ChriD/konnekting-TouchButtonSwitch/Bild 2.png

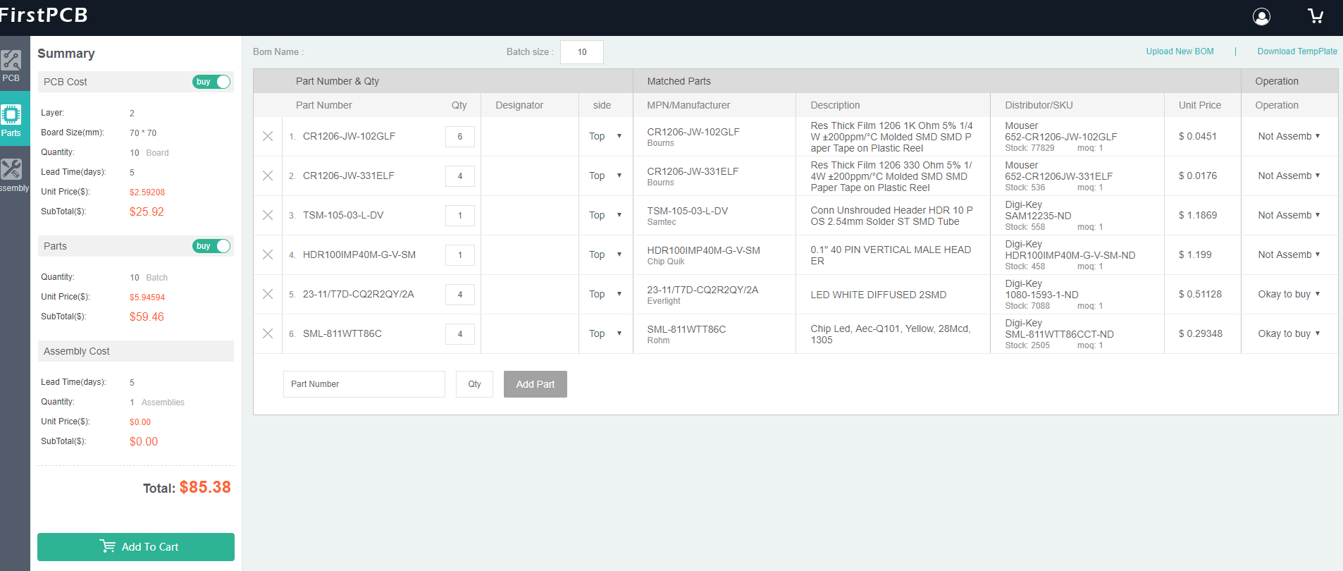
Bild 2.png
