ChriD/konnekting-TouchButtonSwitch/eagle/4xTouchTaster_Schematik.png

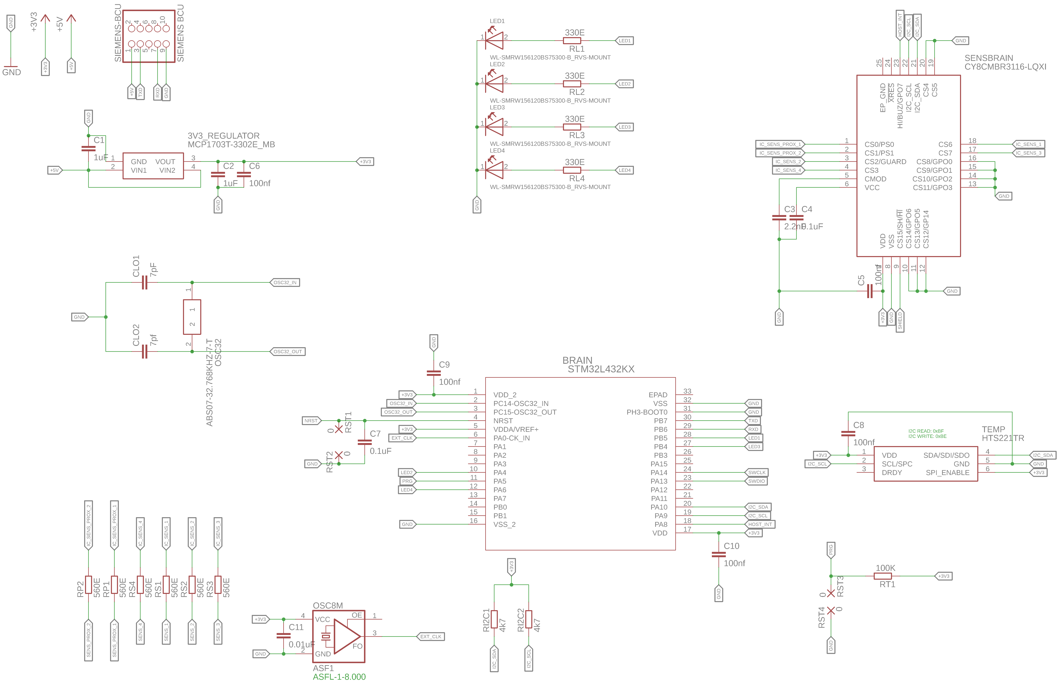
eagle/4xTouchTaster_Schematik.png
