ChriD/konnekting-TouchButtonSwitch/eagle/5ButtonSwitch.ItsyBitsyM0.Rev1.0.b.png

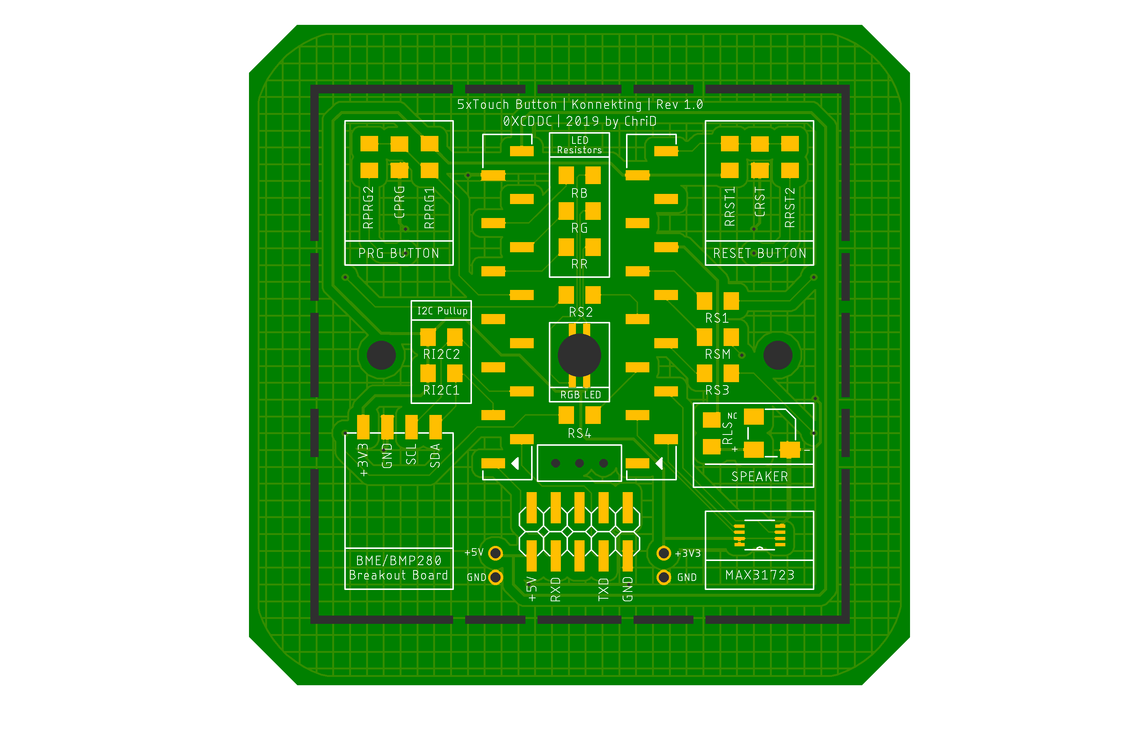
eagle/5ButtonSwitch.ItsyBitsyM0.Rev1.0.b.png
