ChriD/konnekting-TouchButtonSwitch/eagle/5ButtonSwitch.ItsyBitsyM0.Rev1.0.png

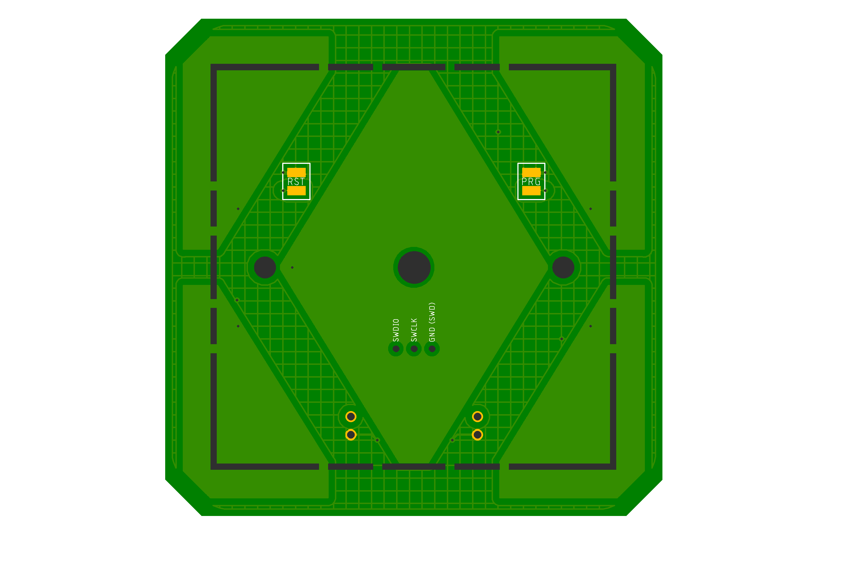
eagle/5ButtonSwitch.ItsyBitsyM0.Rev1.0.png
