ChriD/konnekting-TouchButtonSwitch/BOM.ods

 | Taster Stückliste
 |  |  |  |  | Dist | Package | Pins | Qty | Price
1 | TPS70933DBVT |  |  | TPS70933DBVT | TI | SOT95P280X145-5N | 5 | 1 | € 0,62 | € 0,62
2 | CGA2B3X7R1H104K050BB (https://product.tdk.com/en/search/capacitor/ceramic/mlcc/info?part_no=CGA2B3X7R1H104K050BB) |  | CGA2B3X7R1H104K050BE (https://www.mouser.at/ProductDetail/TDK/CGA2B3X7R1H104K050BE) | 100nF | TDK | C0402 | 2 | 9 | € 0,18 | € 1,61
3 | TDK C1005X5R0J475K050BC |  |  | 4.7 uf | TDK | C0402 | 2 | 1 | € 0,34 | € 0,34
 | C2 | C2 |  | 2.2uf | TDK | C0402 | 2 | 1
4 | CGA2B3X7R1H103K050BD | C1005X7R1H103K050BE (https://product.tdk.com/en/search/capacitor/ceramic/mlcc/info?part_no=C1005X7R1H103K050BE) |  | 10nf | TDK | C0402 | 2 | 1 | € 0,17 | € 0,17
5 | C1005X5R1V105K050BE (https://product.tdk.com/en/search/capacitor/ceramic/mlcc/info?part_no=C1005X5R1V105K050BE) | C1005X5R1V105K050BE (https://product.tdk.com/en/search/capacitor/ceramic/mlcc/info?part_no=C1005X5R1V105K050BE) | 35V | 1 uf | TDK | C0402 | 2 | 2 | € 0,16 | € 0,32
6 | CGA2B2X7R1H222K050BA (https://product.tdk.com/en/search/capacitor/ceramic/mlcc/info?part_no=CGA2B2X7R1H222K050BA) | C1005X7R1H222K050BE (https://product.tdk.com/en/search/capacitor/ceramic/mlcc/info?part_no=C1005X7R1H222K050BE) |  | 2.2 nF | TDK | C0402 | 2 | 1 | € 0,15 | € 0,15
7 | TDK CGA2B2C0G1H070D050BA |  |  | 7 pF | TDK | C0402 | 2 | 2 | € 0,09 | € 0,17
8 | Osram Opto LW P473-Q2S1-FKPL-1 |  |  |  | Osram | P47F-BOTTOM | 2 | 4 | € 0,83 | € 3,32
9 | STM32F303RET6 |  |  | STM32F303RET6 | STMicroelectronics | QFP50P1200X1200X160-64N | 64 | 1 | € 6,11 | € 6,11
10 | ABS07-32.768KHZ-7-T |  |  |  | Abracon | ABS-07 | 2 | 1 | € 0,58 | € 0,58
11 | MF-RES-0402-4.7K |  |  | 4.7k |  | R0402 | 2 | 2 |  | 0
12 |  |  |  | 330 ohm |  | R0402 | 2 | 4 |  | 0
13 |  |  | 17 | 460 ohm |  | R0402 | 2 | 7 |  | 0
14 | 5% 100mW |  |  | 100k |  | R0402 | 2 | 1 |  | 0
15 | Samtec TSM-105-03-L-DV |  |  |  | Samtec | 2X05SMD | 10 | 1 | € 1,40 | € 1,40
16 | Cypress Semiconductor CY8CMBR3116-LQXI |  |  | CY8CMBR3116-LQXI | Cypress | QFN50P400X400X60-25N | 24 | 1 | € 2,50 | € 2,50
17 | STMicroelectronics HTS221TR |  |  | HTS221TR | STMicroelectronics | HLGA-6L | 5 | 1 | € 2,95 | € 2,95
 |  | Count | Boards | Shipping | Assembly | Parts
 | https://www.allpcb.com/online_pcb_quote.html | 30 | 82 | 0 | 325 |  | 407
 | https://www.elecrow.com/services.html | 30 | 99 | 33 | 177 |  | 309
 | https://www.wellpcb.com/ | 30 | 73 | 0 | ?
 | https://www.pcbcart.com/de/quote | 30 | 315 | ? | ? |  | ?
 | https://www.pcbgogo.com | 30 | 146 | 36 | 50 |  | 232
 | https://www.seeedstudio.com/fusion_pcb.html | 30 | 154,81 | ? | ? |  | ?
