ChriD/konnekting-TouchButtonSwitch/BOM_Template_2017_06_30.xlsx

Designator | Manufacturer Part Number | Quantity
3V3_VR | TPS70933DBVT | 1
MCU | STM32F303RET6 | 1
SENSORMCU | CY8CMBR3116-LQXI | 1
TEMP | HTS221TR | 1
C11 | C1005X5R0J475K050BC | 1
