ChriD/konnekting-TouchButtonSwitch/58325233.xlsx

# | Menge | Teilenummer | Hersteller-Teilenummer | Beschreibung | Kundenreferenz | Lieferrückstände | Stückpreis | Gesamtpreis
1 | 15 | 1528-2554-ND | 3727 | ITSYBITSY M0 EXPRESS |  | 0 | 1036000 | 15540
2 | 25 | 1080-1593-1-ND | 23-11/T7D-CQ2R2QY/2A | LED WHITE DIFFUSED 2SMD |  | 0 | 40280 | 1007
3 | 5 | HDR100IMP40M-G-V-SM-ND | HDR100IMP40M-G-V-SM | CONN HEADER SMD 40POS 2.54MM |  | 0 | 95000 | 475
4 | 10 | SAM12235-ND | TSM-105-03-L-DV | CONN HEADER SMD 10POS 2.54MM |  | 0 | 93500 | 935
5 | 100 | CR1206-JW-331ELFCT-ND | CR1206-JW-331ELF | RES SMD 330 OHM 5% 1/4W 1206 |  | 0 | 1740 | 174
6 | 100 | CR1206-JW-102GLFCT-ND | CR1206-JW-102GLF | RES SMD 1K OHM 5% 1/4W 1206 |  | 0 | 2570 | 257
7 | 100 | CR1206-JW-103GLFCT-ND | CR1206-JW-103GLF | RES SMD 10K OHM 5% 1/4W 1206 |  | 0 | 2570 | 257
8 | 100 | 311-1435-1-ND | CC1206JRX7R9BB104 | CAP CER 0.1UF 50V X7R 1206 |  | 0 | 8810 | 881
9 | 8 | MAX31723MUA+TCT-ND | MAX31723MUA+T | SENSOR DIGITAL -55C-125C 8UMAX |  | 0 | 311000 | 2488
