ChriD/konnekting-TouchButtonSwitch/eagle/5ButtonSwitch.ItsyBitsyM0.Rev1.2.brd

## EAGLE design eagle/5ButtonSwitch.ItsyBitsyM0.Rev1.2.brd (2019-08-25)

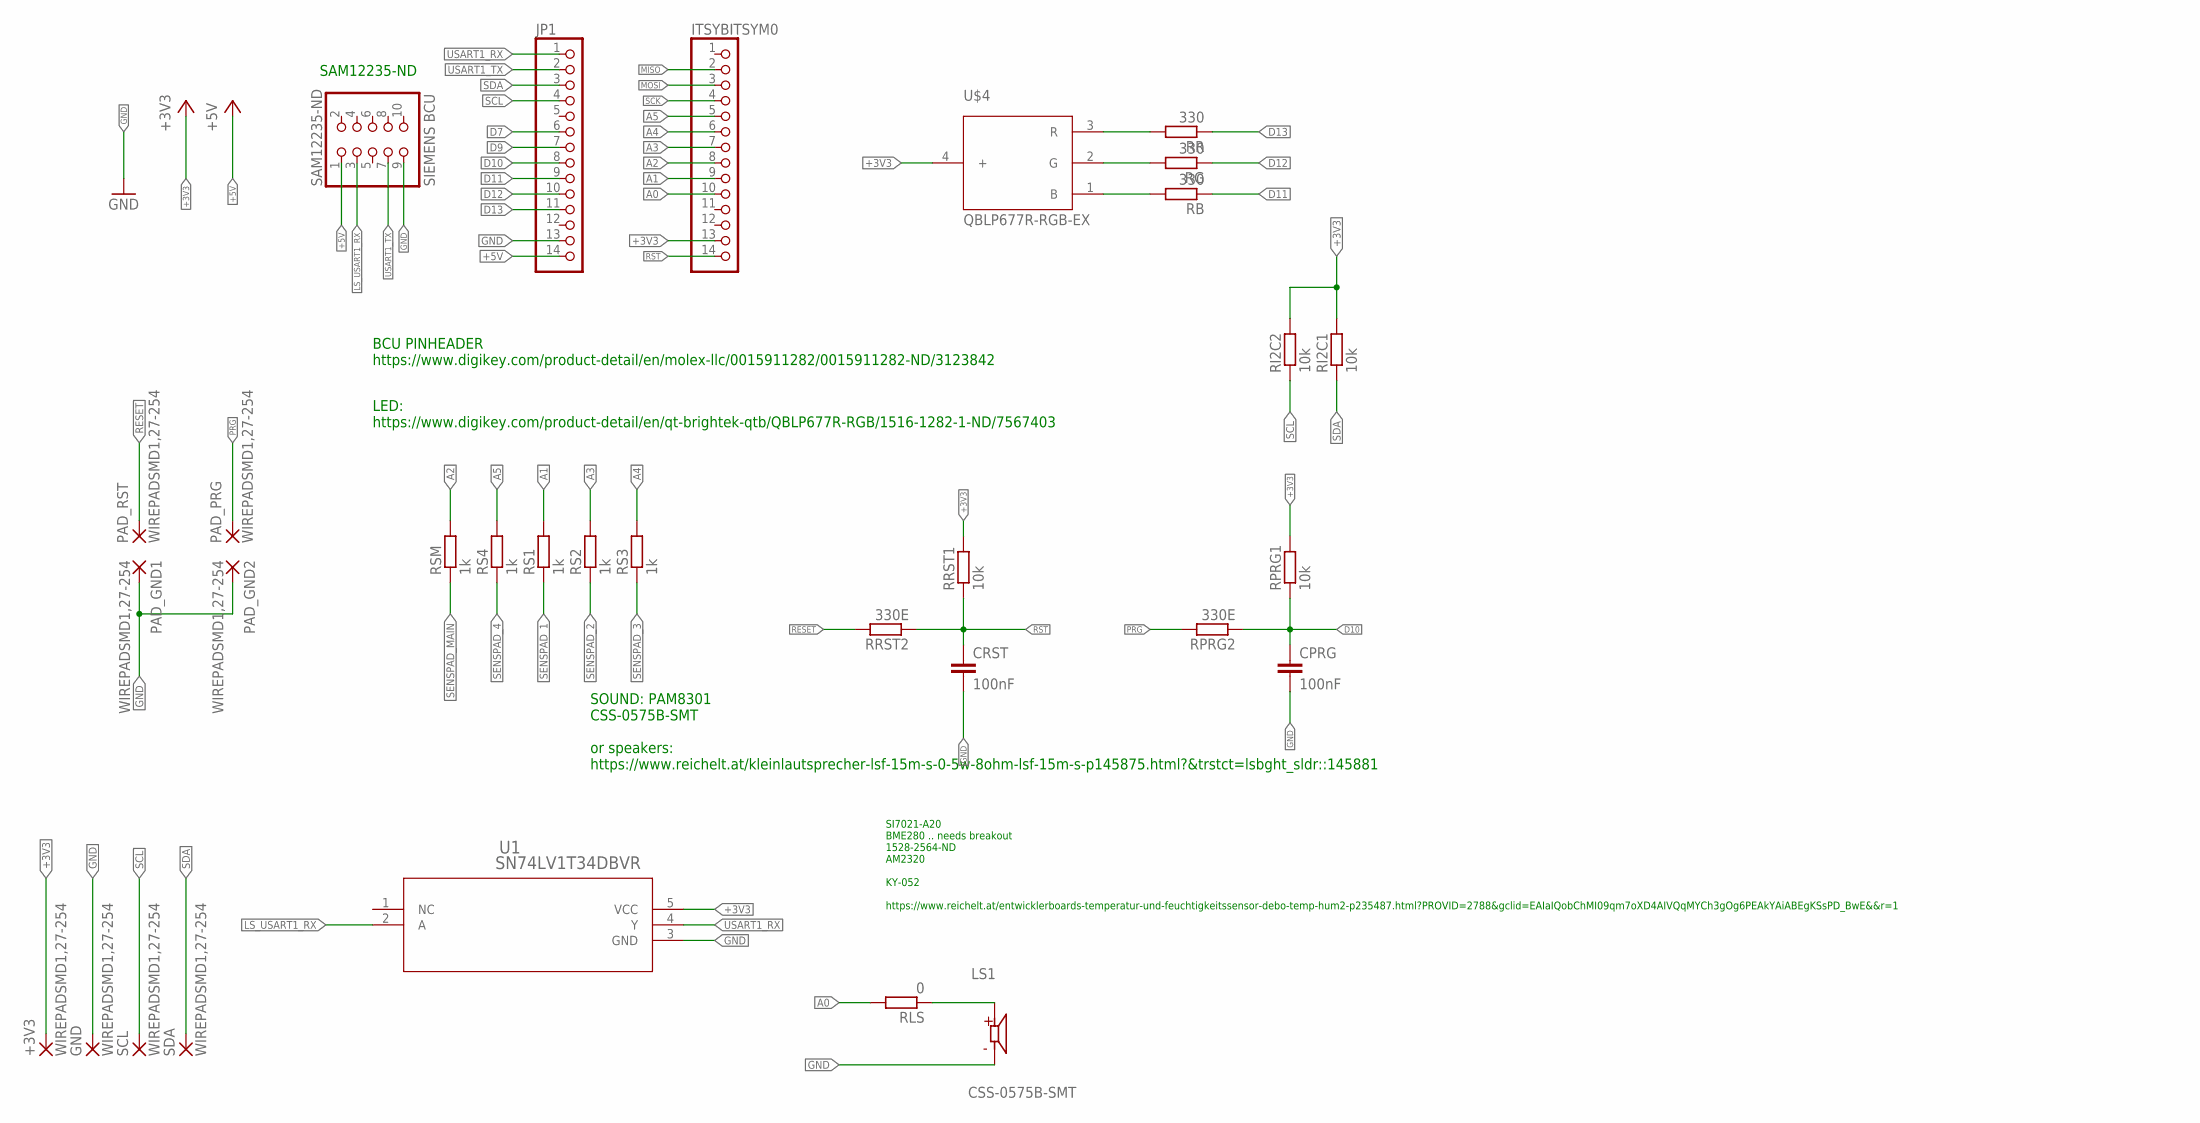
[picture p5: schematic 5ButtonSwitch.ItsyBitsyM0.Rev1.2.sch]

Parts:
+3V3: WIREPADSMD1,27-254; SMD1,27-2,54
CPRG: 100nF; C1206
CRST: 100nF; C1206
GND: WIREPADSMD1,27-254; SMD1,27-2,54
ITSYBITSYM0: PINHD-1X141X14_SMT; 1X14_SMT
JP1: PINHD-1X141X14_SMT; 1X14_SMT
LS1: CSS-0575B-SMT; CUI_CSS-0575B-SMT
PAD_GND1, PAD_GND2: WIREPADSMD1,27-254; SMD1,27-2,54
PAD_PRG: WIREPADSMD1,27-254; SMD1,27-2,54
PAD_RST: WIREPADSMD1,27-254; SMD1,27-2,54
RB: 330; R1206
RG: 330; R1206
RI2C1, RI2C2: 10k; R1206
RLS: 0; R1206
RPRG1: 10k; R1206
RPRG2: 330E; R1206
RR: 330; R1206
RRST1: 10k; R1206
RRST2: 330E; R1206
RS1, RS2, RS3, RS4: 1k; R1206
RSM: 1k; R1206
SAM12235-ND: SIEMENS BCU; 2X05SMD
SCL: WIREPADSMD1,27-254; SMD1,27-2,54
SDA: WIREPADSMD1,27-254; SMD1,27-2,54
U1: SN74LV1T34DBVR; DBV5
U$4: QBLP677R-RGB-EX; PLCC4R_EX

Connections:
+3V3: +3V3.1, ITSYBITSYM0.13, RI2C1.2, RI2C2.2, RPRG1.2, RRST1.2, U1.5 (VCC), U$4.4 (+)
+5V: JP1.14, SAM12235-ND.1
A0: ITSYBITSYM0.10, RLS.2
A1: ITSYBITSYM0.9, RS1.2
A2: ITSYBITSYM0.8, RSM.2
A3: ITSYBITSYM0.7, RS2.2
A4: ITSYBITSYM0.6, RS3.2
A5: ITSYBITSYM0.5, RS4.2
D7: JP1.6
D9: JP1.7
D10: CPRG.1, JP1.8, RPRG1.1, RPRG2.1
D11: JP1.9, RB.1
D12: JP1.10, RG.1
D13: JP1.11, RR.1
GND: CPRG.2, CRST.2, GND.1, JP1.13, LS1.2 (N), PAD_GND1.1, PAD_GND2.1, SAM12235-ND.9, U1.3 (GND)
LS_USART1_RX: SAM12235-ND.3, U1.2 (A)
MISO: ITSYBITSYM0.2
MOSI: ITSYBITSYM0.3
unnamed: RB.2, U$4.1 (B)
unnamed: RG.2, U$4.2 (G)
unnamed: RR.2, U$4.3 (R)
unnamed: LS1.1, RLS.1
PRG: PAD_PRG.1, RPRG2.2
RESET: PAD_RST.1, RRST2.2
RST: CRST.1, ITSYBITSYM0.14, RRST1.1, RRST2.1
SCK: ITSYBITSYM0.4
SCL: JP1.4, RI2C2.1, SCL.1
SDA: JP1.3, RI2C1.1, SDA.1
SENSPAD_1: RS1.1
SENSPAD_2: RS2.1
SENSPAD_3: RS3.1
SENSPAD_4: RS4.1
SENSPAD_MAIN: RSM.1
USART1_RX: JP1.1, U1.4 (Y)
USART1_TX: JP1.2, SAM12235-ND.7

Notes on the sheet:
SAM12235-ND
BCU PINHEADER https://www.digikey.com/product-detail/en/molex-llc/0015911282/0015911282-ND/3123842
LED: https://www.digikey.com/product-detail/en/qt-brightek-qtb/QBLP677R-RGB/1516-1282-1-ND/7567403
SI7021-A20 BME280 .. needs breakout 1528-2564-ND AM2320 KY-052 https://www.reichelt.at/entwicklerboards-temperatur-und-feuchtigkeitssensor-debo-temp-hum2-p235487.html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
SOUND: PAM8301 CSS-0575B-SMT or speakers: https://www.reichelt.at/kleinlautsprecher-lsf-15m-s-0-5w-8ohm-lsf-15m-s-p145875.html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

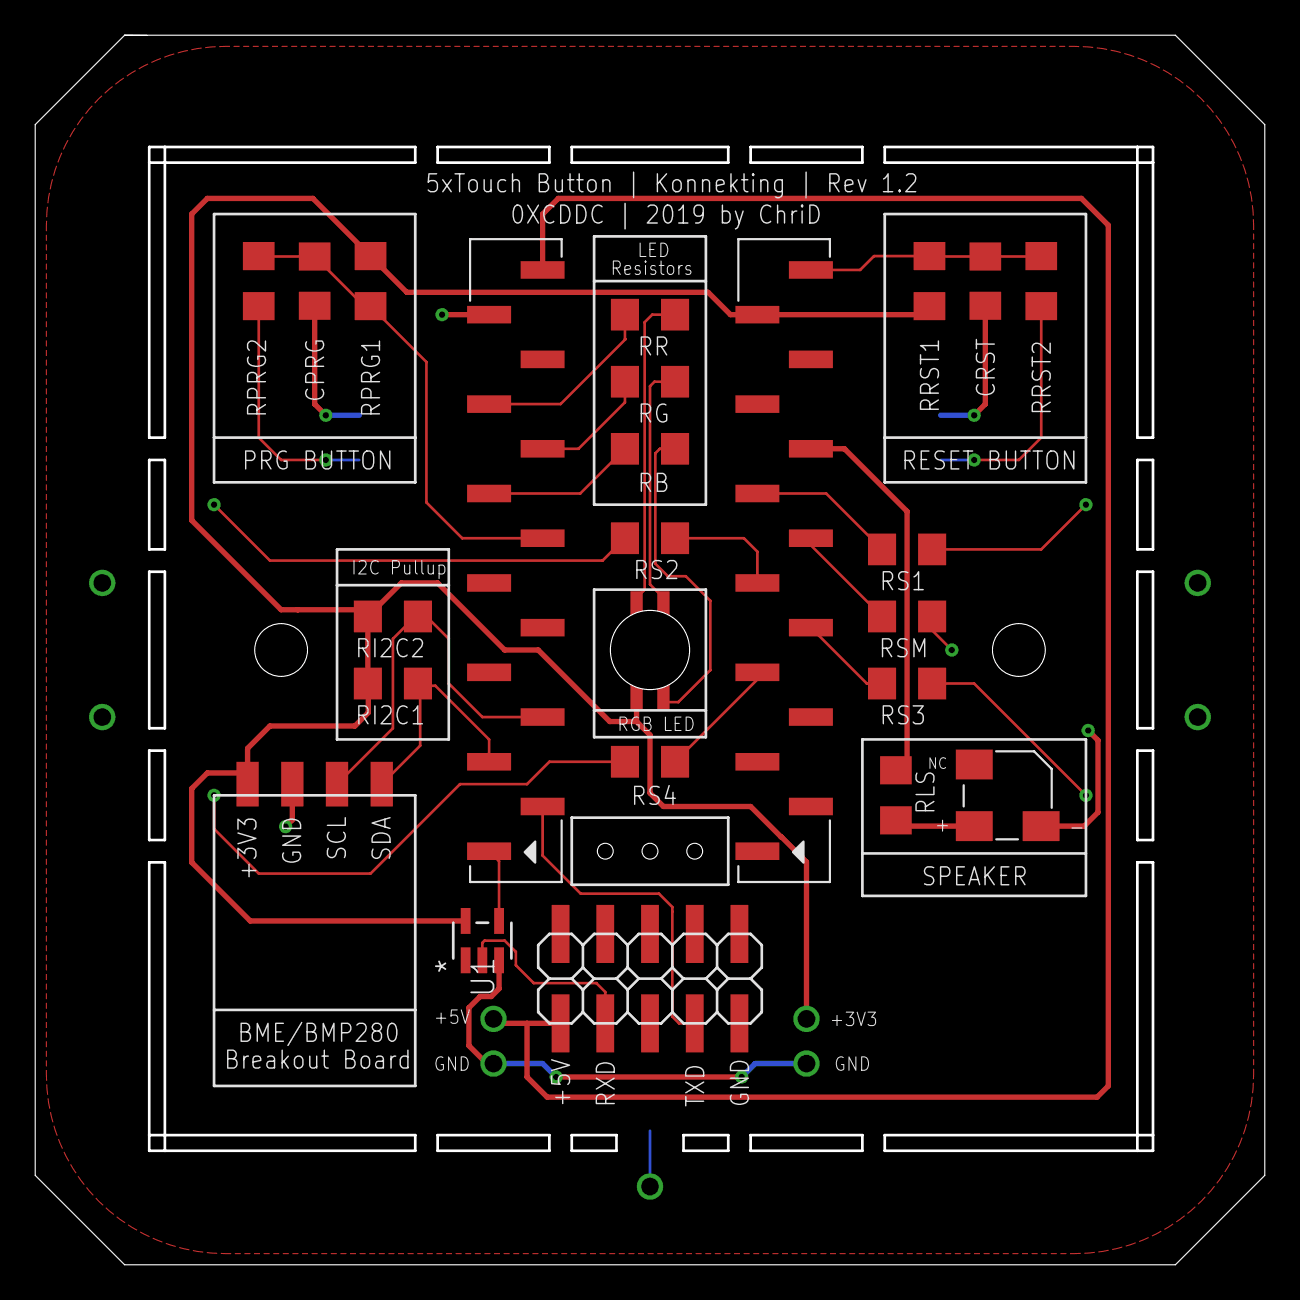
[picture p6: board 5ButtonSwitch.ItsyBitsyM0.Rev1.2.brd from above]

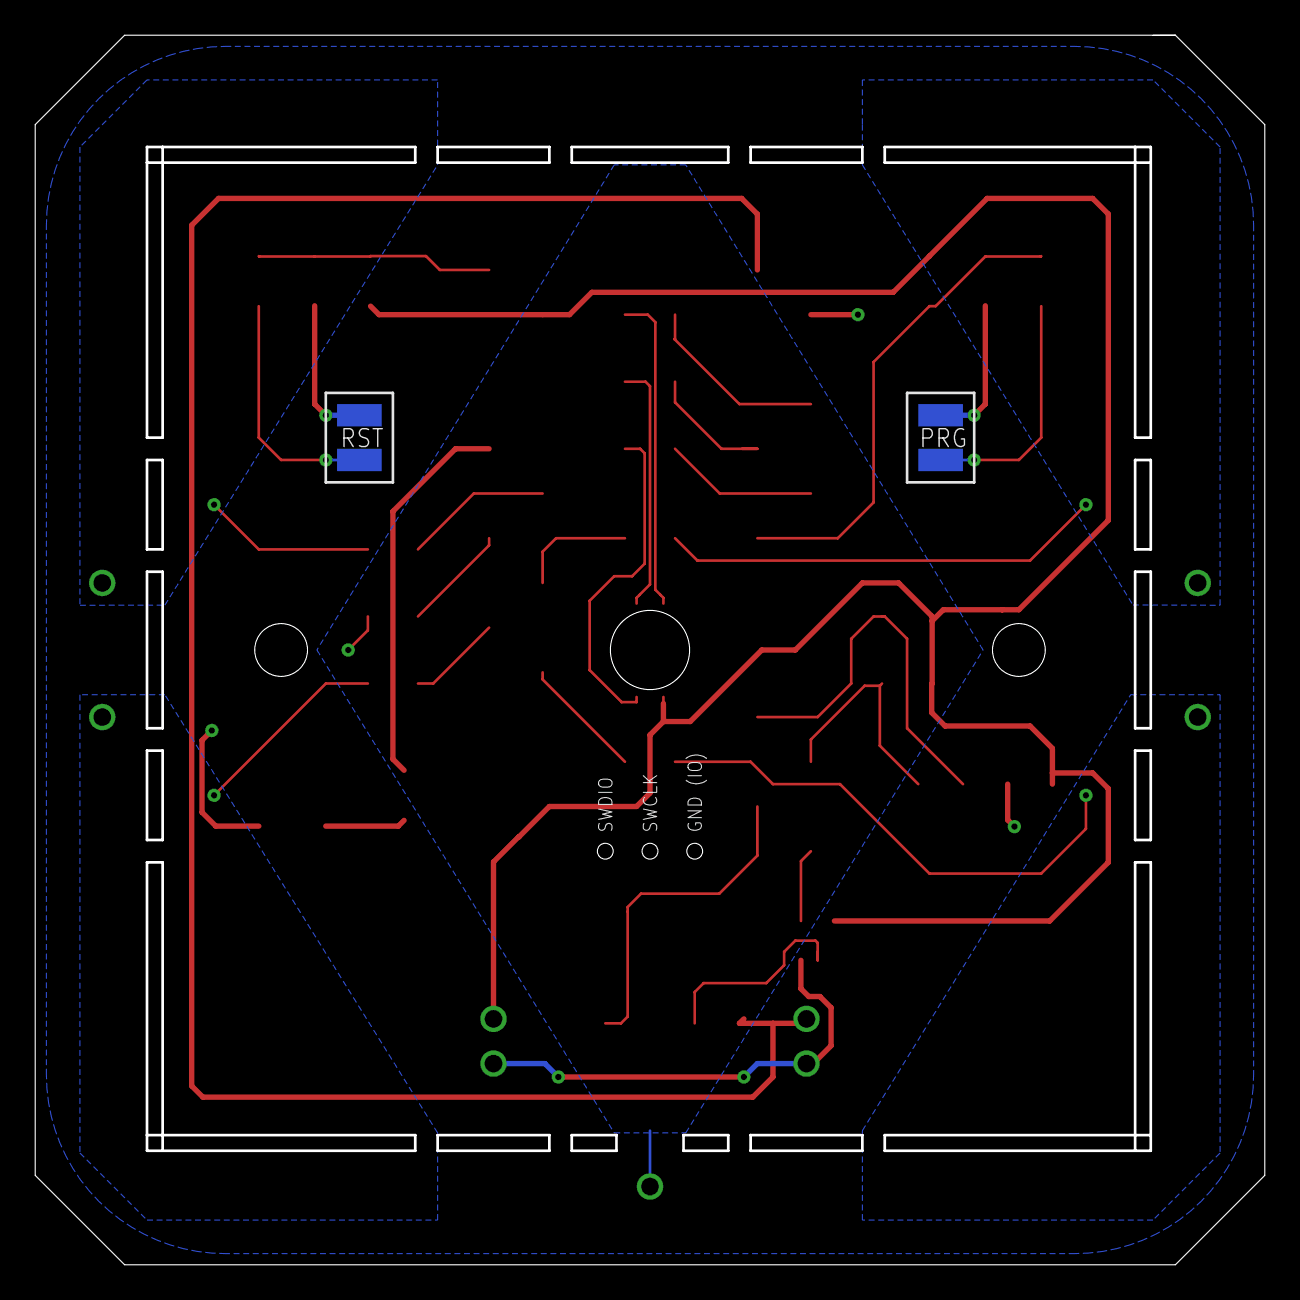
[picture p7: board 5ButtonSwitch.ItsyBitsyM0.Rev1.2.brd from below]

Board: 2 copper layers, 69.8 x 69.8 mm, 31 parts (4 on the bottom side), 25 nets.
