ChriD/konnekting-TouchButtonSwitch/eagle/1ButtonSwitch.ItsyBitsyM0.Rev1.0.brd

## EAGLE design eagle/1ButtonSwitch.ItsyBitsyM0.Rev1.0.brd (2019-03-04)

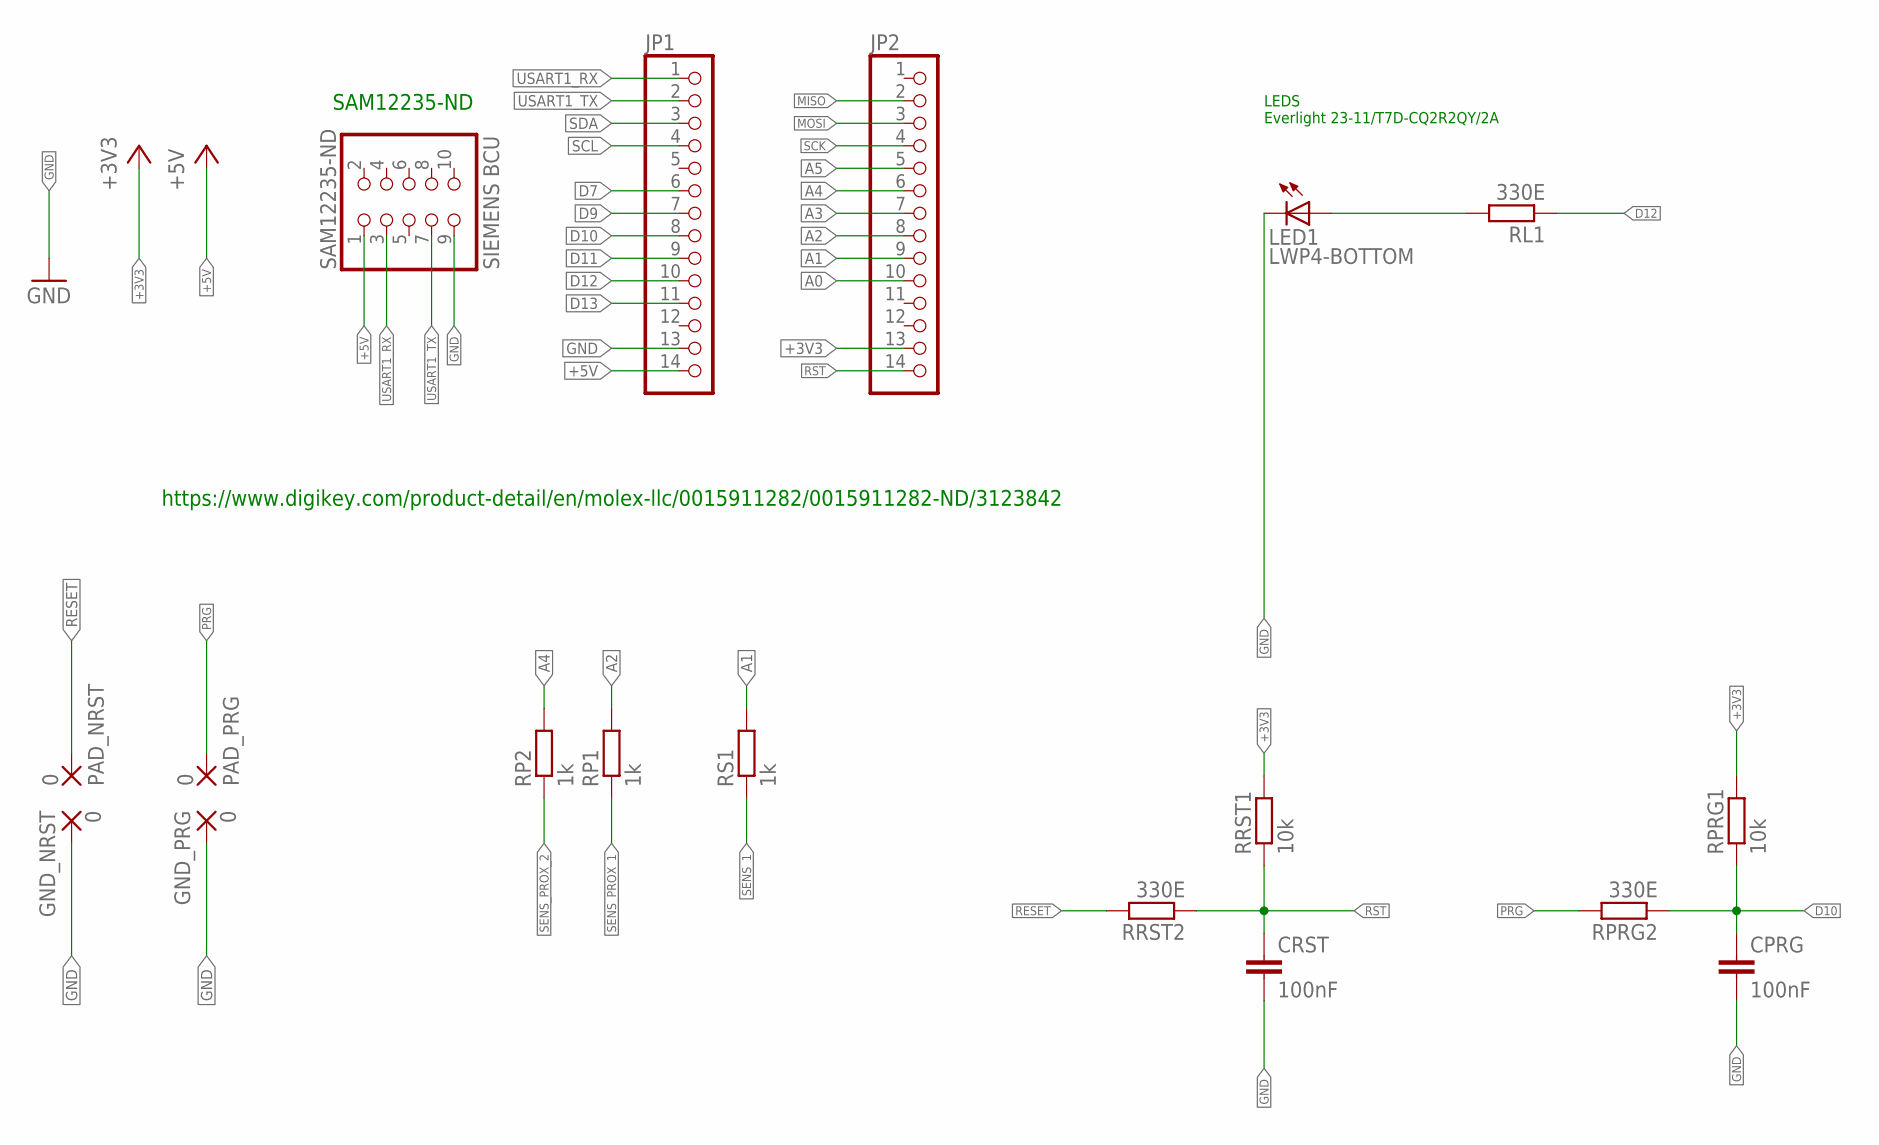
[picture p8: schematic 1ButtonSwitch.ItsyBitsyM0.Rev1.0.sch]

Parts:
CPRG: 100nF; C1206
CRST: 100nF; C1206
GND_NRST: 0; SMD2,54-5,08
GND_PRG: 0; SMD2,54-5,08
JP1, JP2: PINHD-1X141X14_SMT; 1X14_SMT
LED1: LWP4-BOTTOM; P47F-BOTTOM
PAD_NRST: 0; SMD2,54-5,08
PAD_PRG: 0; SMD2,54-5,08
RL1: 330E; R1206
RP1, RP2: 1k; R1206
RPRG1: 10k; R1206
RPRG2: 330E; R1206
RRST1: 10k; R1206
RRST2: 330E; R1206
RS1: 1k; R1206
SAM12235-ND: SIEMENS BCU; 2X05SMD

Connections:
+3V3: JP2.13, RPRG1.2, RRST1.2
+5V: JP1.14, SAM12235-ND.1
A0: JP2.10
A1: JP2.9, RS1.2
A2: JP2.8, RP1.2
A3: JP2.7
A4: JP2.6, RP2.2
A5: JP2.5
D7: JP1.6
D9: JP1.7
D10: CPRG.1, JP1.8, RPRG1.1, RPRG2.1
D11: JP1.9
D12: JP1.10, RL1.1
D13: JP1.11
GND: CPRG.2, CRST.2, GND_NRST.1, GND_PRG.1, JP1.13, LED1.C, SAM12235-ND.9
MISO: JP2.2
MOSI: JP2.3
unnamed: LED1.A, RL1.2
PRG: PAD_PRG.1, RPRG2.2
RESET: PAD_NRST.1, RRST2.2
RST: CRST.1, JP2.14, RRST1.1, RRST2.1
SCK: JP2.4
SCL: JP1.4
SDA: JP1.3
SENS_1: RS1.1
SENS_PROX_1: RP1.1
SENS_PROX_2: RP2.1
USART1_RX: JP1.1, SAM12235-ND.3
USART1_TX: JP1.2, SAM12235-ND.7

Notes on the sheet:
SAM12235-ND
LEDS Everlight 23-11/T7D-CQ2R2QY/2A
https://www.digikey.com/product-detail/en/molex-llc/0015911282/0015911282-ND/3123842

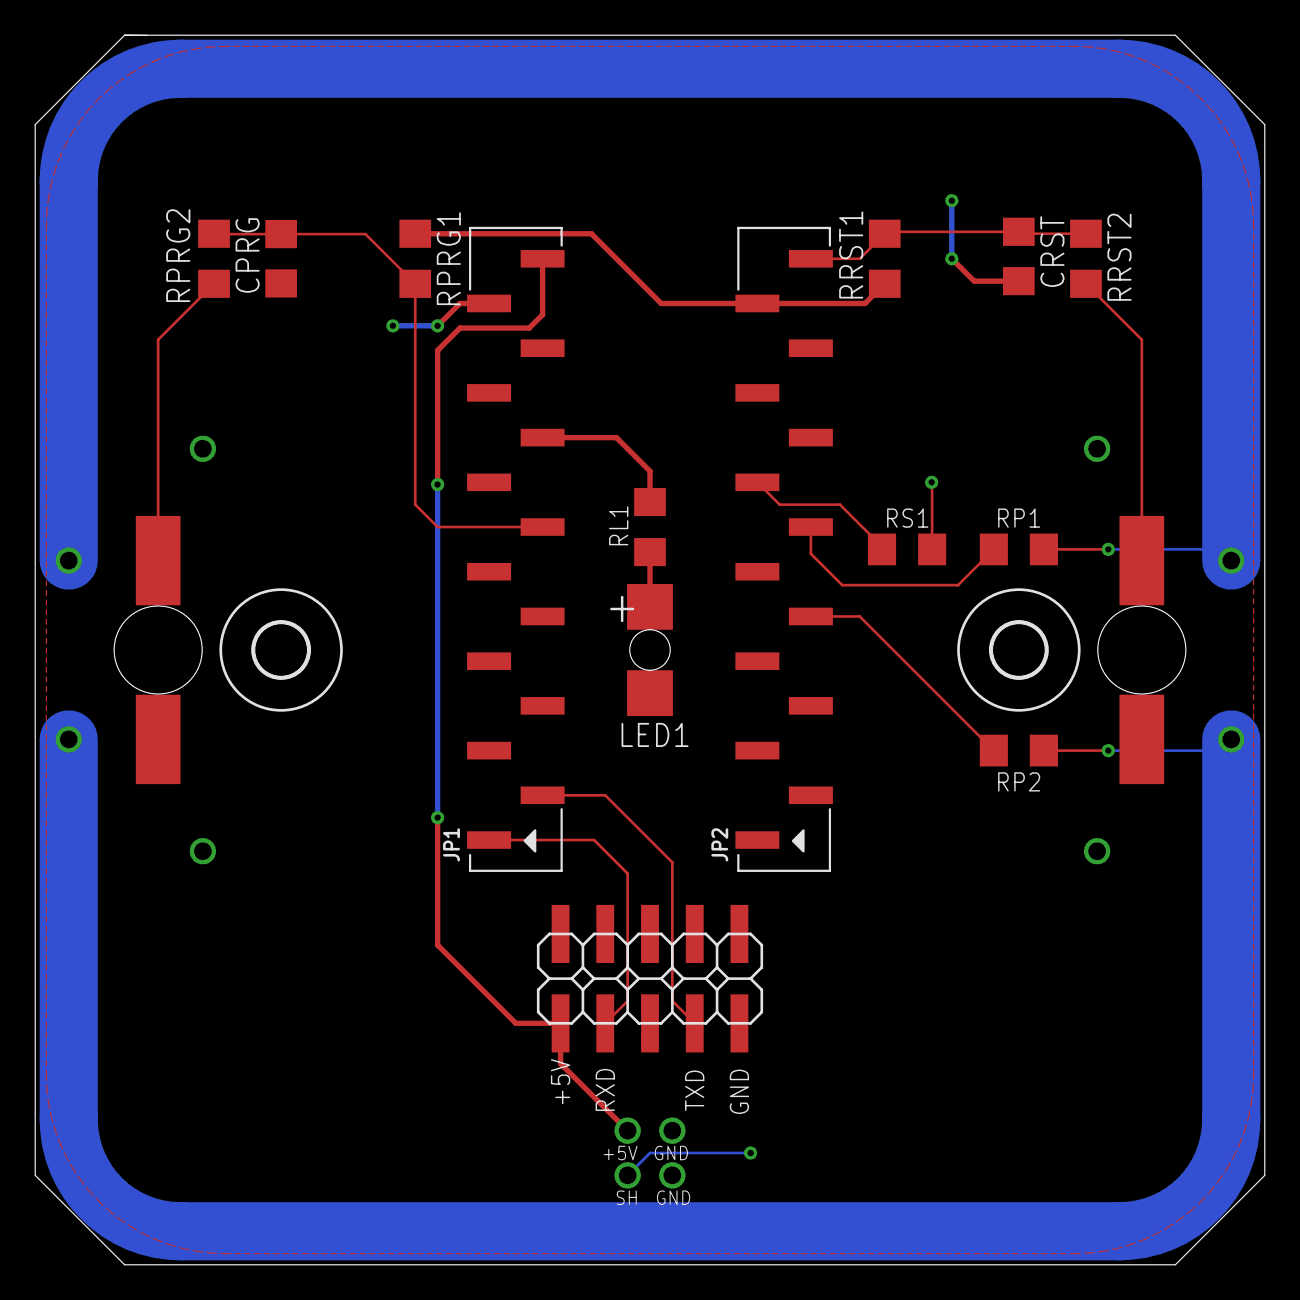
[picture p9: board 1ButtonSwitch.ItsyBitsyM0.Rev1.0.brd from above]

Board: 2 copper layers, 69.8 x 69.8 mm, 20 parts (0 on the bottom side), 14 nets.

Other parts of the board:
U$1, U$2: 3,0
