ChriD/konnekting-TouchButtonSwitch/eagle/4ButtonSwitch.Rev3.0.brd

## EAGLE design eagle/4ButtonSwitch.Rev3.0.brd (2018-12-17, an earlier design)

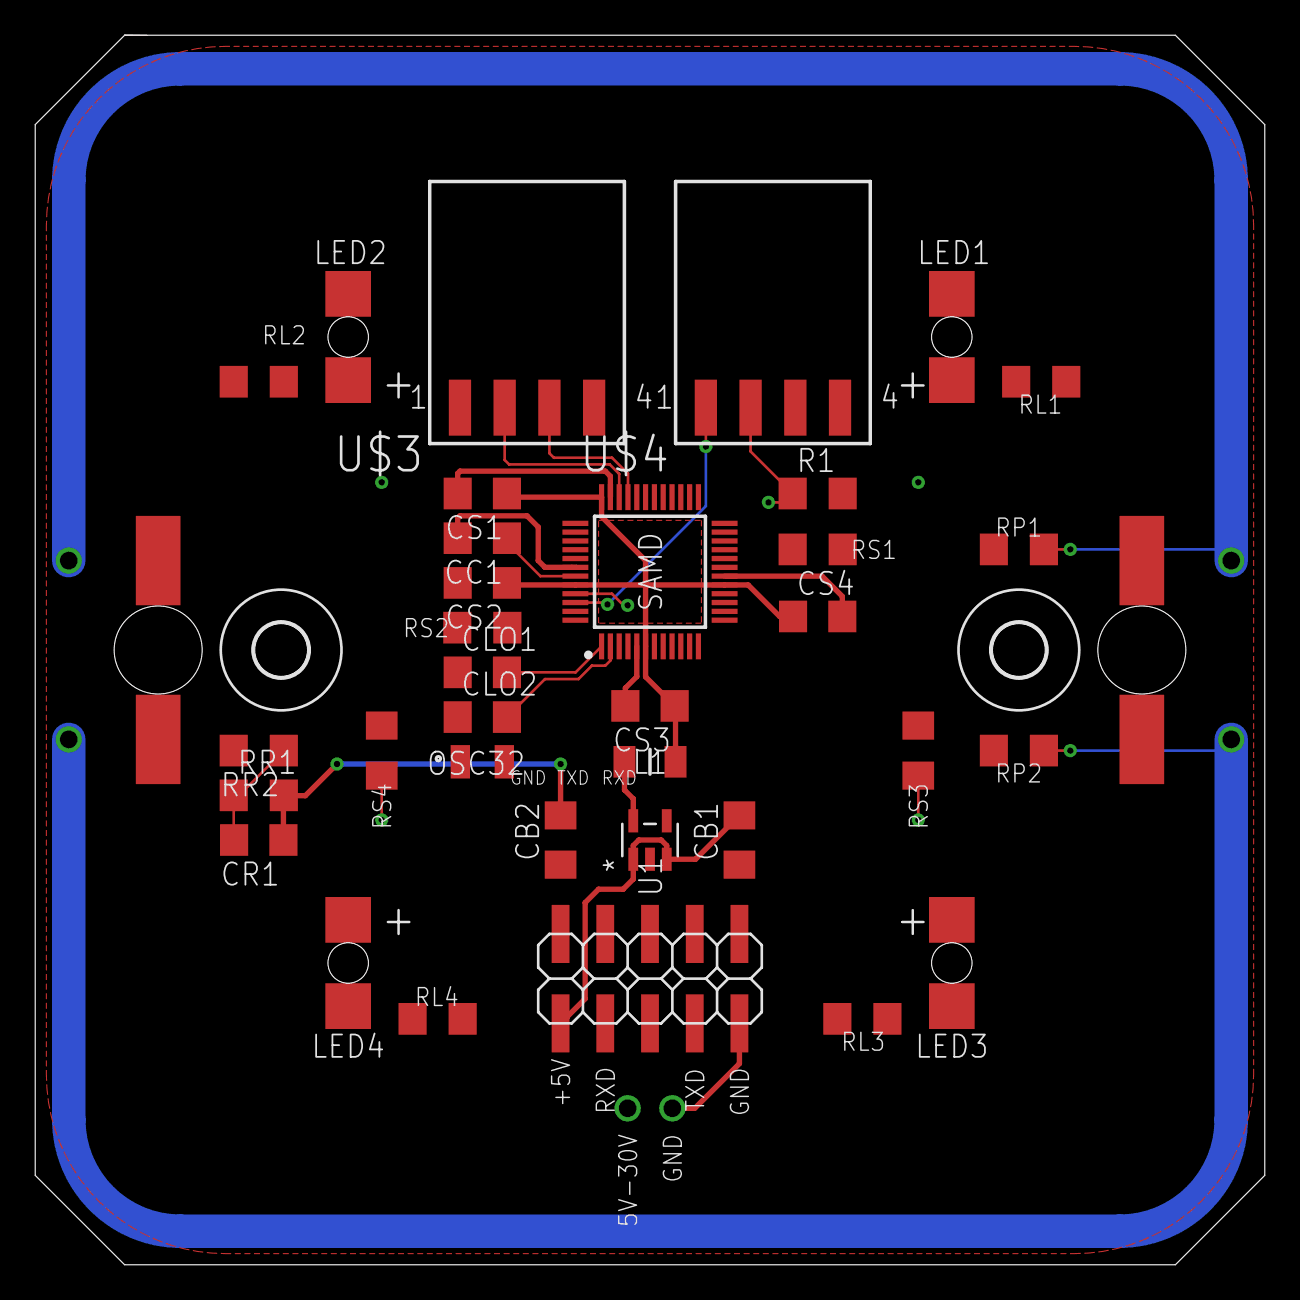
[picture p10: board 4ButtonSwitch.Rev3.0.brd from above]

Board: 2 copper layers, 69.8 x 69.8 mm, 40 parts (0 on the bottom side), 23 nets.

Parts:
CB1: 4.7uF; C1206
CB2: 10uF; C1206
CC1: 1uF; C1206
CLO1, CLO2: 15pF; C1206
CR1: 100pF; C1206
CS1, CS2, CS3, CS4: 100nf; C1206
GND_NRST: 0; SMD2,54-5,08
GND_PRG: 0; SMD2,54-5,08
L1: LQM31PN1R0M00L; INDC3216X95N
LED1, LED2, LED3, LED4: LWP4-BOTTOM; P47F-BOTTOM
OSC32: ABS07-32.768KHZ-7-T; ABS-07
PAD_NRST: 0; SMD2,54-5,08
PAD_PRG: 0; SMD2,54-5,08
R1: 1k; R1206
RL1, RL2, RL3, RL4: 330E; R1206
RP1, RP2: 1k; R1206
RR1: 2.2k; R1206
RR2: 330E; R1206
RS1, RS2, RS3, RS4: 1k; R1206
SAM12235-ND: SIEMENS BCU; 2X05SMD
SAMD: ATSAMD21G18A-AU; QFP50P900X900X120-48N
U1: ADP2108AUJZ-3.3-R7; UJ_5
U$1, U$2: 3,0
U$3, U$4: SAMTEC-TSM-104-01-X-SHJ; SAMTEC-TSM-104-01-X-SH

Connections:
+3V3: CB2.2, CR1.1, CS1.1, CS2.1, CS3.1, CS4.1, L1.2, R1.2, RR1.2, SAMD.6, SAMD.17, SAMD.36, SAMD.44, U1.4
+5V: CB1.2, SAM12235-ND.1, U1.1, U1.3
GND: CB1.1, CB2.1, CC1.2, CLO1.1, CLO2.1, CS1.2, CS2.2, CS3.2, CS4.2, GND_NRST.1, GND_PRG.1, LED1.C, LED2.C, LED3.C, LED4.C, SAM12235-ND.9, SAMD.5, SAMD.18, SAMD.35, SAMD.42, U1.2, U$3.1, U$4.4
unnamed: L1.1, U1.5
unnamed: LED1.A, RL1.2
unnamed: LED2.A, RL2.2
unnamed: LED3.A, RL3.2
unnamed: LED4.A, RL4.2
NRST: CR1.2, RR1.1, RR2.1, SAMD.40
PA02: RS4.2, SAMD.3
PA04: RP2.2, SAMD.9
PA05: RP1.2, SAMD.10
PA07: RS1.2, SAMD.12
PB02: RS2.2, SAMD.47
PB08: RS3.2, SAMD.7
RESET: PAD_NRST.1, RR2.2, U$4.3
SWCLK: R1.1, SAMD.45, U$4.2
SWDIO: SAMD.46, U$4.1
USB+: SAMD.34, U$3.2
USB-: SAMD.33, U$3.3
VDDCORE: CC1.1, SAMD.43
X32IN: CLO1.2, OSC32.1, SAMD.1
X32OUT: CLO2.2, OSC32.2, SAMD.2
