ChriD/konnekting-TouchButtonSwitch/eagle/4ButtonSwitch.Rev2.2.brd

## EAGLE design eagle/4ButtonSwitch.Rev2.2.brd (2018-08-30, an earlier design)

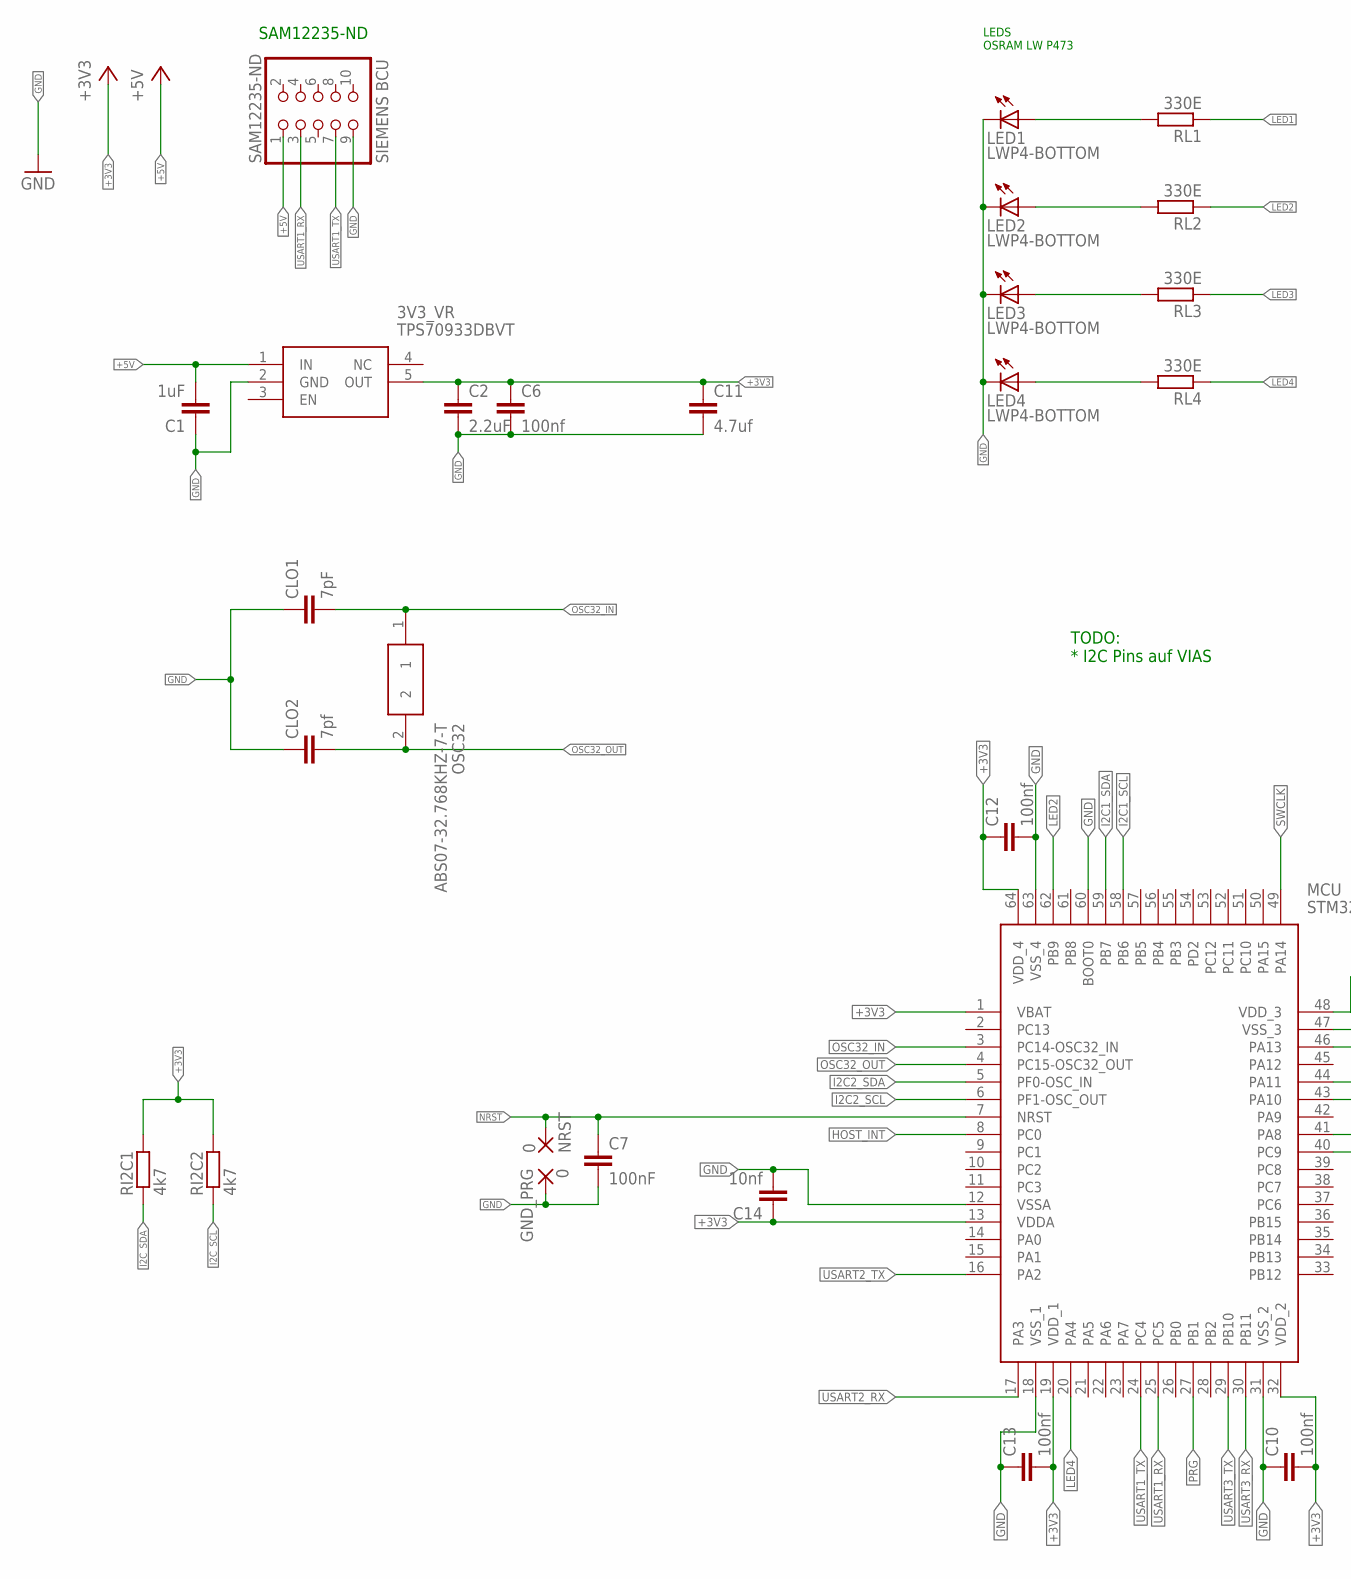
[picture p11: schematic 4ButtonSwitch.Rev2.2.sch, part in row 1, column 1]

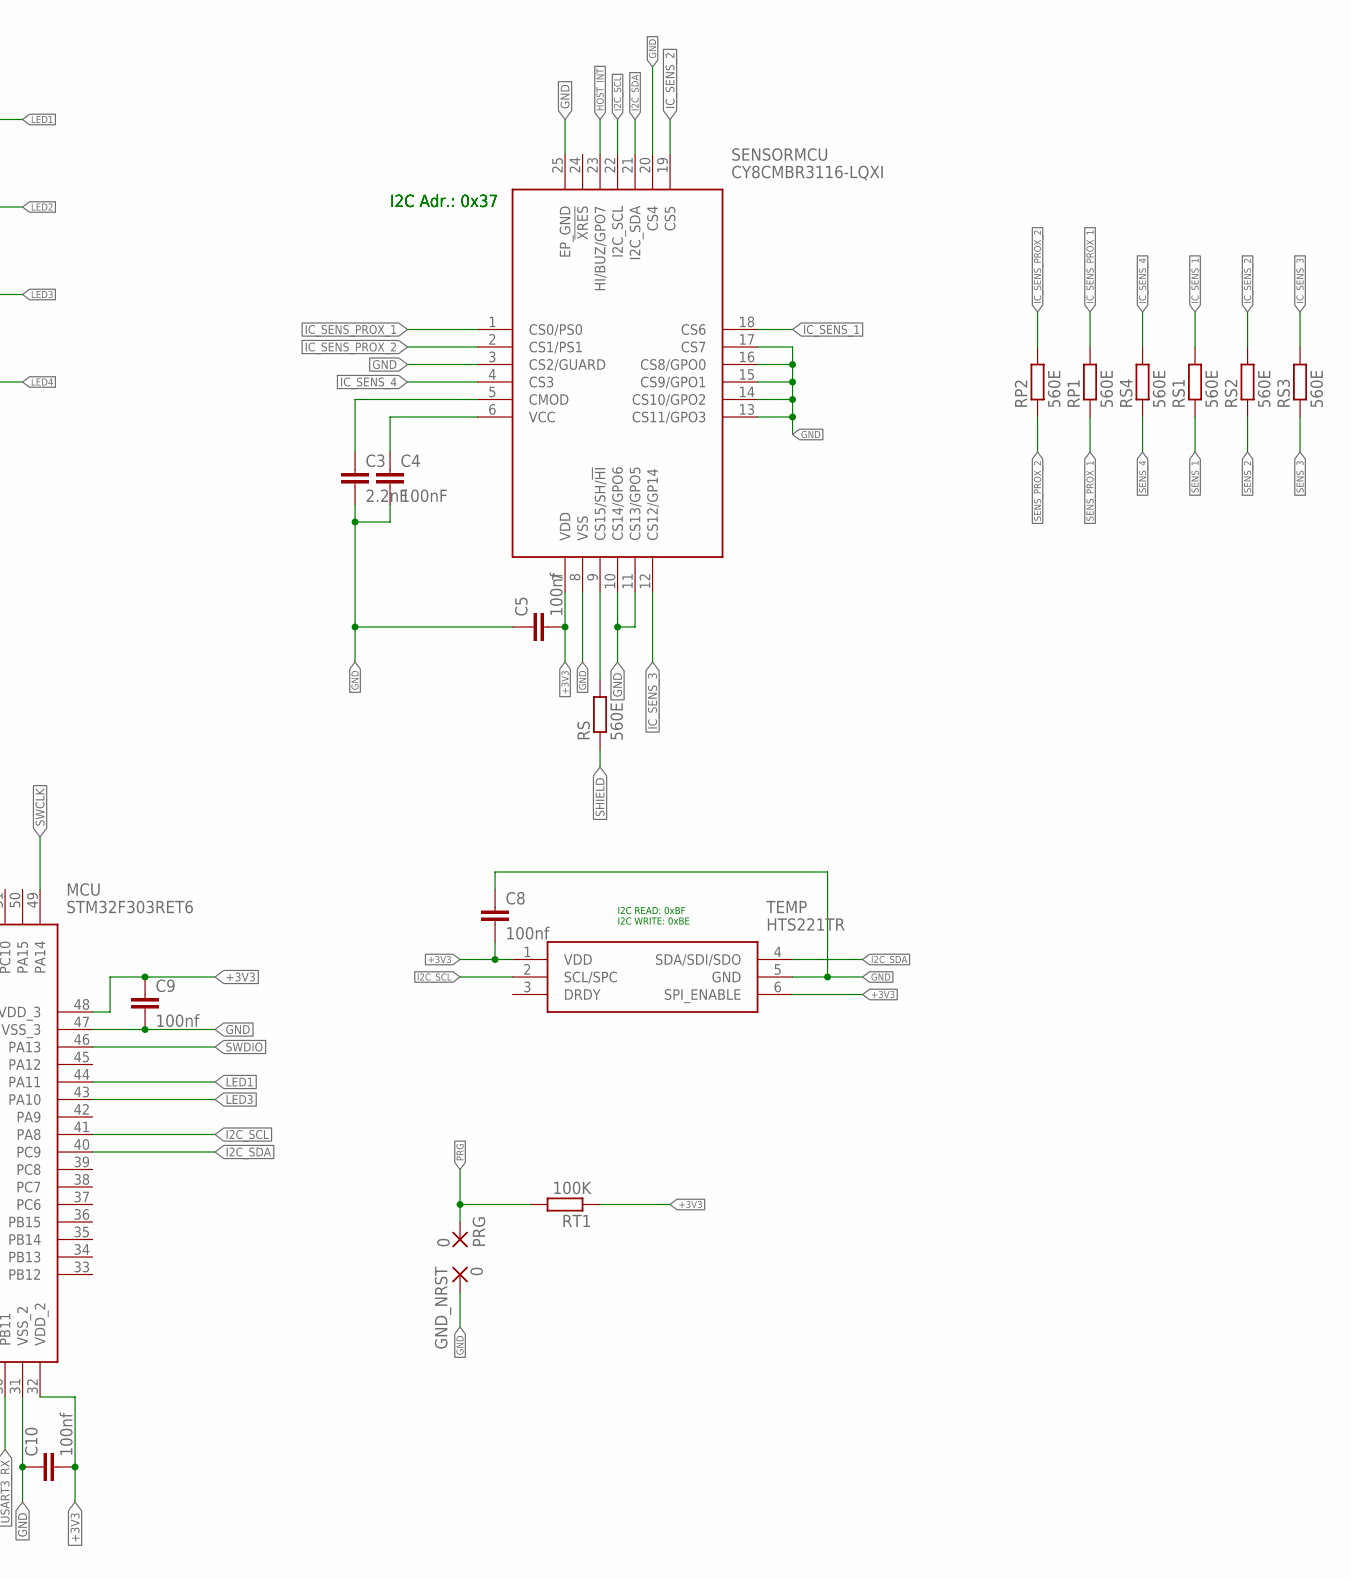
[picture p12: schematic 4ButtonSwitch.Rev2.2.sch, part in row 1, column 2]

Parts:
3V3_VR: TPS70933DBVT; SOT95P280X145-5N
C1: 1uF; C0402
C2: 2.2uF; C0402
C3: 2.2nF; C0402
C4, C7: 100nF; C0402
C5, C6, C8, C9, C10, C12, C13: 100nf; C0402
C11: 4.7uf; C0402
C14: 10nf; C0402
CLO1: 7pF; C0402
CLO2: 7pf; C0402
GND_NRST: 0; SMD2,54-5,08
GND_PRG: 0; SMD2,54-5,08
LED1, LED2, LED3, LED4: LWP4-BOTTOM; P47F-BOTTOM
MCU: STM32F303RET6; QFP50P1200X1200X160-64N
NRST: 0; SMD2,54-5,08
OSC32: ABS07-32.768KHZ-7-T; ABS-07
PRG: 0; SMD2,54-5,08
RI2C1, RI2C2: 4k7; R0402
RL1, RL2, RL3, RL4: 330E; R0402
RP1, RP2: 560E; R0402
RS, RS1, RS2, RS3, RS4: 560E; R0402
RT1: 100K; R0402
SAM12235-ND: SIEMENS BCU; 2X05SMD
SENSORMCU: CY8CMBR3116-LQXI; QFN50P400X400X60-25N
TEMP: HTS221TR; HLGA-6L

Connections:
+3V3: 3V3_VR.5 (OUT), C2.1, C5.2, C6.1, C8.2, C9.1, C10.2, C11.1, C12.1, C13.2, C14.1, MCU.1 (VBAT), MCU.13 (VDDA), MCU.19 (VDD_1), MCU.32 (VDD_2), MCU.48 (VDD_3), MCU.64 (VDD_4), RI2C1.2, RI2C2.2, RT1.1, SENSORMCU.7 (VDD), TEMP.1 (VDD), TEMP.6 (SPI_ENABLE)
+5V: 3V3_VR.1 (IN), C1.2, SAM12235-ND.1
CMOD: C3.1, SENSORMCU.5 (CMOD)
GND: 3V3_VR.2 (GND), C1.1, C2.2, C3.2, C4.2, C5.1, C6.2, C7.2, C8.1, C9.2, C10.1, C11.2, C12.2, C13.1, C14.2, CLO1.1, CLO2.1, GND_NRST.1, GND_PRG.1, LED1.C, LED2.C, LED3.C, LED4.C, MCU.12 (VSSA), MCU.18 (VSS_1), MCU.31 (VSS_2), MCU.47 (VSS_3), MCU.60 (BOOT0), MCU.63 (VSS_4), SAM12235-ND.9, SENSORMCU.3 (CS2/GUARD), SENSORMCU.8 (VSS), SENSORMCU.10 (CS14/GPO6), SENSORMCU.11 (CS13/GPO5), SENSORMCU.13 (CS11/GPO3), SENSORMCU.14 (CS10/GPO2), SENSORMCU.15 (CS9/GPO1), SENSORMCU.16 (CS8/GPO0), SENSORMCU.17 (CS7), SENSORMCU.20 (CS4), SENSORMCU.25 (EP_GND), TEMP.5 (GND)
HOST_INT: MCU.8 (PC0), SENSORMCU.23 (HI/BUZ/GPO7)
I2C1_SCL: MCU.58 (PB6)
I2C1_SDA: MCU.59 (PB7)
I2C2_SCL: MCU.6 (PF1-OSC_OUT)
I2C2_SDA: MCU.5 (PF0-OSC_IN)
I2C_SCL: MCU.41 (PA8), RI2C2.1, SENSORMCU.22 (I2C_SCL), TEMP.2 (SCL/SPC)
I2C_SDA: MCU.40 (PC9), RI2C1.1, SENSORMCU.21 (I2C_SDA), TEMP.4 (SDA/SDI/SDO)
IC_SENS_1: RS1.2, SENSORMCU.18 (CS6)
IC_SENS_2: RS2.2, SENSORMCU.19 (CS5)
IC_SENS_3: RS3.2, SENSORMCU.12 (CS12/GP14)
IC_SENS_4: RS4.2, SENSORMCU.4 (CS3)
IC_SENS_PROX_1: RP1.2, SENSORMCU.1 (CS0/PS0)
IC_SENS_PROX_2: RP2.2, SENSORMCU.2 (CS1/PS1)
LED1: MCU.44 (PA11), RL1.1
LED2: MCU.62 (PB9), RL2.1
LED3: MCU.43 (PA10), RL3.1
LED4: MCU.20 (PA4), RL4.1
unnamed: RS.2, SENSORMCU.9 (CS15/SH/!HI)
unnamed: LED1.A, RL1.2
unnamed: LED2.A, RL2.2
unnamed: LED3.A, RL3.2
unnamed: LED4.A, RL4.2
NRST: C7.1, MCU.7 (NRST), NRST.1
OSC32_IN: CLO1.2, MCU.3 (PC14-OSC32_IN), OSC32.1
OSC32_OUT: CLO2.2, MCU.4 (PC15-OSC32_OUT), OSC32.2
PRG: MCU.27 (PB1), PRG.1, RT1.2
SENS_1: RS1.1
SENS_2: RS2.1
SENS_3: RS3.1
SENS_4: RS4.1
SENS_PROX_1: RP1.1
SENS_PROX_2: RP2.1
SHIELD: RS.1
SWCLK: MCU.49 (PA14)
SWDIO: MCU.46 (PA13)
USART1_RX: MCU.25 (PC5), SAM12235-ND.3
USART1_TX: MCU.24 (PC4), SAM12235-ND.7
USART2_RX: MCU.17 (PA3)
USART2_TX: MCU.16 (PA2)
USART3_RX: MCU.30 (PB11)
USART3_TX: MCU.29 (PB10)
VCC: C4.1, SENSORMCU.6 (VCC)

Notes on the sheet:
I2C READ: 0xBF I2C WRITE: 0xBE
I2C Adr.: 0x37
SAM12235-ND
TODO: * I2C Pins auf VIAS
LEDS OSRAM LW P473

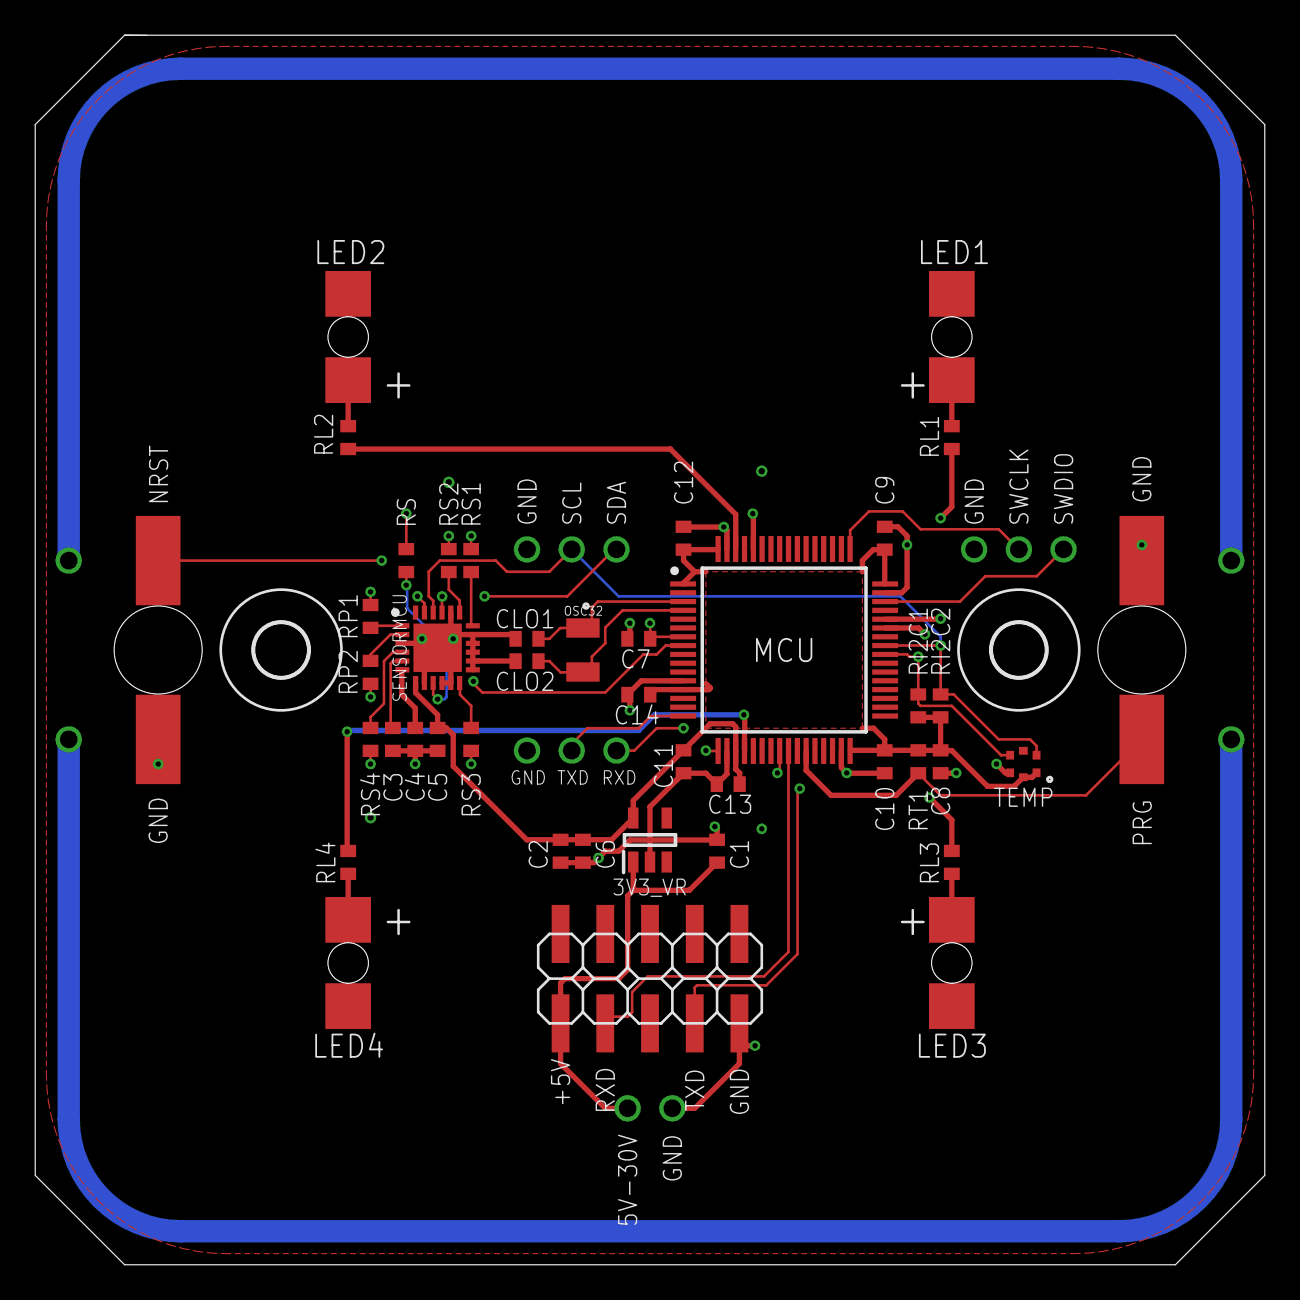
[picture p13: board 4ButtonSwitch.Rev2.2.brd from above]

Board: 4 copper layers, 69.8 x 69.8 mm, 46 parts (0 on the bottom side), 29 nets.

Other parts of the board:
U$1, U$2: 3,0
