ChriD/konnekting-TouchButtonSwitch/eagle/Frontboard2.brd

## EAGLE design eagle/_old/Frontboard2.brd (2018-05-24, an earlier design)

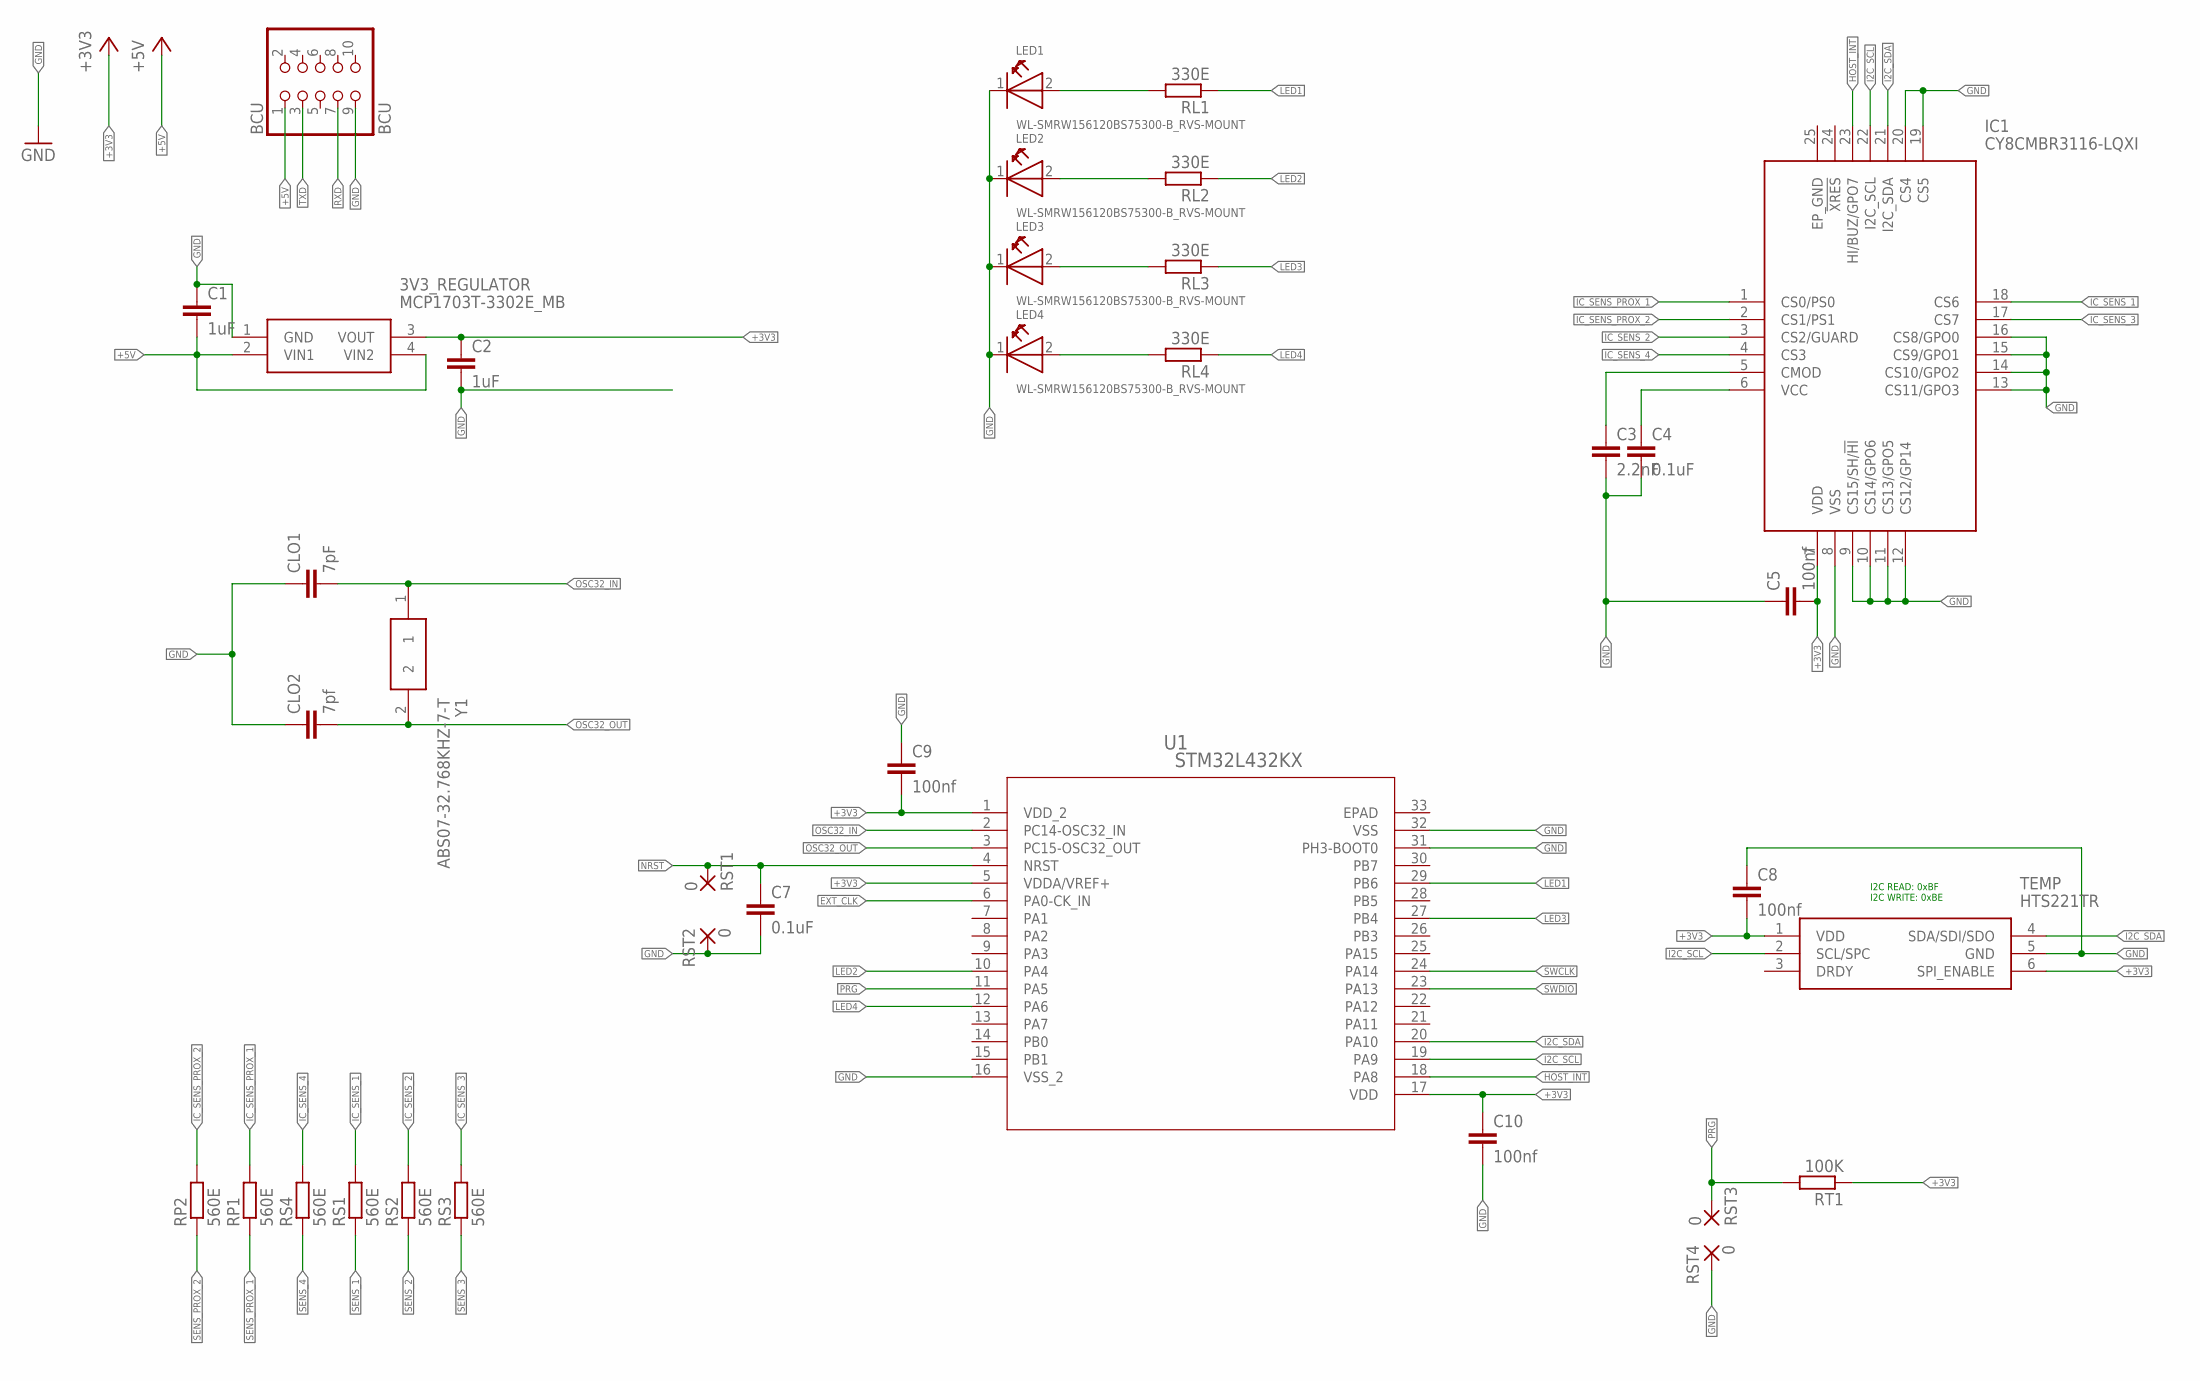
[picture p14: schematic Frontboard2.sch]

Parts:
3V3_REGULATOR: MCP1703T-3302E_MB; SOT-89(MB)
BCU: BCU; 2X05SMD
C1, C2: 1uF; C0603
C3: 2.2nF; C0603
C4, C7: 0.1uF; C0603
C5, C8, C9, C10: 100nf; C0603
CLO1: 7pF; C0603
CLO2: 7pf; C0603
IC1: CY8CMBR3116-LQXI; QFN50P400X400X60-25N
LED1, LED2, LED3, LED4: WL-SMRW156120BS75300-B_RVS-MOUNT; WL-SMRW-1206-CYLDR-REVERSE-MOUNT
RL1, RL2, RL3, RL4: 330E; R0603
RP1, RP2: 560E; R0603
RS1, RS2, RS3, RS4: 560E; R0603
RST1, RST2, RST3, RST4: 0; SMD2,54-5,08
RT1: 100K; R0603
TEMP: HTS221TR; HLGA-6L
U1: STM32L432KX; UFQFPN32-5X5MM
Y1: ABS07-32.768KHZ-7-T; ABS-07

Connections:
+3V3: 3V3_REGULATOR.3 (VOUT), C2.1, C5.2, C8.2, C9.2, C10.1, IC1.7 (VDD), RT1.1, TEMP.1 (VDD), TEMP.6 (SPI_ENABLE), U1.1 (VDD_2), U1.5 (VDDA/VREF+), U1.17 (VDD)
+5V: 3V3_REGULATOR.2 (VIN1), 3V3_REGULATOR.4 (VIN2), BCU.1, C1.2
CMOD: C3.1, IC1.5 (CMOD)
EP_GND: IC1.25 (EP_GND)
EXT_CLK: U1.6 (PA0-CK_IN)
GND: 3V3_REGULATOR.1 (GND), BCU.9, C1.1, C2.2, C3.2, C4.2, C5.1, C7.2, C8.1, C9.1, C10.2, CLO1.1, CLO2.1, IC1.8 (VSS), IC1.9 (CS15/SH/!HI), IC1.10 (CS14/GPO6), IC1.11 (CS13/GPO5), IC1.12 (CS12/GP14), IC1.13 (CS11/GPO3), IC1.14 (CS10/GPO2), IC1.15 (CS9/GPO1), IC1.16 (CS8/GPO0), IC1.19 (CS5), IC1.20 (CS4), LED1.1 (K), LED2.1 (K), LED3.1 (K), LED4.1 (K), RST2.1, RST4.1, TEMP.5 (GND), U1.16 (VSS_2), U1.31 (PH3-BOOT0), U1.32 (VSS)
HOST_INT: IC1.23 (HI/BUZ/GPO7), U1.18 (PA8)
I2C_SCL: IC1.22 (I2C_SCL), TEMP.2 (SCL/SPC), U1.19 (PA9)
I2C_SDA: IC1.21 (I2C_SDA), TEMP.4 (SDA/SDI/SDO), U1.20 (PA10)
IC_SENS_1: IC1.18 (CS6), RS1.2
IC_SENS_2: IC1.3 (CS2/GUARD), RS2.2
IC_SENS_3: IC1.17 (CS7), RS3.2
IC_SENS_4: IC1.4 (CS3), RS4.2
IC_SENS_PROX_1: IC1.1 (CS0/PS0), RP1.2
IC_SENS_PROX_2: IC1.2 (CS1/PS1), RP2.2
LED1: RL1.1, U1.29 (PB6)
LED2: RL2.1, U1.10 (PA4)
LED3: RL3.1, U1.27 (PB4)
LED4: RL4.1, U1.12 (PA6)
unnamed: LED1.2 (A), RL1.2
unnamed: LED2.2 (A), RL2.2
unnamed: LED3.2 (A), RL3.2
unnamed: LED4.2 (A), RL4.2
NRST: C7.1, RST1.1, U1.4 (NRST)
OSC32_IN: CLO1.2, U1.2 (PC14-OSC32_IN), Y1.1
OSC32_OUT: CLO2.2, U1.3 (PC15-OSC32_OUT), Y1.2
PRG: RST3.1, RT1.2, U1.11 (PA5)
RXD: BCU.7
SENS_1: RS1.1
SENS_2: RS2.1
SENS_3: RS3.1
SENS_4: RS4.1
SENS_PROX_1: RP1.1
SENS_PROX_2: RP2.1
SWCLK: U1.24 (PA14)
SWDIO: U1.23 (PA13)
TXD: BCU.3
VCC: C4.1, IC1.6 (VCC)

Notes on the sheet:
I2C READ: 0xBF I2C WRITE: 0xBE

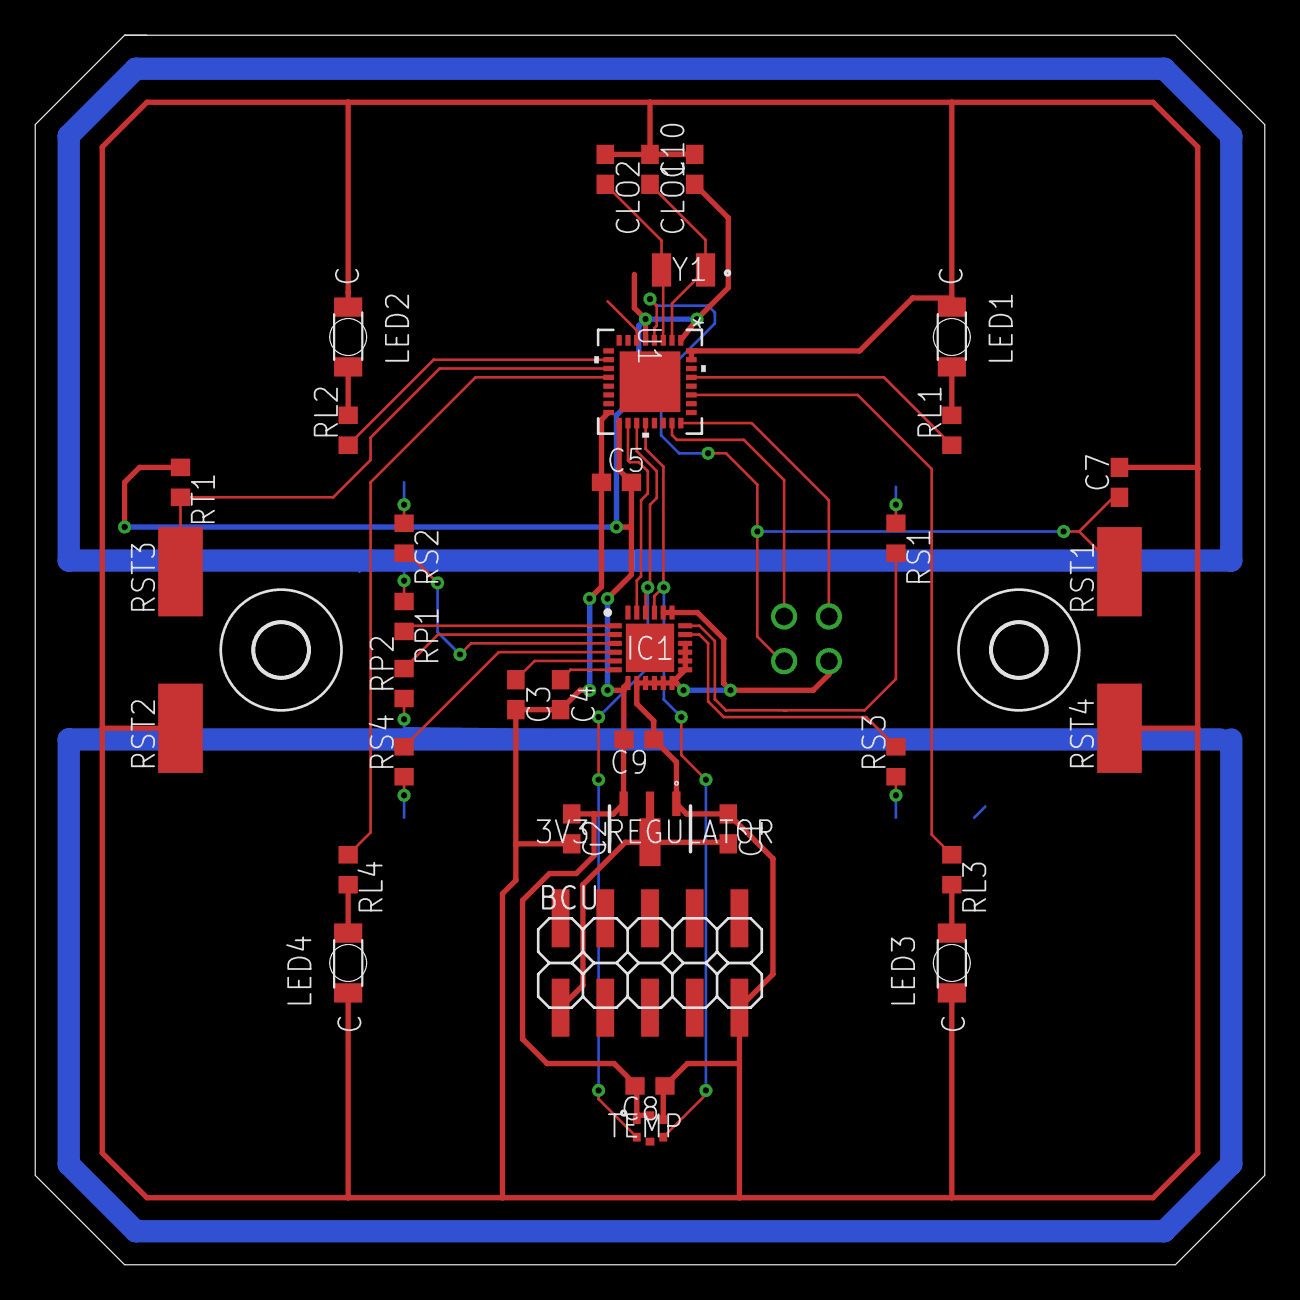
[picture p15: board Frontboard2.brd from above]

Board: 2 copper layers, 69.8 x 69.8 mm, 38 parts (0 on the bottom side), 26 nets.

Other parts of the board:
U$1, U$2: 3,0
