ChriD/konnekting-TouchButtonSwitch/eagle/20180513_Frontboard.brd

## EAGLE design eagle/_old/20180513_Frontboard.brd (2018-05-16, an earlier design)

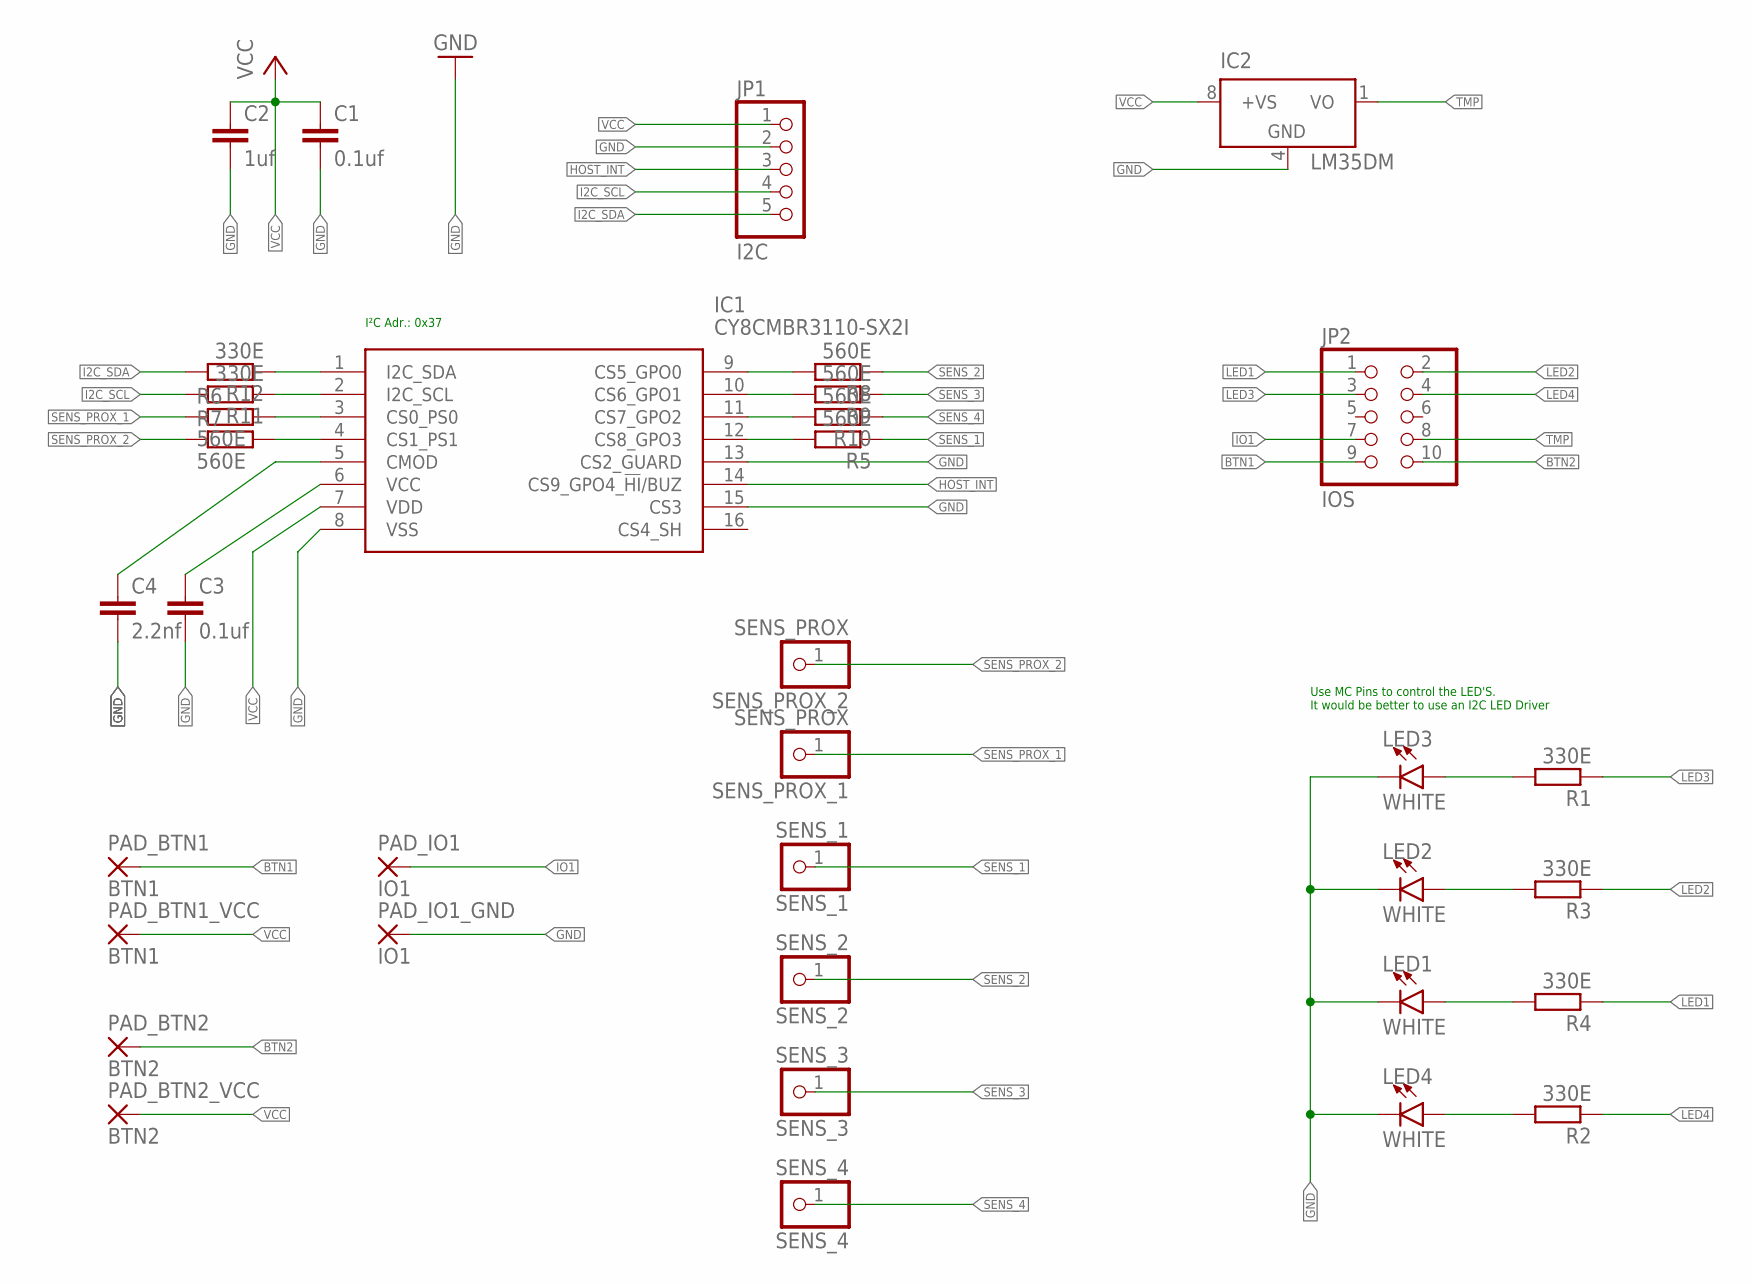
[picture p16: schematic 20180513_Frontboard.sch]

Parts:
C1, C3: 0.1uf; C0805
C2: 1uf; C0805
C4: 2.2nf; C0805
IC1: CY8CMBR3110-SX2I; SOIC127P600X173-16N
IC2: LM35DM; SO08
JP1: I2C; 1X05SMD
JP2: IOS; 2X05SMD
LED1, LED2, LED3, LED4: WHITE; LED-1206-BOTTOM
PAD_BTN1, PAD_BTN1_VCC: BTN1; 2,54/1,0
PAD_BTN2, PAD_BTN2_VCC: BTN2; 2,54/1,0
PAD_IO1, PAD_IO1_GND: IO1; 2,54/1,0
R1, R2, R3, R4, R11, R12: 330E; R0805
R5, R6, R7, R8, R9, R10: 560E; R0805
SENS_1: SENS_1; WPAD-1-0603
SENS_2: SENS_2; WPAD-1-0603
SENS_3: SENS_3; WPAD-1-0603
SENS_4: SENS_4; WPAD-1-0603
SENS_PROX_1, SENS_PROX_2: SENS_PROX; WPAD-1-0603

Connections:
BTN1: JP2.9, PAD_BTN1.1
BTN2: JP2.10, PAD_BTN2.1
GND: C1.2, C2.2, C3.2, C4.2, IC1.8 (VSS), IC1.13 (CS2_GUARD), IC1.15 (CS3), IC2.4 (GND), JP1.2, LED1.C, LED2.C, LED3.C, LED4.C, PAD_IO1_GND.1
HOST_INT: IC1.14 (CS9_GPO4_!HI!/BUZ), JP1.3
I2C_SCL: JP1.4, R11.2
I2C_SDA: JP1.5, R12.2
IO1: JP2.7, PAD_IO1.1
LED1: JP2.1, R4.1
LED2: JP2.2, R3.1
LED3: JP2.3, R1.1
LED4: JP2.4, R2.1
unnamed: IC1.9 (CS5_GPO0), R8.2
unnamed: IC1.10 (CS6_GPO1), R9.2
unnamed: IC1.11 (CS7_GPO2), R10.2
unnamed: IC1.1 (I2C_SDA), R12.1
unnamed: IC1.2 (I2C_SCL), R11.1
unnamed: IC1.3 (CS0_PS0), R6.2
unnamed: IC1.12 (CS8_GPO3), R5.2
unnamed: C3.1, IC1.6 (VCC)
unnamed: C4.1, IC1.5 (CMOD)
unnamed: IC1.4 (CS1_PS1), R7.2
unnamed: LED4.A, R2.2
unnamed: LED1.A, R4.2
unnamed: LED2.A, R3.2
unnamed: LED3.A, R1.2
SENS_1: R5.1, SENS_1.1
SENS_2: R8.1, SENS_2.1
SENS_3: R9.1, SENS_3.1
SENS_4: R10.1, SENS_4.1
SENS_PROX_1: R6.1, SENS_PROX_1.1
SENS_PROX_2: R7.1, SENS_PROX_2.1
TMP: IC2.1 (VO), JP2.8
VCC: C1.1, C2.1, IC1.7 (VDD), IC2.8 (+VS), JP1.1, PAD_BTN1_VCC.1, PAD_BTN2_VCC.1

Notes on the sheet:
I²C Adr.: 0x37
Use MC Pins to control the LED'S. It would be better to use an I2C LED Driver

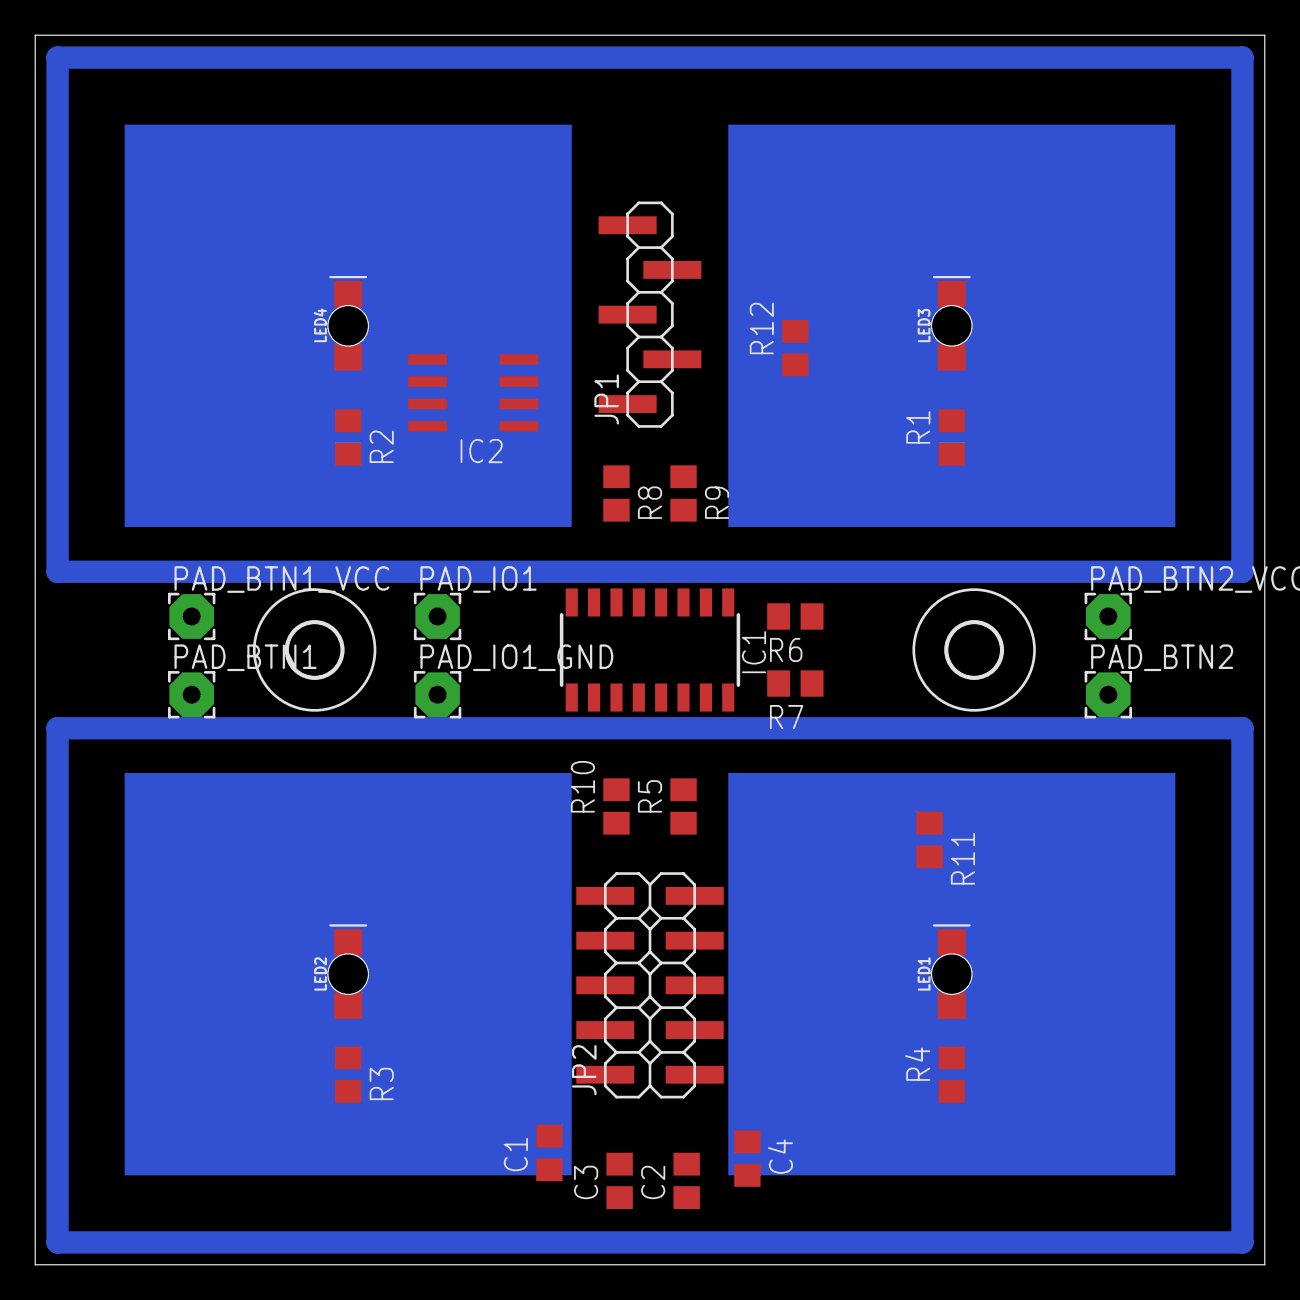
[picture p17: board 20180513_Frontboard.brd from above]

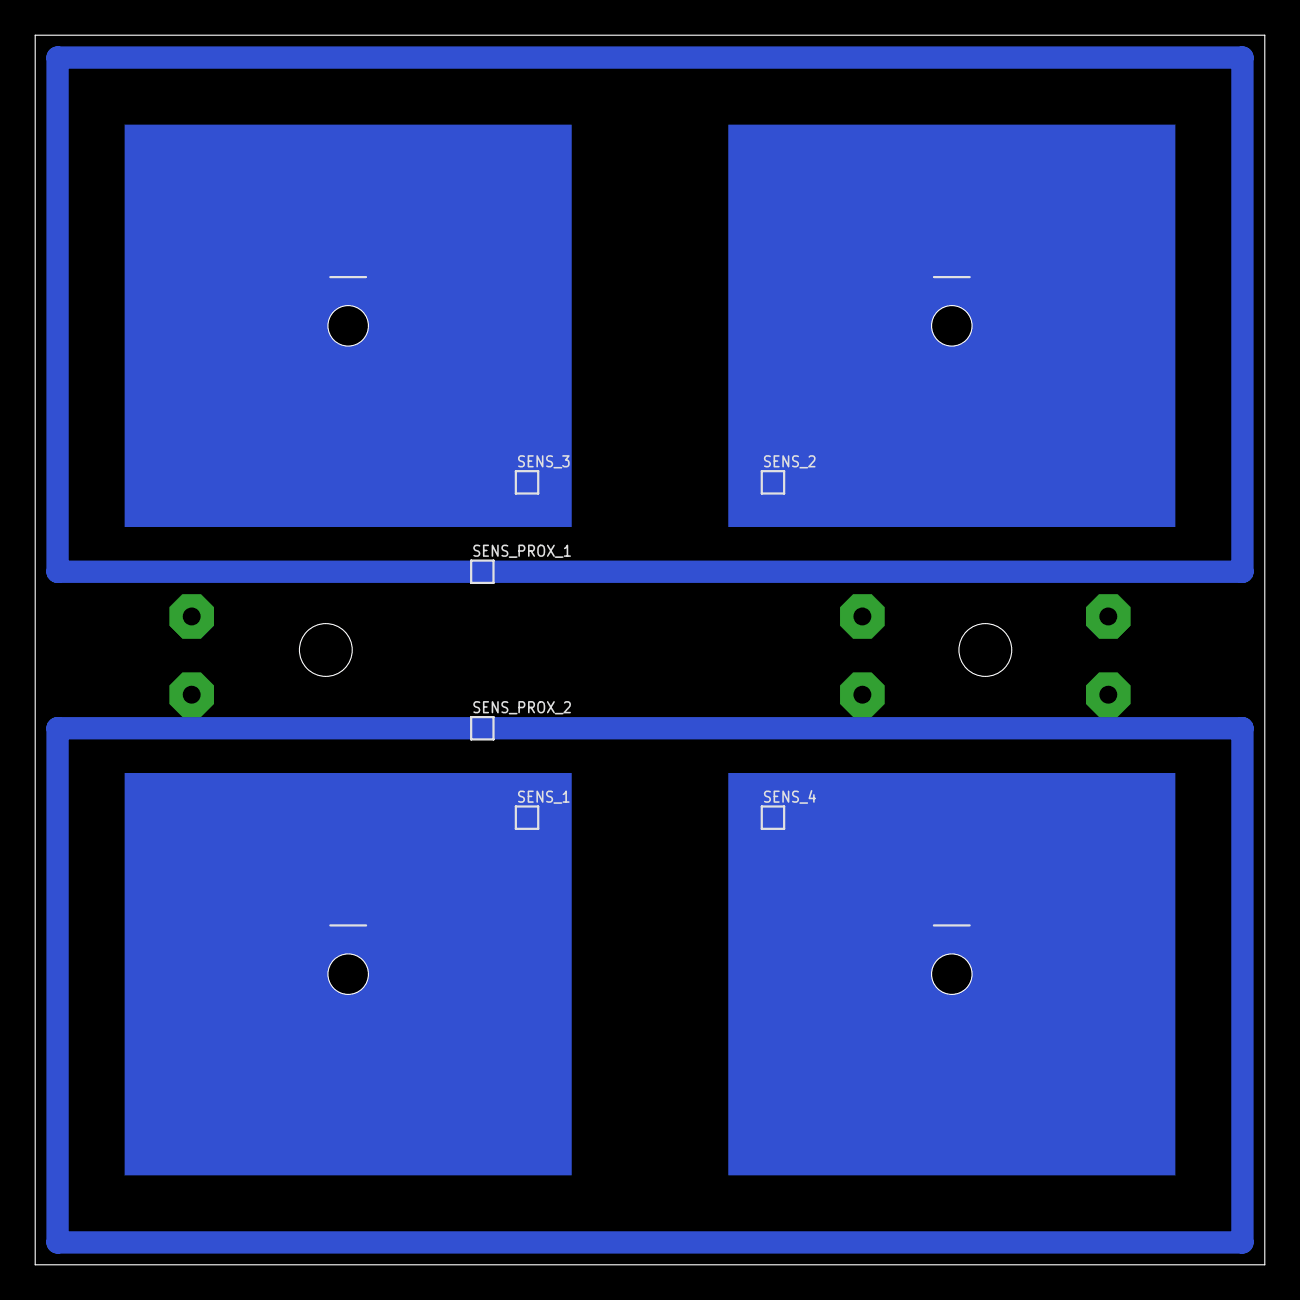
[picture p18: board 20180513_Frontboard.brd from below]

Board: 2 copper layers, 69.8 x 69.8 mm, 38 parts (6 on the bottom side), 33 nets.

Other parts of the board:
U$1, U$2: 3,0
