ChriD/konnekting-TouchButtonSwitch/eagle/Frontboard_TIC.brd

## EAGLE design eagle/_old/Frontboard_TIC.brd (2018-05-19, an earlier design)

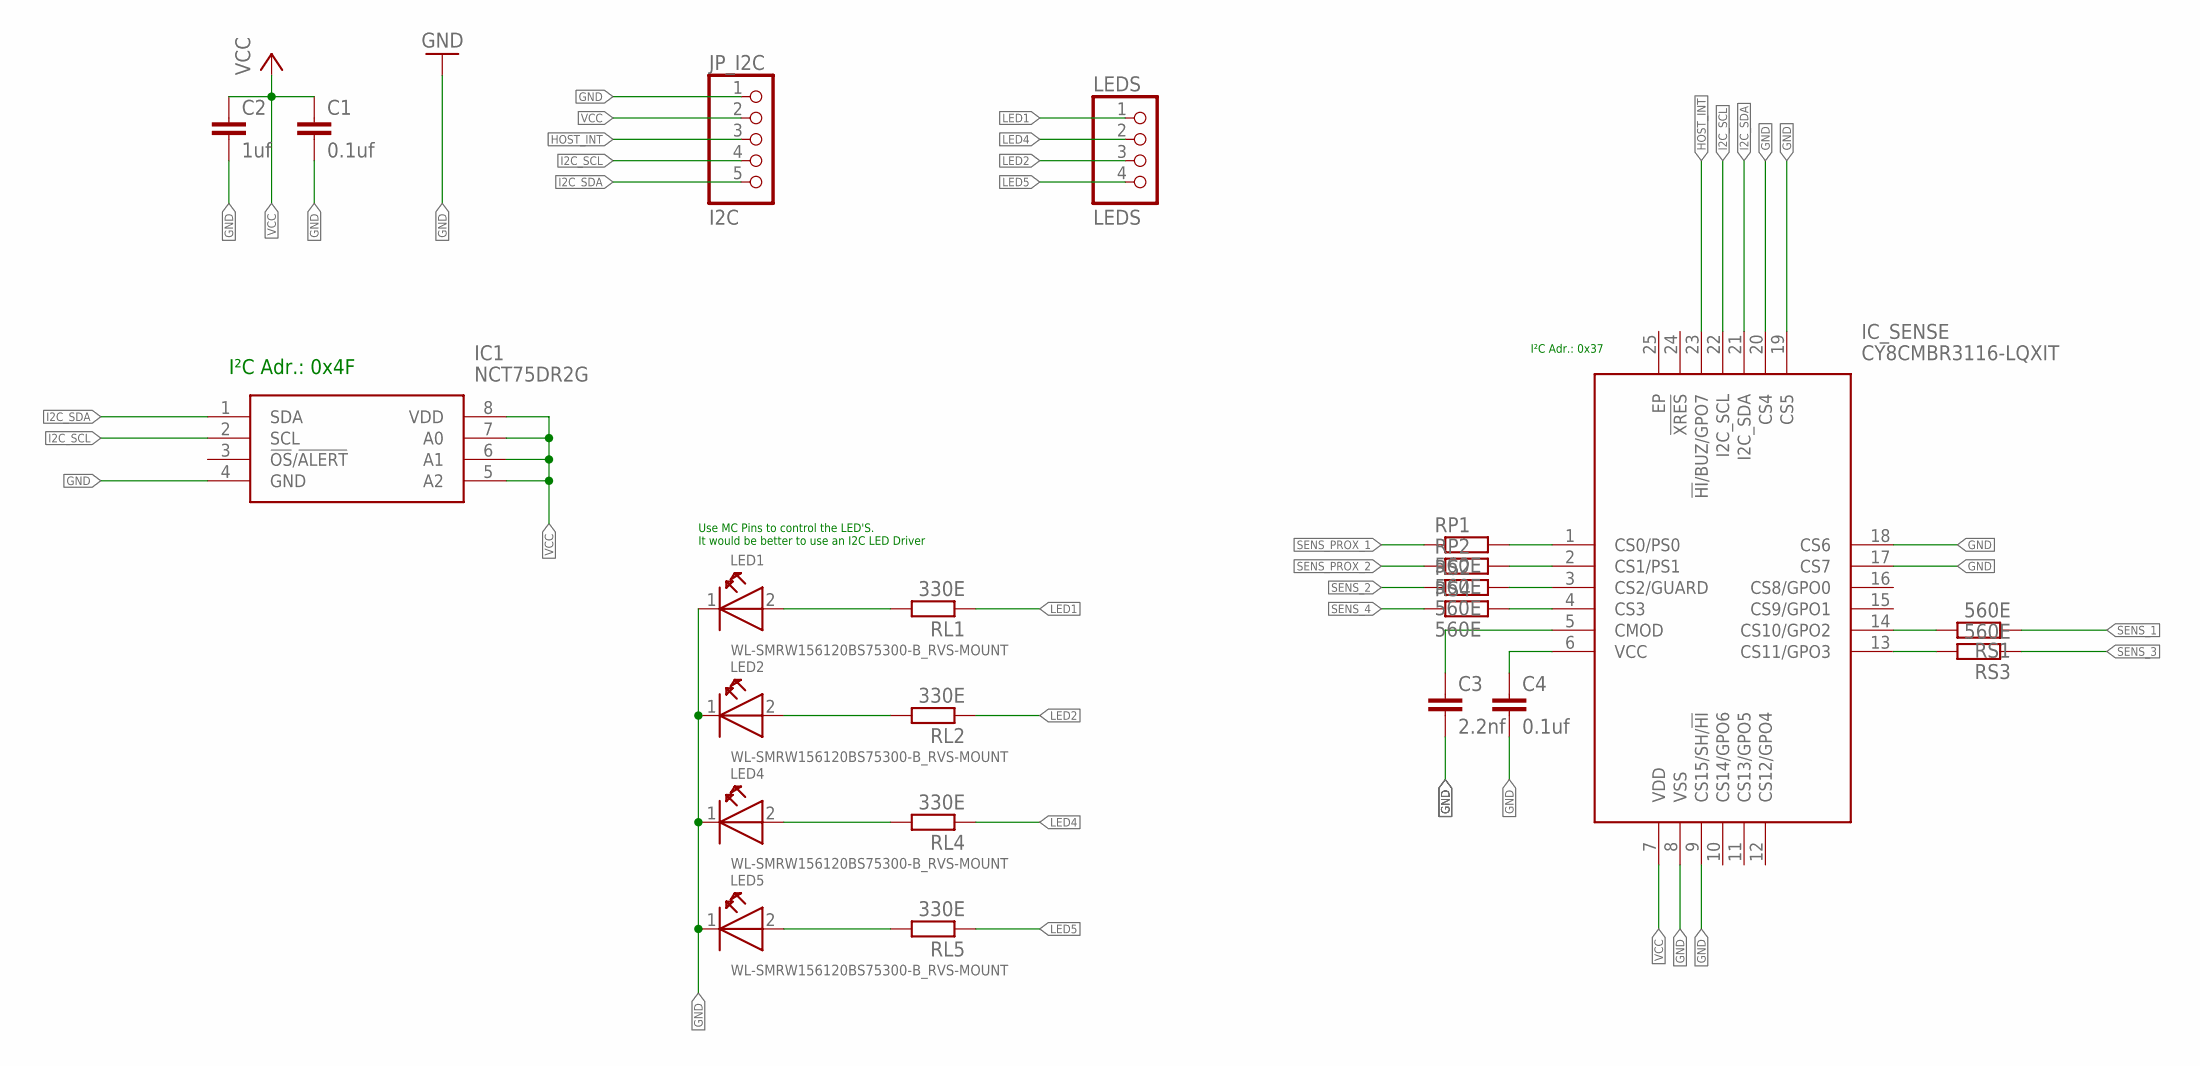
[picture p19: schematic Frontboard_TIC.sch]

Parts:
C1, C4: 0.1uf; C0805
C2: 1uf; C0805
C3: 2.2nf; C0805
IC1: NCT75DR2G; SOIC127P600X175-8N
IC_SENSE: CY8CMBR3116-LQXIT; QFN50P400X400X60-25N
JP_I2C: I2C; 1X05SMD
LED1, LED2, LED4, LED5: WL-SMRW156120BS75300-B_RVS-MOUNT; WL-SMRW-1206-CYLDR-REVERSE-MOUNT
LEDS: LEDS; 1X04SMD
RL1, RL2, RL4, RL5: 330E; R0805
RP1, RP2: 560E; R0805
RS1, RS2, RS3, RS4: 560E; R0805

Connections:
GND: C1.2, C2.2, C3.2, C4.2, IC1.4 (GND), IC_SENSE.8 (VSS), IC_SENSE.9 (CS15/SH/!HI), IC_SENSE.17 (CS7), IC_SENSE.18 (CS6), IC_SENSE.19 (CS5), IC_SENSE.20 (CS4), JP_I2C.1, LED1.1 (K), LED2.1 (K), LED4.1 (K), LED5.1 (K)
HOST_INT: IC_SENSE.23 (!HI!/BUZ/GPO7), JP_I2C.3
I2C_SCL: IC1.2 (SCL), IC_SENSE.22 (I2C_SCL), JP_I2C.4
I2C_SDA: IC1.1 (SDA), IC_SENSE.21 (I2C_SDA), JP_I2C.5
LED1: LEDS.1, RL1.1
LED2: LEDS.3, RL2.1
LED4: LEDS.2, RL4.1
LED5: LEDS.4, RL5.1
unnamed: LED1.2 (A), RL1.2
unnamed: LED2.2 (A), RL2.2
unnamed: IC_SENSE.14 (CS10/GPO2), RS1.2
unnamed: IC_SENSE.13 (CS11/GPO3), RS3.2
unnamed: IC_SENSE.1 (CS0/PS0), RP1.2
unnamed: IC_SENSE.2 (CS1/PS1), RP2.2
unnamed: IC_SENSE.4 (CS3), RS4.2
unnamed: IC_SENSE.3 (CS2/GUARD), RS2.2
unnamed: LED4.2 (A), RL4.2
unnamed: LED5.2 (A), RL5.2
unnamed: C4.1, IC_SENSE.6 (VCC)
unnamed: C3.1, IC_SENSE.5 (CMOD)
SENS_1: RS1.1
SENS_2: RS2.1
SENS_3: RS3.1
SENS_4: RS4.1
SENS_PROX_1: RP1.1
SENS_PROX_2: RP2.1
VCC: C1.1, C2.1, IC1.5 (A2), IC1.6 (A1), IC1.7 (A0), IC1.8 (VDD), IC_SENSE.7 (VDD), JP_I2C.2

Notes on the sheet:
Use MC Pins to control the LED'S. It would be better to use an I2C LED Driver
I²C Adr.: 0x37
I²C Adr.: 0x4F

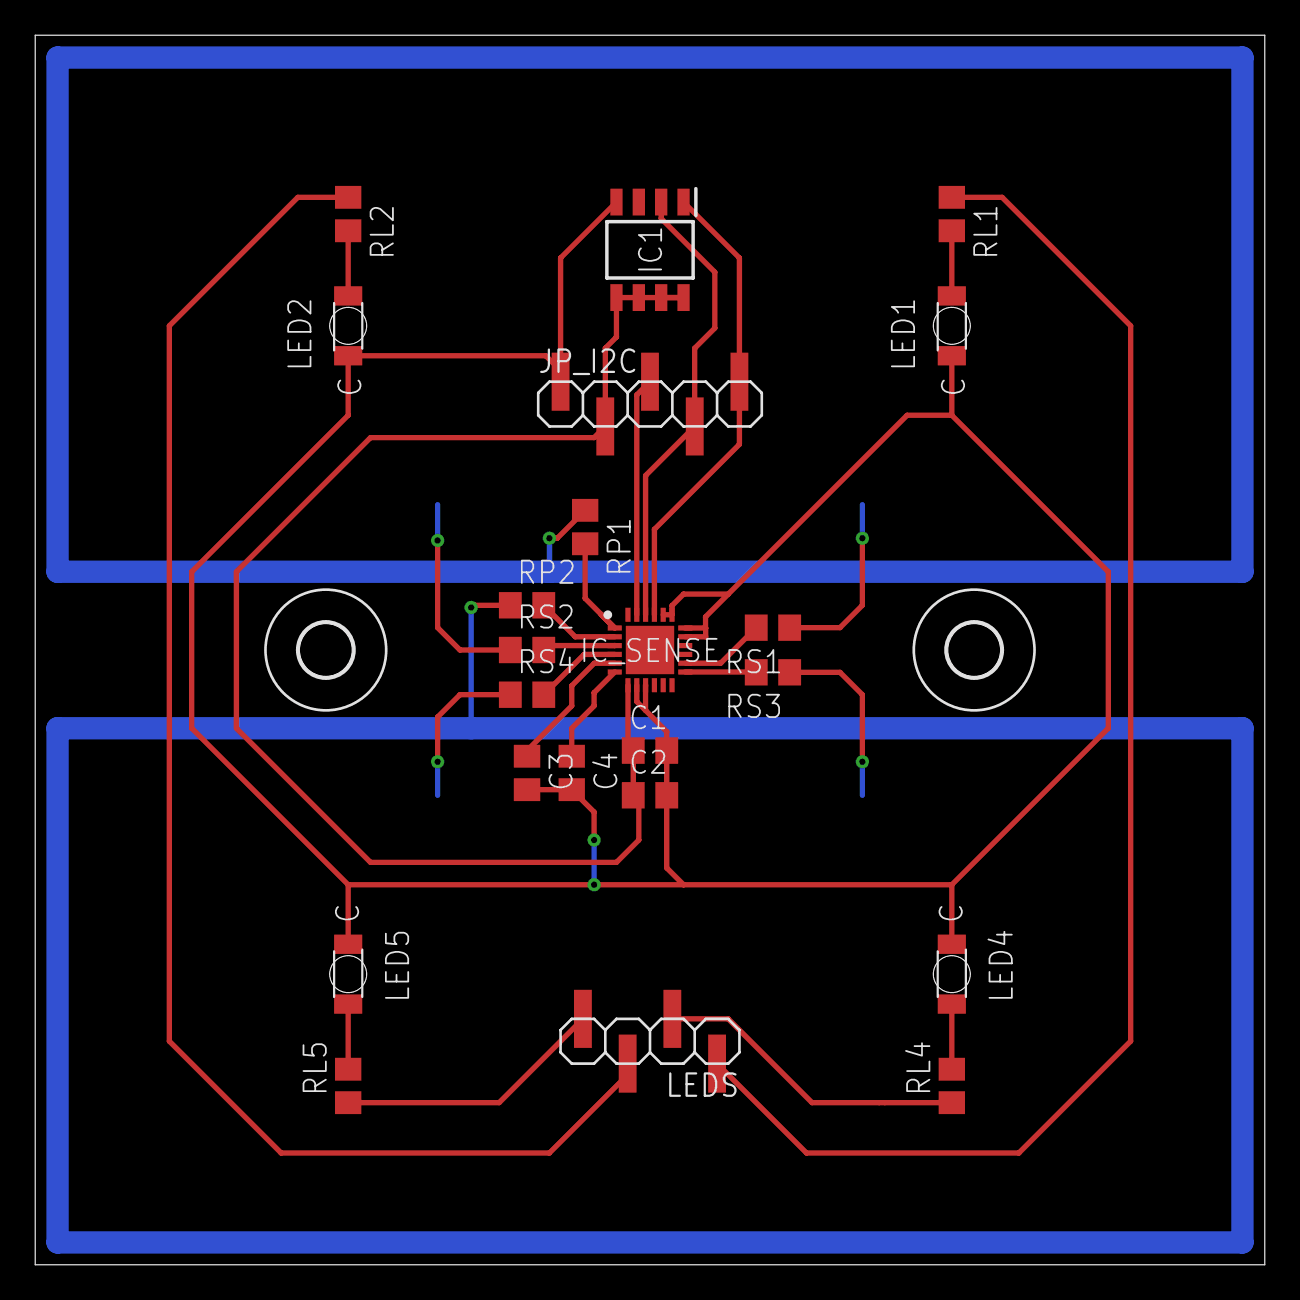
[picture p20: board Frontboard_TIC.brd from above]

Board: 2 copper layers, 69.8 x 69.8 mm, 24 parts (0 on the bottom side), 21 nets.

Other parts of the board:
U$1, U$2: 3,0
