ChriD/konnekting-TouchButtonSwitch/eagle/Frontboard_Rev1.brd

## EAGLE design eagle/_old/Frontboard_Rev1.brd (2018-05-23, an earlier design)

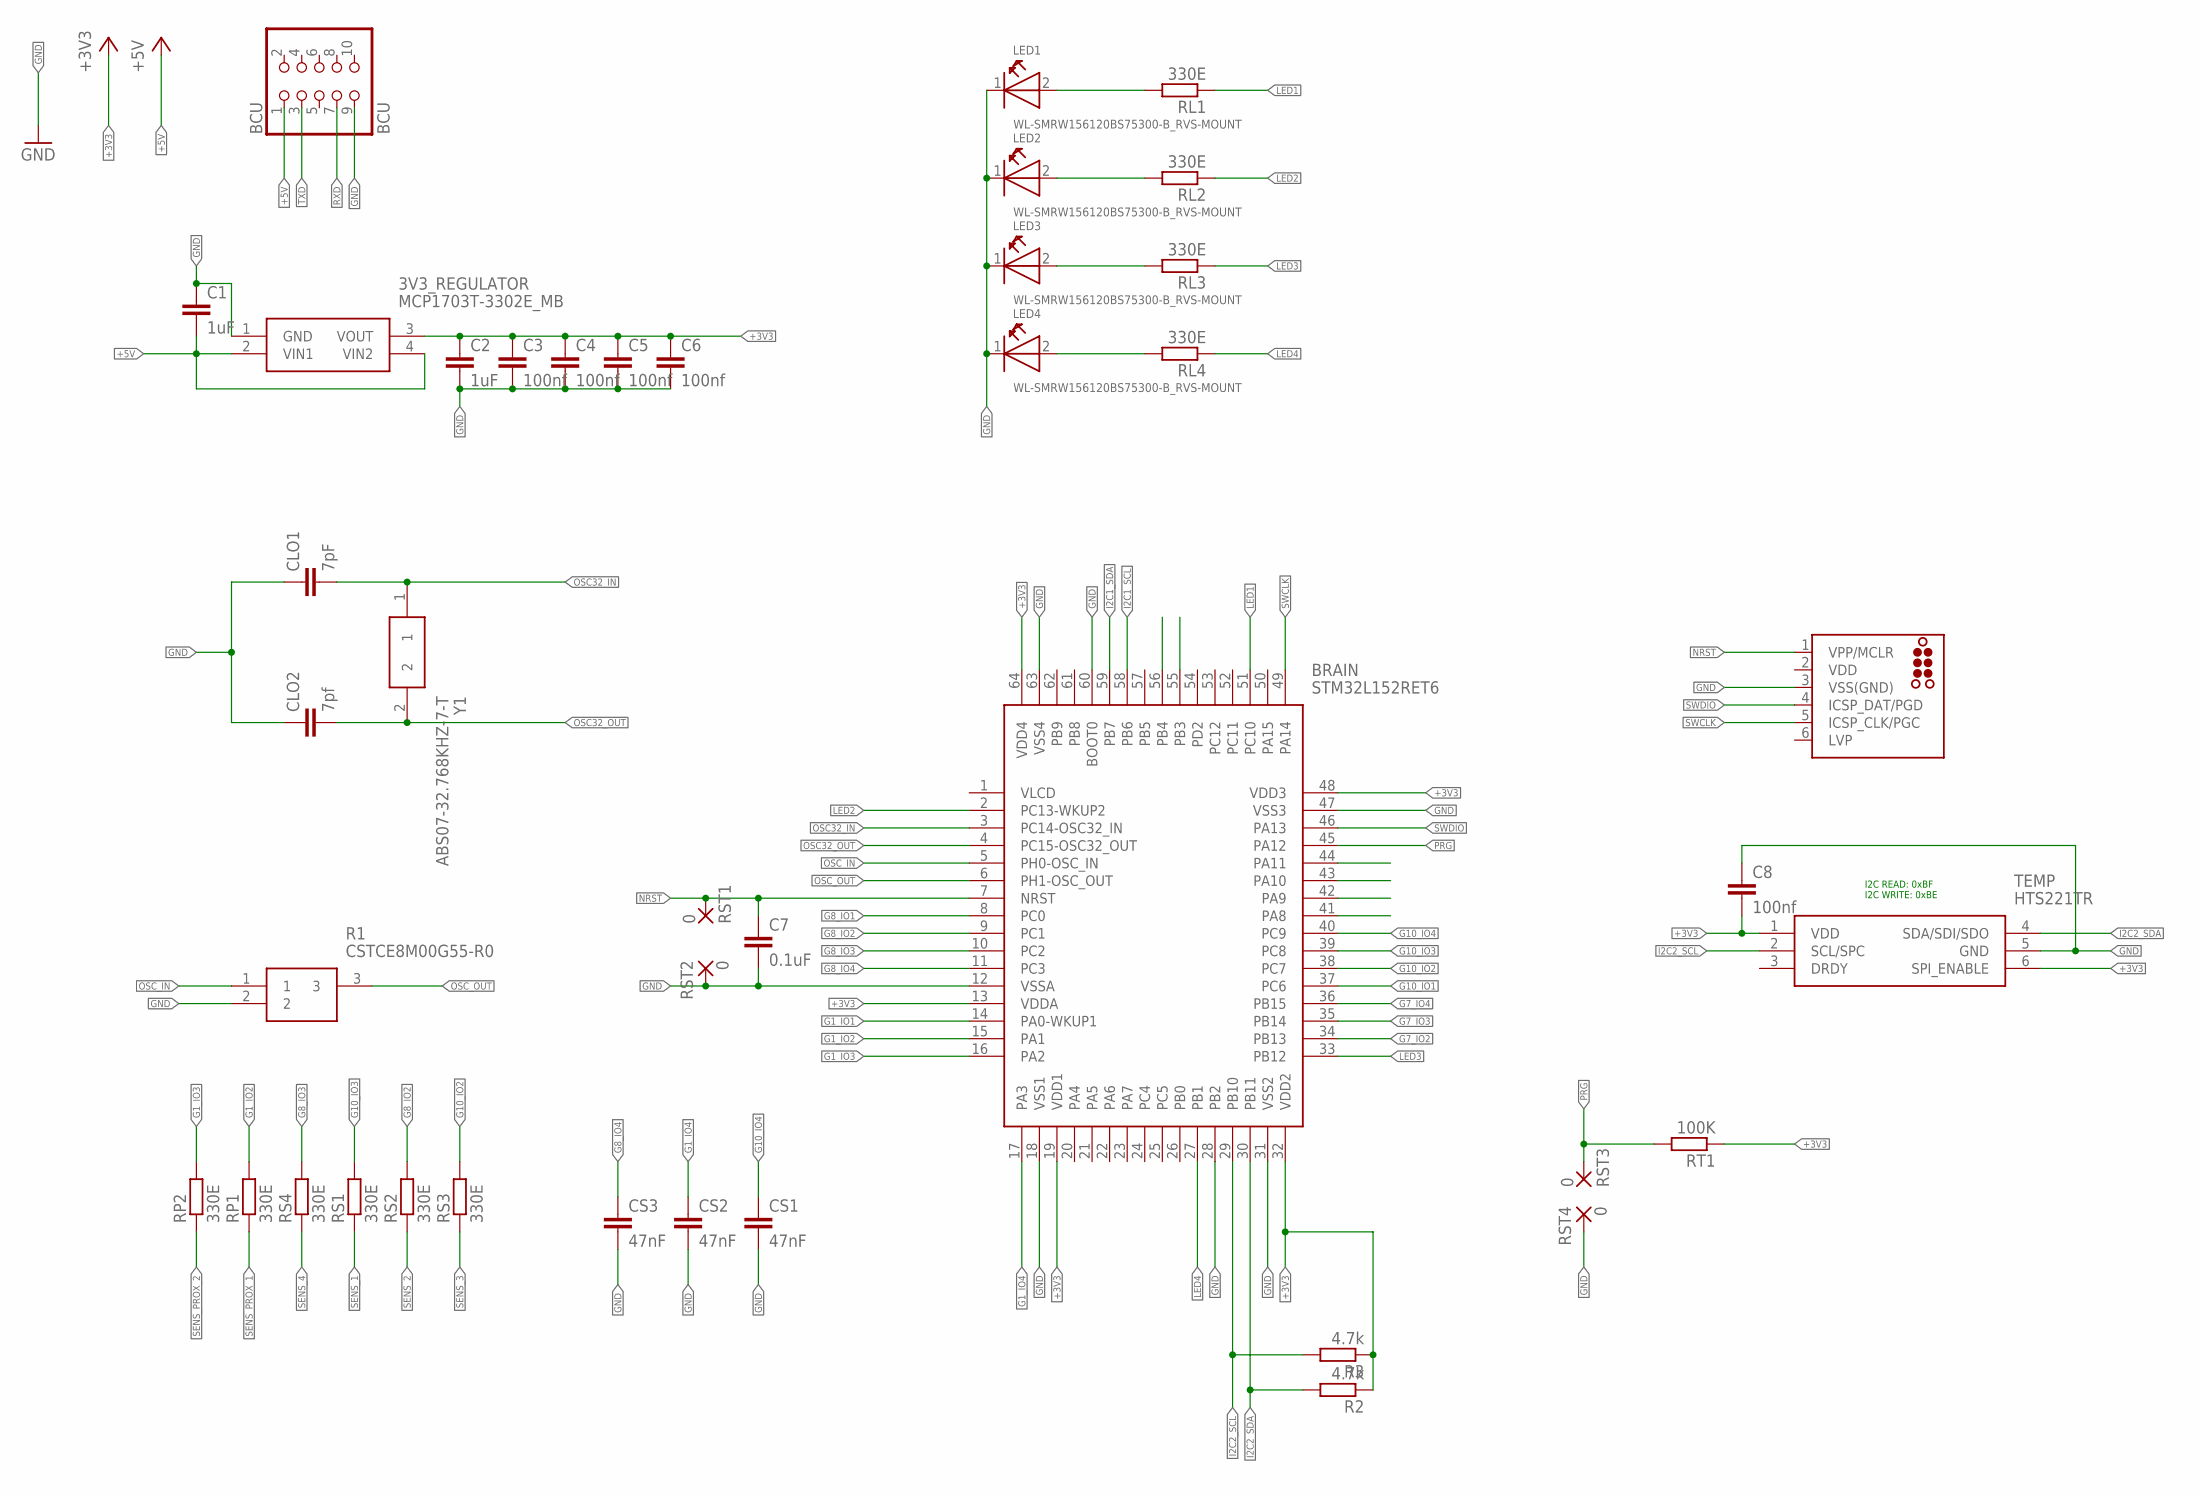
[picture p21: schematic Frontboard_Rev1.sch]

Parts:
3V3_REGULATOR: MCP1703T-3302E_MB; SOT-89(MB)
BCU: BCU; 2X05SMD
BRAIN: STM32L152RET6; QFP50P1200X1200X160-64N
C1, C2: 1uF; C0603
C3, C4, C5, C6, C8: 100nf; C0603
C7: 0.1uF; C0603
CLO1: 7pF; C0603
CLO2: 7pf; C0603
CS1, CS2, CS3: 47nF; C0603
LED1, LED2, LED3, LED4: WL-SMRW156120BS75300-B_RVS-MOUNT; WL-SMRW-1206-CYLDR-REVERSE-MOUNT
R1: CSTCE8M00G55-R0; CSTCE12M0G55-R0
R2, R3: 4.7k; R0603
RL1, RL2, RL3, RL4: 330E; R0603
RP1, RP2: 330E; R0603
RS1, RS2, RS3, RS4: 330E; R0603
RST1, RST2, RST3, RST4: 0; SMD2,54-5,08
RT1: 100K; R0603
SWD: SWD; TC2030-MCP-NL
TEMP: HTS221TR; HLGA-6L
Y1: ABS07-32.768KHZ-7-T; ABS-07

Connections:
+3V3: 3V3_REGULATOR.3 (VOUT), BRAIN.13 (VDDA), BRAIN.19 (VDD1), BRAIN.32 (VDD2), BRAIN.48 (VDD3), BRAIN.64 (VDD4), C2.1, C3.1, C4.1, C5.1, C6.1, C8.2, R2.1, R3.1, RT1.1, TEMP.1 (VDD), TEMP.6 (SPI_ENABLE)
+5V: 3V3_REGULATOR.2 (VIN1), 3V3_REGULATOR.4 (VIN2), BCU.1, C1.2
G1_IO1: BRAIN.14 (PA0-WKUP1)
G1_IO2: BRAIN.15 (PA1), RP1.2
G1_IO3: BRAIN.16 (PA2), RP2.2
G1_IO4: BRAIN.17 (PA3), CS2.1
G7_IO2: BRAIN.34 (PB13)
G7_IO3: BRAIN.35 (PB14)
G7_IO4: BRAIN.36 (PB15)
G8_IO1: BRAIN.8 (PC0)
G8_IO2: BRAIN.9 (PC1), RS2.2
G8_IO3: BRAIN.10 (PC2), RS4.2
G8_IO4: BRAIN.11 (PC3), CS3.1
G10_IO1: BRAIN.37 (PC6)
G10_IO2: BRAIN.38 (PC7), RS3.2
G10_IO3: BRAIN.39 (PC8), RS1.2
G10_IO4: BRAIN.40 (PC9), CS1.1
GND: 3V3_REGULATOR.1 (GND), BCU.9, BRAIN.12 (VSSA), BRAIN.18 (VSS1), BRAIN.28 (PB2), BRAIN.31 (VSS2), BRAIN.47 (VSS3), BRAIN.60 (BOOT0), BRAIN.63 (VSS4), C1.1, C2.2, C3.2, C4.2, C5.2, C6.2, C7.2, C8.1, CLO1.1, CLO2.1, CS1.2, CS2.2, CS3.2, LED1.1 (K), LED2.1 (K), LED3.1 (K), LED4.1 (K), R1.2, RST2.1, RST4.1, SWD.3 (VSS(GND)), TEMP.5 (GND)
I2C1_SCL: BRAIN.58 (PB6)
I2C1_SDA: BRAIN.59 (PB7)
I2C2_SCL: BRAIN.29 (PB10), R3.2, TEMP.2 (SCL/SPC)
I2C2_SDA: BRAIN.30 (PB11), R2.2, TEMP.4 (SDA/SDI/SDO)
LED1: BRAIN.51 (PC10), RL1.1
LED2: BRAIN.2 (PC13-WKUP2), RL2.1
LED3: BRAIN.33 (PB12), RL3.1
LED4: BRAIN.27 (PB1), RL4.1
unnamed: LED1.2 (A), RL1.2
unnamed: LED2.2 (A), RL2.2
unnamed: LED3.2 (A), RL3.2
unnamed: LED4.2 (A), RL4.2
NRST: BRAIN.7 (NRST), C7.1, RST1.1, SWD.1 (VPP/MCLR)
OSC32_IN: BRAIN.3 (PC14-OSC32_IN), CLO1.2, Y1.1
OSC32_OUT: BRAIN.4 (PC15-OSC32_OUT), CLO2.2, Y1.2
OSC_IN: BRAIN.5 (PH0-OSC_IN), R1.1
OSC_OUT: BRAIN.6 (PH1-OSC_OUT), R1.3
PRG: BRAIN.45 (PA12), RST3.1, RT1.2
RXD: BCU.7
SENS_1: RS1.1
SENS_2: RS2.1
SENS_3: RS3.1
SENS_4: RS4.1
SENS_PROX_1: RP1.1
SENS_PROX_2: RP2.1
SWCLK: BRAIN.49 (PA14), SWD.5 (ICSP_CLK/PGC)
SWDIO: BRAIN.46 (PA13), SWD.4 (ICSP_DAT/PGD)
TXD: BCU.3
VDD: SWD.2 (VDD)
VLCD: BRAIN.1 (VLCD)

Notes on the sheet:
I2C READ: 0xBF I2C WRITE: 0xBE
