ChriD/konnekting-TouchButtonSwitch/eagle/Frontboard_Rev1.brd

## EAGLE design eagle/_old/Frontboard_Rev1.brd (continued)

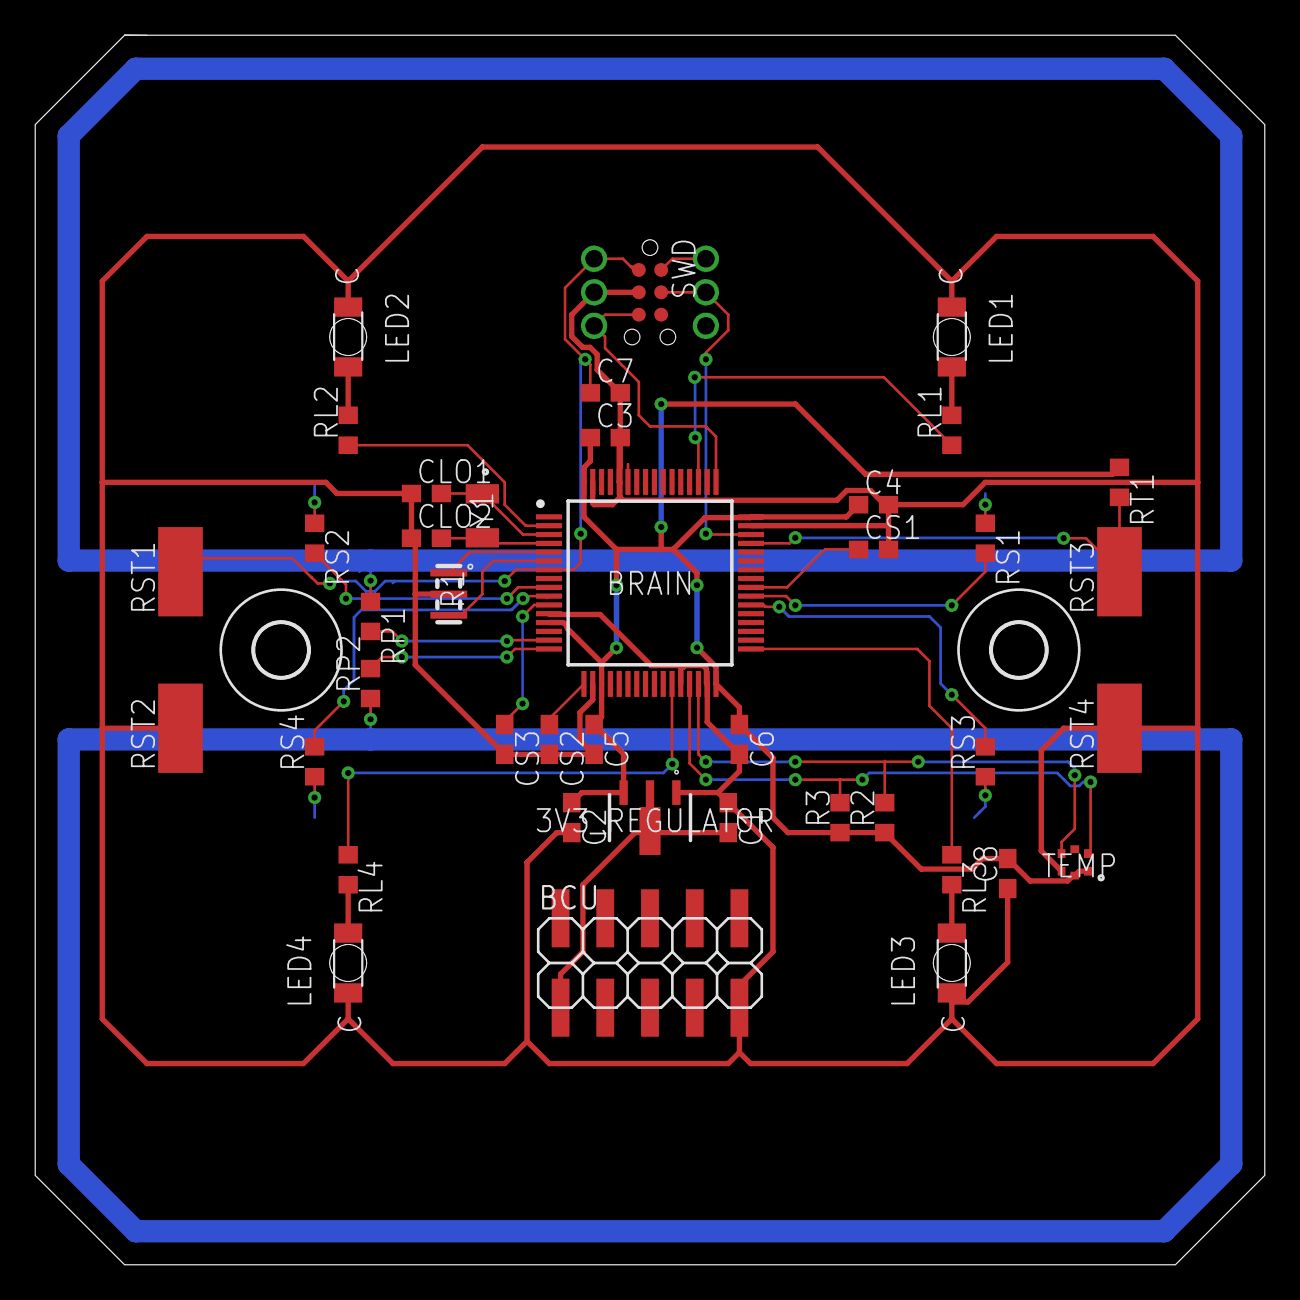
[picture p22: board Frontboard_Rev1.brd from above]

Board: 2 copper layers, 69.8 x 69.8 mm, 43 parts (0 on the bottom side), 30 nets.

Other parts of the board:
U$1, U$2: 3,0
