ChriD/konnekting-TouchButtonSwitch/eagle/4ButtonSwitch.Rev1.brd

## EAGLE design eagle/4ButtonSwitch.Rev1.brd (2018-06-06, an earlier design)

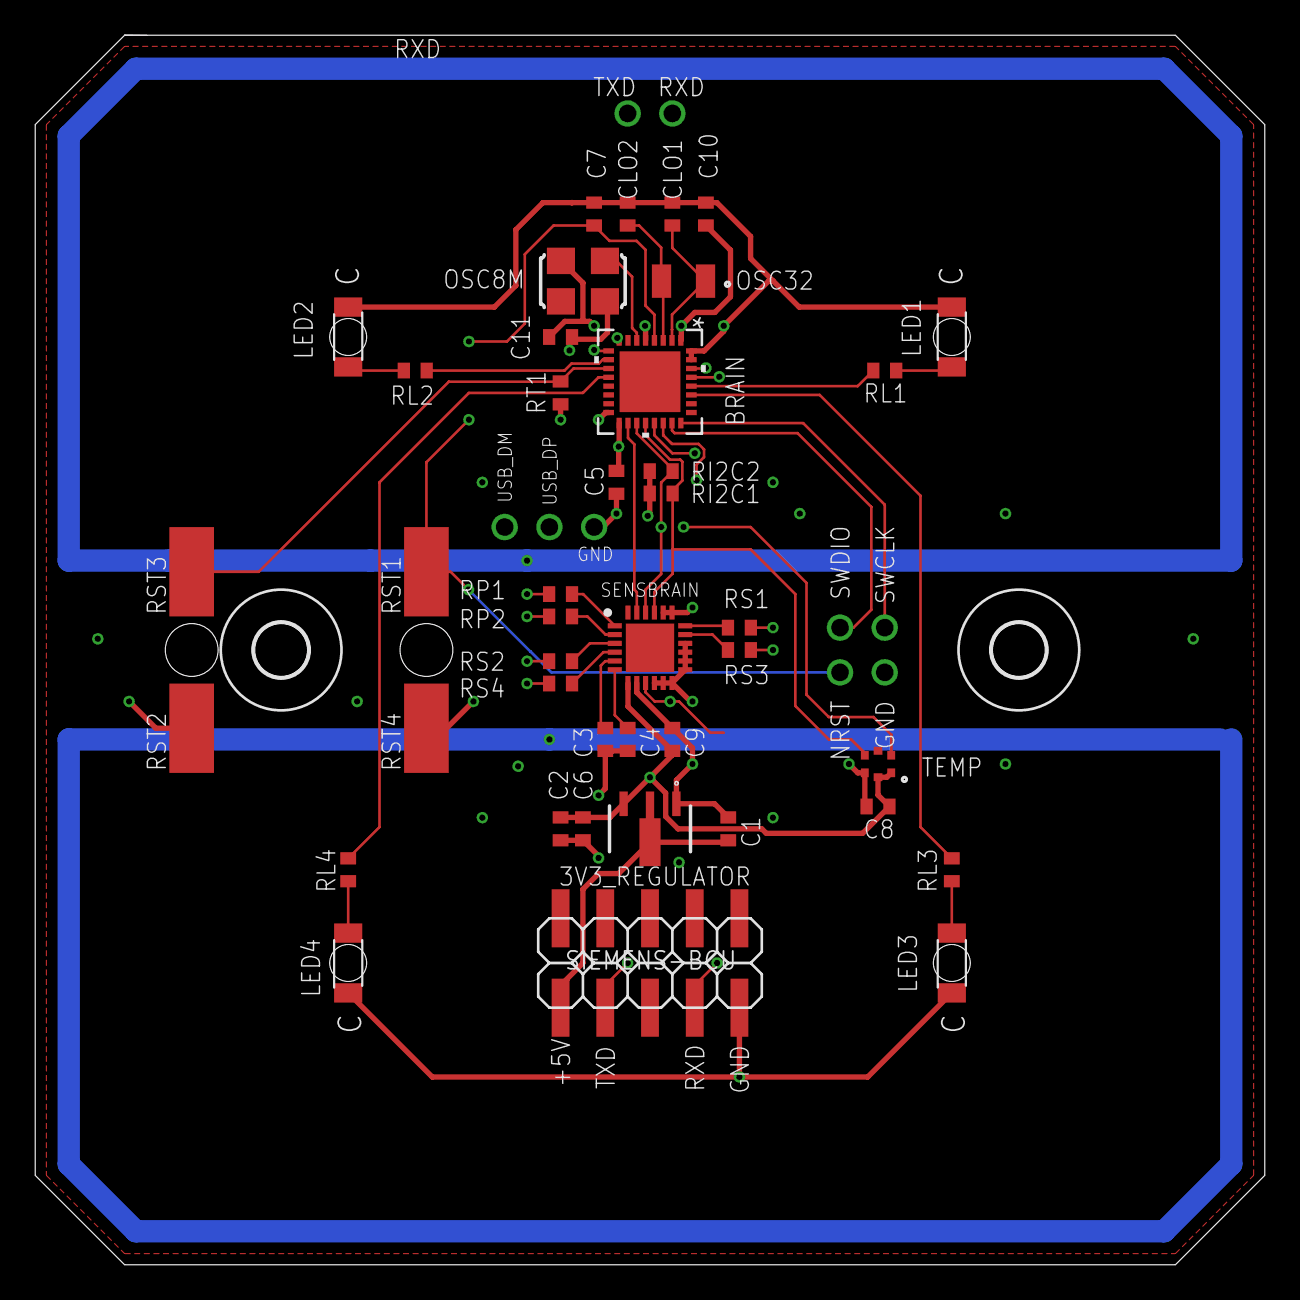
[picture p23: board 4ButtonSwitch.Rev1.brd from above]

Board: 4 copper layers, 69.8 x 69.8 mm, 43 parts (0 on the bottom side), 29 nets.

Parts:
3V3_REGULATOR: MCP1703T-3302E_MB; SOT-89(MB)
BRAIN: STM32L432KX; UFQFPN32-5X5MM
C1, C2: 1uF; C0402
C3: 2.2nF; C0402
C4, C7: 0.1uF; C0402
C5, C6, C8, C9, C10: 100nf; C0402
C11: 0.01uF; C0402
CLO1: 7pF; C0402
CLO2: 7pf; C0402
LED1, LED2, LED3, LED4: WL-SMRW156120BS75300-B_RVS-MOUNT; WL-SMRW-1206-CYLDR-REVERSE-MOUNT
OSC8M: ASF1; ASF
OSC32: ABS07-32.768KHZ-7-T; ABS-07
RI2C1, RI2C2: 4k7; R0402
RL1, RL2, RL3, RL4: 330E; R0402
RP1, RP2: 560E; R0402
RS1, RS2, RS3, RS4: 560E; R0402
RST1, RST2, RST3, RST4: 0; SMD2,54-5,08
RT1: 100K; R0402
SENSBRAIN: CY8CMBR3116-LQXI; QFN50P400X400X60-25N
SIEMENS-BCU: SIEMENS BCU; 2X05SMD
TEMP: HTS221TR; HLGA-6L
U$1, U$2: 3,0

Connections:
+3V3: 3V3_REGULATOR.3, BRAIN.1, BRAIN.5, BRAIN.17, C2.1, C5.2, C6.1, C8.2, C9.2, C10.1, C11.1, OSC8M.4, RI2C1.2, RI2C2.2, RT1.1, SENSBRAIN.7, TEMP.1, TEMP.6
+5V: 3V3_REGULATOR.2, 3V3_REGULATOR.4, C1.2, SIEMENS-BCU.1
CMOD: C3.1, SENSBRAIN.5
EXT_CLK: BRAIN.6, OSC8M.3
GND: 3V3_REGULATOR.1, BRAIN.16, BRAIN.31, BRAIN.32, C1.1, C2.2, C3.2, C4.2, C5.1, C6.2, C7.2, C8.1, C9.1, C10.2, C11.2, CLO1.1, CLO2.1, LED1.1, LED2.1, LED3.1, LED4.1, OSC8M.2, RST2.1, RST4.1, SENSBRAIN.8, SENSBRAIN.10, SENSBRAIN.11, SENSBRAIN.12, SENSBRAIN.13, SENSBRAIN.14, SENSBRAIN.15, SENSBRAIN.16, SENSBRAIN.19, SENSBRAIN.20, SIEMENS-BCU.9, TEMP.5
HOST_INT: BRAIN.18, SENSBRAIN.23
I2C_SCL: BRAIN.19, RI2C2.1, SENSBRAIN.22, TEMP.2
I2C_SDA: BRAIN.20, RI2C1.1, SENSBRAIN.21, TEMP.4
IC_SENS_1: RS1.2, SENSBRAIN.18
IC_SENS_2: RS2.2, SENSBRAIN.3
IC_SENS_3: RS3.2, SENSBRAIN.17
IC_SENS_4: RS4.2, SENSBRAIN.4
IC_SENS_PROX_1: RP1.2, SENSBRAIN.1
IC_SENS_PROX_2: RP2.2, SENSBRAIN.2
LED1: BRAIN.28, RL1.1
LED2: BRAIN.10, RL2.1
LED3: BRAIN.27, RL3.1
LED4: BRAIN.12, RL4.1
unnamed: LED1.2, RL1.2
unnamed: LED2.2, RL2.2
unnamed: LED3.2, RL3.2
unnamed: LED4.2, RL4.2
NRST: BRAIN.4, C7.1, RST1.1
OSC32_IN: BRAIN.2, CLO1.2, OSC32.1
OSC32_OUT: BRAIN.3, CLO2.2, OSC32.2
PRG: BRAIN.11, RST3.1, RT1.2
USART1_RX: BRAIN.30, SIEMENS-BCU.3
USART1_TX: BRAIN.29, SIEMENS-BCU.7
VCC: C4.1, SENSBRAIN.6
