ChriD/konnekting-TouchButtonSwitch/hardware/variants/KONNEKTING_TOUCHSWITCH_F303RE/PeripheralPins.c

/*
 *******************************************************************************
 * Copyright (c) 2016, STMicroelectronics
 * All rights reserved.
 *
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
 * THIS SOFTWARE IS PROVIDED BY THE COPYRIGHT HOLDERS AND CONTRIBUTORS "AS IS"
 * AND ANY EXPRESS OR IMPLIED WARRANTIES, INCLUDING, BUT NOT LIMITED TO, THE
 * IMPLIED WARRANTIES OF MERCHANTABILITY AND FITNESS FOR A PARTICULAR PURPOSE ARE
 * DISCLAIMED. IN NO EVENT SHALL THE COPYRIGHT HOLDER OR CONTRIBUTORS BE LIABLE
 * FOR ANY DIRECT, INDIRECT, INCIDENTAL, SPECIAL, EXEMPLARY, OR CONSEQUENTIAL
 * DAMAGES (INCLUDING, BUT NOT LIMITED TO, PROCUREMENT OF SUBSTITUTE GOODS OR
 * SERVICES; LOSS OF USE, DATA, OR PROFITS; OR BUSINESS INTERRUPTION) HOWEVER
 * CAUSED AND ON ANY THEORY OF LIABILITY, WHETHER IN CONTRACT, STRICT LIABILITY,
 * OR TORT (INCLUDING NEGLIGENCE OR OTHERWISE) ARISING IN ANY WAY OUT OF THE USE
 * OF THIS SOFTWARE, EVEN IF ADVISED OF THE POSSIBILITY OF SUCH DAMAGE.
 *******************************************************************************
 */
#include "Arduino.h"
#include "PeripheralPins.h"

// =====
// Note: Commented lines are alternative possibilities which are not used per default.
//       If you change them, you will have to know what you do
// =====


//*** ADC ***

#ifdef HAL_ADC_MODULE_ENABLED
const PinMap PinMap_ADC[] = {
    {PA_0,   ADC1,  STM_PIN_DATA_EXT(STM_MODE_ANALOG, GPIO_NOPULL, 0, 1, 0)}, // ADC1_IN1 - A0
    {PA_1,   ADC1,  STM_PIN_DATA_EXT(STM_MODE_ANALOG, GPIO_NOPULL, 0, 2, 0)}, // ADC1_IN2 - A1
//  {PA_2,   ADC1,  STM_PIN_DATA_EXT(STM_MODE_ANALOG, GPIO_NOPULL, 0, 3, 0)}, // ADC1_IN3 - STLink Tx
//  {PA_3,   ADC1,  STM_PIN_DATA_EXT(STM_MODE_ANALOG, GPIO_NOPULL, 0, 4, 0)}, // ADC1_IN4 - STLink Rx
    //{PA_4,   ADC2,  STM_PIN_DATA_EXT(STM_MODE_ANALOG, GPIO_NOPULL, 0, 1, 0)}, // ADC2_IN1 - A2
//  {PA_5,   ADC2,  STM_PIN_DATA_EXT(STM_MODE_ANALOG, GPIO_NOPULL, 0, 2, 0)}, // ADC2_IN2 - LED1
    {PA_6,   ADC2,  STM_PIN_DATA_EXT(STM_MODE_ANALOG, GPIO_NOPULL, 0, 3, 0)}, // ADC2_IN3
    {PA_7,   ADC2,  STM_PIN_DATA_EXT(STM_MODE_ANALOG, GPIO_NOPULL, 0, 4, 0)}, // ADC2_IN4
    {PB_0,   ADC3,  STM_PIN_DATA_EXT(STM_MODE_ANALOG, GPIO_NOPULL, 0, 12, 0)}, // ADC3_IN12
//  {PB_1,   ADC3,  STM_PIN_DATA_EXT(STM_MODE_ANALOG, GPIO_NOPULL, 0, 1, 0)}, // ADC3_IN1
    {PB_2,   ADC2,  STM_PIN_DATA_EXT(STM_MODE_ANALOG, GPIO_NOPULL, 0, 12, 0)}, // ADC2_IN12
    {PB_11,  ADC1,  STM_PIN_DATA_EXT(STM_MODE_ANALOG, GPIO_NOPULL, 0, 14, 0)}, // ADC1_IN14
//  {PB_11,  ADC2,  STM_PIN_DATA_EXT(STM_MODE_ANALOG, GPIO_NOPULL, 0, 14, 0)}, // ADC2_IN14
//  {PB_12,  ADC4,  STM_PIN_DATA_EXT(STM_MODE_ANALOG, GPIO_NOPULL, 0, 3, 0)}, // ADC4_IN3
//  {PB_13,  ADC3,  STM_PIN_DATA_EXT(STM_MODE_ANALOG, GPIO_NOPULL, 0, 5, 0)}, // ADC3_IN5
//  {PB_14,  ADC4,  STM_PIN_DATA_EXT(STM_MODE_ANALOG, GPIO_NOPULL, 0, 4, 0)}, // ADC4_IN4
//  {PB_15,  ADC4,  STM_PIN_DATA_EXT(STM_MODE_ANALOG, GPIO_NOPULL, 0, 5, 0)}, // ADC4_IN5
    {PC_0,   ADC1,  STM_PIN_DATA_EXT(STM_MODE_ANALOG, GPIO_NOPULL, 0, 6, 0)}, // ADC1_IN6 - A5
//  {PC_0,   ADC2,  STM_PIN_DATA_EXT(STM_MODE_ANALOG, GPIO_NOPULL, 0, 6, 0)}, // ADC2_IN6 - A5
    {PC_1,   ADC1,  STM_PIN_DATA_EXT(STM_MODE_ANALOG, GPIO_NOPULL, 0, 7, 0)}, // ADC1_IN7 - A4
//  {PC_1,   ADC2,  STM_PIN_DATA_EXT(STM_MODE_ANALOG, GPIO_NOPULL, 0, 7, 0)}, // ADC2_IN7 - A4
    {PC_2,   ADC1,  STM_PIN_DATA_EXT(STM_MODE_ANALOG, GPIO_NOPULL, 0, 8, 0)}, // ADC1_IN8
//  {PC_2,   ADC2,  STM_PIN_DATA_EXT(STM_MODE_ANALOG, GPIO_NOPULL, 0, 8, 0)}, // ADC2_IN8
    {PC_3,   ADC1,  STM_PIN_DATA_EXT(STM_MODE_ANALOG, GPIO_NOPULL, 0, 9, 0)}, // ADC1_IN9
//  {PC_3,   ADC2,  STM_PIN_DATA_EXT(STM_MODE_ANALOG, GPIO_NOPULL, 0, 9, 0)}, // ADC2_IN9
    {PC_4,   ADC2,  STM_PIN_DATA_EXT(STM_MODE_ANALOG, GPIO_NOPULL, 0, 5, 0)}, // ADC2_IN5
    {PC_5,   ADC2,  STM_PIN_DATA_EXT(STM_MODE_ANALOG, GPIO_NOPULL, 0, 11, 0)}, // ADC2_IN11
    {NC,   NP,    0}
};
#endif

//*** DAC ***

#ifdef HAL_DAC_MODULE_ENABLED
const PinMap PinMap_DAC[] = {
    //{PA_4,   DAC1, STM_PIN_DATA_EXT(STM_MODE_ANALOG, GPIO_NOPULL, 0, 1, 0)}, // DAC1_OUT1
    {PA_5,   DAC1, STM_PIN_DATA_EXT(STM_MODE_ANALOG, GPIO_NOPULL, 0, 2, 0)}, // DAC1_OUT2 - LED1
    {NC,   NP,    0}
};
#endif

//*** I2C ***

#ifdef HAL_I2C_MODULE_ENABLED
const PinMap PinMap_I2C_SDA[] = {
    {PA_10,  I2C2, STM_PIN_DATA(STM_MODE_AF_OD, GPIO_NOPULL, GPIO_AF4_I2C2)},
    {PA_14,  I2C1, STM_PIN_DATA(STM_MODE_AF_OD, GPIO_NOPULL, GPIO_AF4_I2C1)},
    {PB_5,   I2C3, STM_PIN_DATA(STM_MODE_AF_OD, GPIO_NOPULL, GPIO_AF8_I2C3)},
    {PB_7,   I2C1, STM_PIN_DATA(STM_MODE_AF_OD, GPIO_NOPULL, GPIO_AF4_I2C1)},
    {PB_9,   I2C1, STM_PIN_DATA(STM_MODE_AF_OD, GPIO_NOPULL, GPIO_AF4_I2C1)},
    {PC_9,   I2C3, STM_PIN_DATA(STM_MODE_AF_OD, GPIO_NOPULL, GPIO_AF3_I2C3)},
    {PF_0,   I2C2, STM_PIN_DATA(STM_MODE_AF_OD, GPIO_NOPULL, GPIO_AF4_I2C2)},
    {NC,    NP,    0}
};
#endif

#ifdef HAL_I2C_MODULE_ENABLED
const PinMap PinMap_I2C_SCL[] = {
    {PA_8,   I2C3, STM_PIN_DATA(STM_MODE_AF_OD, GPIO_NOPULL, GPIO_AF3_I2C3)},
    {PA_9,   I2C2, STM_PIN_DATA(STM_MODE_AF_OD, GPIO_NOPULL, GPIO_AF4_I2C2)},
    {PA_15,  I2C1, STM_PIN_DATA(STM_MODE_AF_OD, GPIO_NOPULL, GPIO_AF4_I2C1)},
    {PB_6,   I2C1, STM_PIN_DATA(STM_MODE_AF_OD, GPIO_NOPULL, GPIO_AF4_I2C1)},
    {PB_8,   I2C1, STM_PIN_DATA(STM_MODE_AF_OD, GPIO_NOPULL, GPIO_AF4_I2C1)},
    {PF_1,   I2C2, STM_PIN_DATA(STM_MODE_AF_OD, GPIO_NOPULL, GPIO_AF4_I2C2)},
    {NC,    NP,    0}
};
#endif

//*** PWM ***

#ifdef HAL_TIM_MODULE_ENABLED
const PinMap PinMap_PWM[] = {
//  {PA_0,   TIM2,   STM_PIN_DATA_EXT(STM_MODE_AF_PP, GPIO_PULLUP, GPIO_AF1_TIM2, 1, 0)},  // TIM2_CH1
    {PA_1,   TIM15,  STM_PIN_DATA_EXT(STM_MODE_AF_PP, GPIO_PULLUP, GPIO_AF9_TIM15, 1, 1)},  // TIM15_CH1N
//  {PA_1,   TIM2,   STM_PIN_DATA_EXT(STM_MODE_AF_PP, GPIO_PULLUP, GPIO_AF1_TIM2, 2, 0)},  // TIM2_CH2
//  {PA_2,   TIM15,  STM_PIN_DATA_EXT(STM_MODE_AF_PP, GPIO_PULLUP, GPIO_AF9_TIM15, 1, 0)},  // TIM15_CH1 - STLink Tx
//  {PA_2,   TIM2,   STM_PIN_DATA_EXT(STM_MODE_AF_PP, GPIO_PULLUP, GPIO_AF1_TIM2, 3, 0)},  // TIM2_CH3 - STLink Tx
//  {PA_3,   TIM15,  STM_PIN_DATA_EXT(STM_MODE_AF_PP, GPIO_PULLUP, GPIO_AF9_TIM15, 2, 0)},  // TIM15_CH2 - STLink Rx
//  {PA_3,   TIM2,   STM_PIN_DATA_EXT(STM_MODE_AF_PP, GPIO_PULLUP, GPIO_AF1_TIM2, 4, 0)},  // TIM2_CH4 - STLink Rx
    {PA_4,   TIM3,   STM_PIN_DATA_EXT(STM_MODE_AF_PP, GPIO_PULLUP, GPIO_AF2_TIM3, 2, 0)},  // TIM3_CH2
//  {PA_5,   TIM2,   STM_PIN_DATA_EXT(STM_MODE_AF_PP, GPIO_PULLUP, GPIO_AF1_TIM2, 1, 0)},  // TIM2_CH1
    {PA_6,   TIM16,  STM_PIN_DATA_EXT(STM_MODE_AF_PP, GPIO_PULLUP, GPIO_AF1_TIM16, 1, 0)},  // TIM16_CH1
//  {PA_6,   TIM3,   STM_PIN_DATA_EXT(STM_MODE_AF_PP, GPIO_PULLUP, GPIO_AF2_TIM3, 1, 0)},  // TIM3_CH1
    {PA_7,   TIM17,  STM_PIN_DATA_EXT(STM_MODE_AF_PP, GPIO_PULLUP, GPIO_AF1_TIM17, 1, 0)},  // TIM17_CH1
//  {PA_7,   TIM1,   STM_PIN_DATA_EXT(STM_MODE_AF_PP, GPIO_PULLUP, GPIO_AF6_TIM1, 1, 1)},  // TIM1_CH1N
//  {PA_7,   TIM3,   STM_PIN_DATA_EXT(STM_MODE_AF_PP, GPIO_PULLUP, GPIO_AF2_TIM3, 2, 0)},  // TIM3_CH2
//  {PA_7,   TIM8,   STM_PIN_DATA_EXT(STM_MODE_AF_PP, GPIO_PULLUP, GPIO_AF4_TIM8, 1, 1)},  // TIM8_CH1N
    {PA_8,   TIM1,   STM_PIN_DATA_EXT(STM_MODE_AF_PP, GPIO_PULLUP, GPIO_AF6_TIM1, 1, 0)},  // TIM1_CH1
    {PA_9,   TIM1,   STM_PIN_DATA_EXT(STM_MODE_AF_PP, GPIO_PULLUP, GPIO_AF6_TIM1, 2, 0)},  // TIM1_CH2
//  {PA_9,   TIM2,   STM_PIN_DATA_EXT(STM_MODE_AF_PP, GPIO_PULLUP, GPIO_AF10_TIM2, 3, 0)},  // TIM2_CH3
    {PA_10,  TIM1,   STM_PIN_DATA_EXT(STM_MODE_AF_PP, GPIO_PULLUP, GPIO_AF6_TIM1, 3, 0)},  // TIM1_CH3
//  {PA_10,  TIM2,   STM_PIN_DATA_EXT(STM_MODE_AF_PP, GPIO_PULLUP, GPIO_AF10_TIM2, 4, 0)},  // TIM2_CH4
//  {PA_11,  TIM1,   STM_PIN_DATA_EXT(STM_MODE_AF_PP, GPIO_PULLUP, GPIO_AF6_TIM1, 1, 1)},  // TIM1_CH1N
    {PA_11,  TIM1,   STM_PIN_DATA_EXT(STM_MODE_AF_PP, GPIO_PULLUP, GPIO_AF11_TIM1, 4, 0)},  // TIM1_CH4
//  {PA_11,  TIM4,   STM_PIN_DATA_EXT(STM_MODE_AF_PP, GPIO_PULLUP, GPIO_AF10_TIM4, 1, 0)},  // TIM4_CH1
    {PA_12,  TIM16,  STM_PIN_DATA_EXT(STM_MODE_AF_PP, GPIO_PULLUP, GPIO_AF1_TIM16, 1, 0)},  // TIM16_CH1
//  {PA_12,  TIM1,   STM_PIN_DATA_EXT(STM_MODE_AF_PP, GPIO_PULLUP, GPIO_AF6_TIM1, 2, 1)},  // TIM1_CH2N
//  {PA_12,  TIM4,   STM_PIN_DATA_EXT(STM_MODE_AF_PP, GPIO_PULLUP, GPIO_AF10_TIM4, 2, 0)},  // TIM4_CH2
    {PA_13,  TIM16,  STM_PIN_DATA_EXT(STM_MODE_AF_PP, GPIO_PULLUP, GPIO_AF1_TIM16, 1, 1)},  // TIM16_CH1N
//  {PA_13,  TIM4,   STM_PIN_DATA_EXT(STM_MODE_AF_PP, GPIO_PULLUP, GPIO_AF10_TIM4, 3, 0)},  // TIM4_CH3
    {PA_14,  TIM8,   STM_PIN_DATA_EXT(STM_MODE_AF_PP, GPIO_PULLUP, GPIO_AF5_TIM8, 2, 0)},  // TIM8_CH2
//  {PA_15,  TIM2,   STM_PIN_DATA_EXT(STM_MODE_AF_PP, GPIO_PULLUP, GPIO_AF1_TIM2, 1, 0)},  // TIM2_CH1
    {PA_15,  TIM8,   STM_PIN_DATA_EXT(STM_MODE_AF_PP, GPIO_PULLUP, GPIO_AF2_TIM8, 1, 0)},  // TIM8_CH1
    {PB_0,   TIM1,   STM_PIN_DATA_EXT(STM_MODE_AF_PP, GPIO_PULLUP, GPIO_AF6_TIM1, 2, 1)},  // TIM1_CH2N
//  {PB_0,   TIM3,   STM_PIN_DATA_EXT(STM_MODE_AF_PP, GPIO_PULLUP, GPIO_AF2_TIM3, 3, 0)},  // TIM3_CH3
//  {PB_0,   TIM8,   STM_PIN_DATA_EXT(STM_MODE_AF_PP, GPIO_PULLUP, GPIO_AF4_TIM8, 2, 1)},  // TIM8_CH2N
//  {PB_1,   TIM1,   STM_PIN_DATA_EXT(STM_MODE_AF_PP, GPIO_PULLUP, GPIO_AF6_TIM1, 3, 1)},  // TIM1_CH3N
//  {PB_1,   TIM3,   STM_PIN_DATA_EXT(STM_MODE_AF_PP, GPIO_PULLUP, GPIO_AF2_TIM3, 4, 0)},  // TIM3_CH4
//  {PB_1,   TIM8,   STM_PIN_DATA_EXT(STM_MODE_AF_PP, GPIO_PULLUP, GPIO_AF4_TIM8, 3, 1)},  // TIM8_CH3N
//  {PB_3,   TIM2,   STM_PIN_DATA_EXT(STM_MODE_AF_PP, GPIO_PULLUP, GPIO_AF1_TIM2, 2, 0)},  // TIM2_CH2
    {PB_3,   TIM8,   STM_PIN_DATA_EXT(STM_MODE_AF_PP, GPIO_PULLUP, GPIO_AF4_TIM8, 1, 1)},  // TIM8_CH1N
    {PB_4,   TIM16,  STM_PIN_DATA_EXT(STM_MODE_AF_PP, GPIO_PULLUP, GPIO_AF1_TIM16, 1, 0)},  // TIM16_CH1
//  {PB_4,   TIM3,   STM_PIN_DATA_EXT(STM_MODE_AF_PP, GPIO_PULLUP, GPIO_AF2_TIM3, 1, 0)},  // TIM3_CH1
//  {PB_4,   TIM8,   STM_PIN_DATA_EXT(STM_MODE_AF_PP, GPIO_PULLUP, GPIO_AF4_TIM8, 2, 1)},  // TIM8_CH2N
    {PB_5,   TIM17,  STM_PIN_DATA_EXT(STM_MODE_AF_PP, GPIO_PULLUP, GPIO_AF10_TIM17, 1, 0)},  // TIM17_CH1
//  {PB_5,   TIM3,   STM_PIN_DATA_EXT(STM_MODE_AF_PP, GPIO_PULLUP, GPIO_AF2_TIM3, 2, 0)},  // TIM3_CH2
//  {PB_5,   TIM8,   STM_PIN_DATA_EXT(STM_MODE_AF_PP, GPIO_PULLUP, GPIO_AF3_TIM8, 3, 1)},  // TIM8_CH3N
    {PB_6,   TIM16,  STM_PIN_DATA_EXT(STM_MODE_AF_PP, GPIO_PULLUP, GPIO_AF1_TIM16, 1, 1)},  // TIM16_CH1N
//  {PB_6,   TIM4,   STM_PIN_DATA_EXT(STM_MODE_AF_PP, GPIO_PULLUP, GPIO_AF2_TIM4, 1, 0)},  // TIM4_CH1
//  {PB_6,   TIM8,   STM_PIN_DATA_EXT(STM_MODE_AF_PP, GPIO_PULLUP, GPIO_AF5_TIM8, 1, 0)},  // TIM8_CH1
    {PB_7,   TIM17,  STM_PIN_DATA_EXT(STM_MODE_AF_PP, GPIO_PULLUP, GPIO_AF1_TIM17, 1, 1)},  // TIM17_CH1N
//  {PB_7,   TIM3,   STM_PIN_DATA_EXT(STM_MODE_AF_PP, GPIO_PULLUP, GPIO_AF10_TIM3, 4, 0)},  // TIM3_CH4
//  {PB_7,   TIM4,   STM_PIN_DATA_EXT(STM_MODE_AF_PP, GPIO_PULLUP, GPIO_AF2_TIM4, 2, 0)},  // TIM4_CH2
    {PB_8,   TIM16,  STM_PIN_DATA_EXT(STM_MODE_AF_PP, GPIO_PULLUP, GPIO_AF1_TIM16, 1, 0)},  // TIM16_CH1
//  {PB_8,   TIM4,   STM_PIN_DATA_EXT(STM_MODE_AF_PP, GPIO_PULLUP, GPIO_AF2_TIM4, 3, 0)},  // TIM4_CH3
//  {PB_8,   TIM8,   STM_PIN_DATA_EXT(STM_MODE_AF_PP, GPIO_PULLUP, GPIO_AF10_TIM8, 2, 0)},  // TIM8_CH2
    {PB_9,   TIM17,  STM_PIN_DATA_EXT(STM_MODE_AF_PP, GPIO_PULLUP, GPIO_AF1_TIM17, 1, 0)},  // TIM17_CH1
//  {PB_9,   TIM4,   STM_PIN_DATA_EXT(STM_MODE_AF_PP, GPIO_PULLUP, GPIO_AF2_TIM4, 4, 0)},  // TIM4_CH4
//  {PB_9,   TIM8,   STM_PIN_DATA_EXT(STM_MODE_AF_PP, GPIO_PULLUP, GPIO_AF10_TIM8, 3, 0)},  // TIM8_CH3
    {PB_10,  TIM2,   STM_PIN_DATA_EXT(STM_MODE_AF_PP, GPIO_PULLUP, GPIO_AF1_TIM2, 3, 0)},  // TIM2_CH3
//  {PB_11,  TIM2,   STM_PIN_DATA_EXT(STM_MODE_AF_PP, GPIO_PULLUP, GPIO_AF1_TIM2, 4, 0)},  // TIM2_CH4
    {PB_13,  TIM1,   STM_PIN_DATA_EXT(STM_MODE_AF_PP, GPIO_PULLUP, GPIO_AF6_TIM1, 1, 1)},  // TIM1_CH1N
    {PB_14,  TIM15,  STM_PIN_DATA_EXT(STM_MODE_AF_PP, GPIO_PULLUP, GPIO_AF1_TIM15, 1, 0)},  // TIM15_CH1
//  {PB_14,  TIM1,   STM_PIN_DATA_EXT(STM_MODE_AF_PP, GPIO_PULLUP, GPIO_AF6_TIM1, 2, 1)},  // TIM1_CH2N
//  {PB_15,  TIM15,  STM_PIN_DATA_EXT(STM_MODE_AF_PP, GPIO_PULLUP, GPIO_AF2_TIM15, 1, 1)},  // TIM15_CH1N
    {PB_15,  TIM15,  STM_PIN_DATA_EXT(STM_MODE_AF_PP, GPIO_PULLUP, GPIO_AF1_TIM15, 2, 0)},  // TIM15_CH2
//  {PB_15,  TIM1,   STM_PIN_DATA_EXT(STM_MODE_AF_PP, GPIO_PULLUP, GPIO_AF4_TIM1, 3, 1)},  // TIM1_CH3N
    {PC_0,   TIM1,   STM_PIN_DATA_EXT(STM_MODE_AF_PP, GPIO_PULLUP, GPIO_AF2_TIM1, 1, 0)},  // TIM1_CH1
    {PC_1,   TIM1,   STM_PIN_DATA_EXT(STM_MODE_AF_PP, GPIO_PULLUP, GPIO_AF2_TIM1, 2, 0)},  // TIM1_CH2
    {PC_2,   TIM1,   STM_PIN_DATA_EXT(STM_MODE_AF_PP, GPIO_PULLUP, GPIO_AF2_TIM1, 3, 0)},  // TIM1_CH3
    {PC_3,   TIM1,   STM_PIN_DATA_EXT(STM_MODE_AF_PP, GPIO_PULLUP, GPIO_AF2_TIM1, 4, 0)},  // TIM1_CH4
    {PC_6,   TIM3,   STM_PIN_DATA_EXT(STM_MODE_AF_PP, GPIO_PULLUP, GPIO_AF2_TIM3, 1, 0)},  // TIM3_CH1
//  {PC_6,   TIM8,   STM_PIN_DATA_EXT(STM_MODE_AF_PP, GPIO_PULLUP, GPIO_AF4_TIM8, 1, 0)},  // TIM8_CH1
    {PC_7,   TIM3,   STM_PIN_DATA_EXT(STM_MODE_AF_PP, GPIO_PULLUP, GPIO_AF2_TIM3, 2, 0)},  // TIM3_CH2
//  {PC_7,   TIM8,   STM_PIN_DATA_EXT(STM_MODE_AF_PP, GPIO_PULLUP, GPIO_AF4_TIM8, 2, 0)},  // TIM8_CH2
    {PC_8,   TIM3,   STM_PIN_DATA_EXT(STM_MODE_AF_PP, GPIO_PULLUP, GPIO_AF2_TIM3, 3, 0)},  // TIM3_CH3
//  {PC_8,   TIM8,   STM_PIN_DATA_EXT(STM_MODE_AF_PP, GPIO_PULLUP, GPIO_AF4_TIM8, 3, 0)},  // TIM8_CH3
    {PC_9,   TIM3,   STM_PIN_DATA_EXT(STM_MODE_AF_PP, GPIO_PULLUP, GPIO_AF2_TIM3, 4, 0)},  // TIM3_CH4
//  {PC_9,   TIM8,   STM_PIN_DATA_EXT(STM_MODE_AF_PP, GPIO_PULLUP, GPIO_AF4_TIM8, 4, 0)},  // TIM8_CH4
    {PC_10,  TIM8,   STM_PIN_DATA_EXT(STM_MODE_AF_PP, GPIO_PULLUP, GPIO_AF4_TIM8, 1, 1)},  // TIM8_CH1N
    {PC_11,  TIM8,   STM_PIN_DATA_EXT(STM_MODE_AF_PP, GPIO_PULLUP, GPIO_AF4_TIM8, 2, 1)},  // TIM8_CH2N
    {PC_12,  TIM8,   STM_PIN_DATA_EXT(STM_MODE_AF_PP, GPIO_PULLUP, GPIO_AF4_TIM8, 3, 1)},  // TIM8_CH3N
    {PC_13,  TIM1,   STM_PIN_DATA_EXT(STM_MODE_AF_PP, GPIO_PULLUP, GPIO_AF4_TIM1, 1, 1)},  // TIM1_CH1N
    {PF_0,   TIM1,   STM_PIN_DATA_EXT(STM_MODE_AF_PP, GPIO_PULLUP, GPIO_AF6_TIM1, 3, 1)},  // TIM1_CH3N
    {NC,    NP,    0}
};
#endif

//*** SERIAL ***

#ifdef HAL_UART_MODULE_ENABLED
const PinMap PinMap_UART_TX[] = {
    {PA_2,   USART2,  STM_PIN_DATA(STM_MODE_AF_PP, GPIO_PULLUP, GPIO_AF7_USART2)},
    {PA_9,   USART1,  STM_PIN_DATA(STM_MODE_AF_PP, GPIO_PULLUP, GPIO_AF7_USART1)},
    {PA_14,  USART2,  STM_PIN_DATA(STM_MODE_AF_PP, GPIO_PULLUP, GPIO_AF7_USART2)},
    {PB_3,   USART2,  STM_PIN_DATA(STM_MODE_AF_PP, GPIO_PULLUP, GPIO_AF7_USART2)},
    {PB_6,   USART1,  STM_PIN_DATA(STM_MODE_AF_PP, GPIO_PULLUP, GPIO_AF7_USART1)},
    {PB_9,   USART3,  STM_PIN_DATA(STM_MODE_AF_PP, GPIO_PULLUP, GPIO_AF7_USART3)},
    {PB_10,  USART3,  STM_PIN_DATA(STM_MODE_AF_PP, GPIO_PULLUP, GPIO_AF7_USART3)},
    {PC_4,   USART1,  STM_PIN_DATA(STM_MODE_AF_PP, GPIO_PULLUP, GPIO_AF7_USART1)},
    {PC_10,  UART4,   STM_PIN_DATA(STM_MODE_AF_PP, GPIO_PULLUP, GPIO_AF5_UART4)},
//  {PC_10,  USART3,  STM_PIN_DATA(STM_MODE_AF_PP, GPIO_PULLUP, GPIO_AF7_USART3)},
    {PC_12,  UART5,   STM_PIN_DATA(STM_MODE_AF_PP, GPIO_PULLUP, GPIO_AF5_UART5)},
    {NC,    NP,    0}
};
#endif

#ifdef HAL_UART_MODULE_ENABLED
const PinMap PinMap_UART_RX[] = {
    {PA_3,   USART2,  STM_PIN_DATA(STM_MODE_AF_PP, GPIO_PULLUP, GPIO_AF7_USART2)},
    {PA_10,  USART1,  STM_PIN_DATA(STM_MODE_AF_PP, GPIO_PULLUP, GPIO_AF7_USART1)},
    {PA_15,  USART2,  STM_PIN_DATA(STM_MODE_AF_PP, GPIO_PULLUP, GPIO_AF7_USART2)},
    {PB_4,   USART2,  STM_PIN_DATA(STM_MODE_AF_PP, GPIO_PULLUP, GPIO_AF7_USART2)},
    {PB_7,   USART1,  STM_PIN_DATA(STM_MODE_AF_PP, GPIO_PULLUP, GPIO_AF7_USART1)},
    {PB_8,   USART3,  STM_PIN_DATA(STM_MODE_AF_PP, GPIO_PULLUP, GPIO_AF7_USART3)},
    {PB_11,  USART3,  STM_PIN_DATA(STM_MODE_AF_PP, GPIO_PULLUP, GPIO_AF7_USART3)},
    {PC_5,   USART1,  STM_PIN_DATA(STM_MODE_AF_PP, GPIO_PULLUP, GPIO_AF7_USART1)},
    {PC_11,  UART4,   STM_PIN_DATA(STM_MODE_AF_PP, GPIO_PULLUP, GPIO_AF5_UART4)},
//  {PC_11,  USART3,  STM_PIN_DATA(STM_MODE_AF_PP, GPIO_PULLUP, GPIO_AF7_USART3)},
    {PD_2,   UART5,   STM_PIN_DATA(STM_MODE_AF_PP, GPIO_PULLUP, GPIO_AF5_UART5)},
    {NC,    NP,    0}
};
#endif

#ifdef HAL_UART_MODULE_ENABLED
const PinMap PinMap_UART_RTS[] = {
    {PA_1,   USART2,  STM_PIN_DATA(STM_MODE_AF_PP, GPIO_PULLUP, GPIO_AF7_USART2)},
    {PA_12,  USART1,  STM_PIN_DATA(STM_MODE_AF_PP, GPIO_PULLUP, GPIO_AF7_USART1)},
    {PB_14,  USART3,  STM_PIN_DATA(STM_MODE_AF_PP, GPIO_PULLUP, GPIO_AF7_USART3)},
    {NC,    NP,    0}
};
#endif

#ifdef HAL_UART_MODULE_ENABLED
const PinMap PinMap_UART_CTS[] = {
    {PA_0,   USART2,  STM_PIN_DATA(STM_MODE_AF_PP, GPIO_PULLUP, GPIO_AF7_USART2)},
    {PA_11,  USART1,  STM_PIN_DATA(STM_MODE_AF_PP, GPIO_PULLUP, GPIO_AF7_USART1)},
    {PA_13,  USART3,  STM_PIN_DATA(STM_MODE_AF_PP, GPIO_PULLUP, GPIO_AF7_USART3)},
    {PB_13,  USART3,  STM_PIN_DATA(STM_MODE_AF_PP, GPIO_PULLUP, GPIO_AF7_USART3)},
    {NC,    NP,    0}
};
#endif

//*** SPI ***

#ifdef HAL_SPI_MODULE_ENABLED
const PinMap PinMap_SPI_MOSI[] = {
    {PA_7,   SPI1, STM_PIN_DATA(STM_MODE_AF_PP, GPIO_PULLUP, GPIO_AF5_SPI1)},
    {PA_11,  SPI2, STM_PIN_DATA(STM_MODE_AF_PP, GPIO_PULLUP, GPIO_AF5_SPI2)},
//  {PB_5,   SPI1, STM_PIN_DATA(STM_MODE_AF_PP, GPIO_PULLUP, GPIO_AF5_SPI1)},
    {PB_5,   SPI3, STM_PIN_DATA(STM_MODE_AF_PP, GPIO_PULLUP, GPIO_AF6_SPI3)},
    {PB_15,  SPI2, STM_PIN_DATA(STM_MODE_AF_PP, GPIO_PULLUP, GPIO_AF5_SPI2)},
    {PC_12,  SPI3, STM_PIN_DATA(STM_MODE_AF_PP, GPIO_PULLUP, GPIO_AF6_SPI3)},
    {NC,    NP,    0}
};
#endif

#ifdef HAL_SPI_MODULE_ENABLED
const PinMap PinMap_SPI_MISO[] = {
    {PA_6,   SPI1, STM_PIN_DATA(STM_MODE_AF_PP, GPIO_PULLUP, GPIO_AF5_SPI1)},
    {PA_10,  SPI2, STM_PIN_DATA(STM_MODE_AF_PP, GPIO_PULLUP, GPIO_AF5_SPI2)},
//  {PB_4,   SPI1, STM_PIN_DATA(STM_MODE_AF_PP, GPIO_PULLUP, GPIO_AF5_SPI1)},
    {PB_4,   SPI3, STM_PIN_DATA(STM_MODE_AF_PP, GPIO_PULLUP, GPIO_AF6_SPI3)},
    {PB_14,  SPI2, STM_PIN_DATA(STM_MODE_AF_PP, GPIO_PULLUP, GPIO_AF5_SPI2)},
    {PC_11,  SPI3, STM_PIN_DATA(STM_MODE_AF_PP, GPIO_PULLUP, GPIO_AF6_SPI3)},
    {NC,    NP,    0}
};
#endif

#ifdef HAL_SPI_MODULE_ENABLED
const PinMap PinMap_SPI_SCLK[] = {
    {PA_5,   SPI1, STM_PIN_DATA(STM_MODE_AF_PP, GPIO_PULLUP, GPIO_AF5_SPI1)}, // LED1
//  {PB_3,   SPI1, STM_PIN_DATA(STM_MODE_AF_PP, GPIO_PULLUP, GPIO_AF5_SPI1)},
    {PB_3,   SPI3, STM_PIN_DATA(STM_MODE_AF_PP, GPIO_PULLUP, GPIO_AF6_SPI3)},
    {PB_13,  SPI2, STM_PIN_DATA(STM_MODE_AF_PP, GPIO_PULLUP, GPIO_AF5_SPI2)},
    {PC_10,  SPI3, STM_PIN_DATA(STM_MODE_AF_PP, GPIO_PULLUP, GPIO_AF6_SPI3)},
    {PF_1,   SPI2, STM_PIN_DATA(STM_MODE_AF_PP, GPIO_PULLUP, GPIO_AF5_SPI2)},
    {NC,    NP,    0}
};
#endif

#ifdef HAL_SPI_MODULE_ENABLED
const PinMap PinMap_SPI_SSEL[] = {
//  {PA_4,   SPI1, STM_PIN_DATA(STM_MODE_AF_PP, GPIO_PULLUP, GPIO_AF5_SPI1)},
//    {PA_4,   SPI3, STM_PIN_DATA(STM_MODE_AF_PP, GPIO_PULLUP, GPIO_AF6_SPI3)},
//  {PA_15,  SPI1, STM_PIN_DATA(STM_MODE_AF_PP, GPIO_PULLUP, GPIO_AF5_SPI1)},
    {PA_15,  SPI3, STM_PIN_DATA(STM_MODE_AF_PP, GPIO_PULLUP, GPIO_AF6_SPI3)},
    {PB_12,  SPI2, STM_PIN_DATA(STM_MODE_AF_PP, GPIO_PULLUP, GPIO_AF5_SPI2)},
    {PF_0,   SPI2, STM_PIN_DATA(STM_MODE_AF_PP, GPIO_PULLUP, GPIO_AF5_SPI2)},
    {NC,    NP,    0}
};
#endif

//*** CAN ***

#ifdef HAL_CAN_MODULE_ENABLED
const PinMap PinMap_CAN_RD[] = {
    {PA_11,  CAN1, STM_PIN_DATA(STM_MODE_AF_PP, GPIO_NOPULL, GPIO_AF9_CAN)},
    {PB_8,   CAN1, STM_PIN_DATA(STM_MODE_AF_PP, GPIO_NOPULL, GPIO_AF9_CAN)},
    {NC,    NP,    0}
};
#endif

#ifdef HAL_CAN_MODULE_ENABLED
const PinMap PinMap_CAN_TD[] = {
    {PA_12,  CAN1, STM_PIN_DATA(STM_MODE_AF_PP, GPIO_NOPULL, GPIO_AF9_CAN)},
    {PB_9,   CAN1, STM_PIN_DATA(STM_MODE_AF_PP, GPIO_NOPULL, GPIO_AF9_CAN)},
    {NC,    NP,    0}
};
#endif
