ChriD/konnekting-TouchButtonSwitch/TouchButtonSwitch/src/BaseSwitch.h

/*
  BaseSwitch.h
  Created by Christian Dürnberger, 2019
  Released into the public domain.
*/


#ifndef BaseSwitch_h
#define BaseSwitch_h

  #include "Arduino.h"
  #include "Button.h"


  #define SWITCH_MAX_BUTTONCOUNT       10

  // a switch does have some standrt modes
  // TODO: @@@
  enum class SWITCH_MODE { NORMAL = 0, PROG = 10, SETUP = 20, CALIBRATION = 30, UNDEFINED = 99};


  struct BaseSwitchSpeakerStruct
  {
    boolean clickFeedbackEnabled;
    uint32_t clickFeedbackFrequency;
    uint16_t clickFeedbackDuration;
  };
  typedef struct BaseSwitchSpeakerStruct BaseSwitchSpeaker;


  struct BaseSwitchLightningStruct
  {
    uint8_t stdR;
    uint8_t stdG;
    uint8_t stdB;
    uint8_t stdBrightness; //(0-255)
  };
  typedef struct BaseSwitchLightningStruct BaseSwitchLightning;


  // some structures and typedefs for the evironmentla sensors a button may have
  struct BaseSwitchEnvSensorStruct
  {
    boolean   temperature;
    float     temperatureAdj;
    uint64_t  temperaturePeriod;
    float     temperatureWarningLow;
    float     temperatureWarningHigh;
    boolean   humidity;
    float     humidityAdj;
    uint64_t  humidityPeriod;
    float     humidityWarningLow;
    float     humidityWarningHigh;
    boolean   pressure;
  };
  typedef struct BaseSwitchEnvSensorStruct BaseSwitchEnvSensors;

  struct BaseSwitchEnvDataStruct
  {
    float temperature;
    float humidity;
    float pressure;
  };
  typedef struct BaseSwitchEnvDataStruct BaseSwitchEnvData;



  typedef Functor4<SWITCH_MODE, uint16_t, SWITCH_MODE, uint16_t> CallbackFunction_ModeChange;
  typedef Functor1<BaseSwitchEnvData> CallbackFunction_EnvDataUpdated;


  class BaseSwitch
  {
    public:
      BaseSwitch();
      ~BaseSwitch();

      virtual boolean setup();
      virtual void task();
      virtual void startCalibration();
      virtual Button* getButtonById(uint16_t);
      virtual Button* getButtonByIndex(uint16_t);
      virtual void setMode(SWITCH_MODE, uint16_t _modeLevel = 0);
      virtual void setButtonParameters(uint16_t, ButtonParms);
      virtual void requestEnvironmentData();

      void attachCallbackOnButtonAction(const CallbackFunction_ButtonAction &);
      void attachCallbackOnProximityAlert(const CallbackFunction_ProximityAlert &);
      void attachCallbackOnModeChange(const CallbackFunction_ModeChange &);
      void attachCallbackOnEnvDataUpdated(const CallbackFunction_EnvDataUpdated &);

      BaseSwitchEnvSensors parmEnvSensorsSettings();
      virtual void parmEnvSensorsSettings(BaseSwitchEnvSensors);

      BaseSwitchLightning parmLightningSettings();
      virtual void parmLightningSettings(BaseSwitchLightning);

      BaseSwitchSpeaker parmSpeakerSettings();
      virtual void parmSpeakerSettings(BaseSwitchSpeaker);


    protected:
      Button      *buttons[SWITCH_MAX_BUTTONCOUNT];

      // this one indicates the current mode of the switch
      // a switch may be in normal, programming, setup mode aso...
      SWITCH_MODE   mode;
      uint16_t      modeLevel;
      uint64_t      lastTaskRunTime ;

      // holds the last data read by the environmental sensors
      BaseSwitchEnvData     curEnvData;

      BaseSwitchEnvSensors  envSensorsSettings;
      BaseSwitchLightning   lightningSettings;
      BaseSwitchSpeaker     speakerSettings;

      CallbackFunction_ButtonAction       callback_onButtonAction;
      CallbackFunction_ProximityAlert     callback_onProximityAlert;
      CallbackFunction_ModeChange         callback_onModeChange;
      CallbackFunction_EnvDataUpdated     callback_onEnvDataUpdated;

      int8_t      maxButtonIdx;


      virtual void initButtons();
      virtual boolean setupButtons();
      virtual uint16_t addButton(Button*, uint16_t _buttonId = 0);

      virtual void onButtonStateChanged(uint16_t, uint16_t);
      virtual void onButtonAction(uint16_t, uint16_t, uint16_t);
      virtual void onProximityAlert(uint16_t, boolean, uint16_t, uint16_t);

      virtual uint64_t getPeriod(uint64_t _lastCallTime, bool _useMicros = false);

    private:

  };

#endif
