ChriD/konnekting-TouchButtonSwitch/hardware/variants/KONNEKTING_TOUCHSWITCH_F303RE/variant.cpp

/*
  Copyright (c) 2011 Arduino.  All right reserved.

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
  You should have received a copy of the GNU Lesser General Public
  License along with this library; if not, write to the Free Software
  Foundation, Inc., 51 Franklin St, Fifth Floor, Boston, MA  02110-1301  USA
*/

#include "variant.h"

#ifdef __cplusplus
extern "C" {
#endif

// Pin number
const PinName digitalPin[] = {
  PA_3,  //D0
  PA_2,  //D1
  PA_10, //D2
  PB_3,  //D3
  PB_5,  //D4
  PB_4,  //D5
  PB_10, //D6
  PA_8,  //D7
  PA_9,  //D8
  PC_7,  //D9
  PB_6,  //D10
  PA_7,  //D11
  PA_6,  //D12
  PA_5,  //D13
  PB_9,  //D14
  PB_8,  //D15
// ST Morpho
// CN7 Left Side
  PC_10, //D16
  PC_12, //D17
  PF_11, //D18 - BOOT0
  PA_13, //D19 - SWD
  PA_14, //D20 - SWD
  PA_15, //D21
  PB_7,  //D22
  PC_13, //D23
  PC_14, //D24
  PC_15, //D25
  PF_0,  //D26
  PF_1,  //D27
  PC_2,  //D28
  PC_3,  //D29
// CN7 Right Side
  PC_11, //D30
  PD_2,  //D31
// CN10 Left Side
  PC_9,  //D32
// CN10 Right side
  PC_8,  //D33
  PC_6,  //D34
  PC_5,  //D35
  PA_12, //D36
  PA_11, //D37
  PB_12, //D38
  PB_11, //D39
  PB_2,  //D40
  PB_1,  //D41
  PB_15, //D42
  PB_14, //D43
  PB_13, //D44
  PC_4,  //D45
  PA_0,  //D46/A0
  PA_1,  //D47/A1
  PA_4,  //D48/A2
  PB_0,  //D49/A3
  PC_1,  //D50/A4
  PC_0,  //D51/A5
  // Duplicated pins in order to be aligned with PinMap_ADC
  PA_7,  //D52/A6  = D11
  PA_6,  //D53/A7  = D12
  PC_2,  //D54/A8  = D28
  PC_3,  //D55/A9  = D29
  PC_5,  //D56/A10 = D35
  PB_11, //D57/A11 = D39
  PB_2,  //D58/A12 = D40
  PC_4   //D59/A13 = D45
};

#ifdef __cplusplus
}
#endif

// ----------------------------------------------------------------------------

#ifdef __cplusplus
extern "C" {
#endif

/**
  * @brief  System Clock Configuration
  * @param  None
  * @retval None
  */
WEAK void SystemClock_Config(void)
{
  RCC_OscInitTypeDef RCC_OscInitStruct;
  RCC_ClkInitTypeDef RCC_ClkInitStruct;

  RCC_OscInitStruct.OscillatorType = RCC_OSCILLATORTYPE_HSI;
  RCC_OscInitStruct.HSIState = RCC_HSI_ON;
  RCC_OscInitStruct.HSICalibrationValue = 16;
  RCC_OscInitStruct.PLL.PLLState = RCC_PLL_ON;
  RCC_OscInitStruct.PLL.PLLSource = RCC_PLLSOURCE_HSI;
  //RCC_OscInitStruct.PLL.PLLMUL = RCC_PLL_MUL9; // 72MHZ
  RCC_OscInitStruct.PLL.PLLMUL = RCC_PLL_MUL3; // 24MHZ 
  RCC_OscInitStruct.PLL.PREDIV = RCC_PREDIV_DIV1;
  HAL_RCC_OscConfig(&RCC_OscInitStruct);

  RCC_ClkInitStruct.ClockType = RCC_CLOCKTYPE_HCLK|RCC_CLOCKTYPE_SYSCLK
                              |RCC_CLOCKTYPE_PCLK1|RCC_CLOCKTYPE_PCLK2;
  RCC_ClkInitStruct.SYSCLKSource = RCC_SYSCLKSOURCE_PLLCLK;
  RCC_ClkInitStruct.AHBCLKDivider = RCC_SYSCLK_DIV1;
  RCC_ClkInitStruct.APB1CLKDivider = RCC_HCLK_DIV2;
  RCC_ClkInitStruct.APB2CLKDivider = RCC_HCLK_DIV1;
  HAL_RCC_ClockConfig(&RCC_ClkInitStruct, FLASH_LATENCY_2);

  HAL_SYSTICK_Config(HAL_RCC_GetHCLKFreq()/1000);

  HAL_SYSTICK_CLKSourceConfig(SYSTICK_CLKSOURCE_HCLK);

  /* SysTick_IRQn interrupt configuration */
  HAL_NVIC_SetPriority(SysTick_IRQn, 0, 0);
}

#ifdef __cplusplus
}
#endif
