ChriD/konnekting-TouchButtonSwitch/TouchButtonSwitch/src/CY8TouchSwitch.h

/*
  CY8TouchSwitch.h Library for controlling/handling a switch with several buttons
  Created by Christian Dürnberger, Mai 2018
  Released into the public domain.
*/

/* TODO:  * add temperature and humidity sensor
          * add TouchIC reboot (manually and automatic after )s ec beyond reset?)
          * auto reset proximity? after soem time
          * */

#ifndef CY8TouchSwitch_h
#define CY8TouchSwitch_h

    #include "CY8CMBR3116.h"
    #include "LEDWorker.h"
    #include "DebugUtil.h"


    #define TS_BUTTON_MODE_LONGTOUCH      0
    #define TS_BUTTON_MODE_POSITIONING    1

    #define TS_MODE_NORMAL    0
    #define TS_MODE_PROG      1
    #define TS_MODE_SETUP     2
    #define TS_MODE_STARTUP1  60
    #define TS_MODE_STARTUP2  61
    #define TS_MODE_STARTUP3  62
    #define TS_MODE_STARTUP4  63

    #define LIGHT_BACKGROUND_STANDARDSTANDBY    10
    #define LIGHT_BACKGROUND_STANDARDHIGHVALUE  200

    class CY8TouchSwitch
    {
      public:
        CY8TouchSwitch();
        ~CY8TouchSwitch();
        void setup();
        bool setupTouchController(uint8_t _setupConfig = 0);
        void task();
        void interrupt();
        void addButton(uint8_t _sensorId, uint8_t _ledPin, bool _enableMultipleTouch = false, bool _enablePositioningTouch = false);
        void setButtonParameters(uint8_t _sensorId, bool _enableMultipleTouch, uint8_t _mode);
        void setBacklightParameters(uint8_t _valueStandby = LIGHT_BACKGROUND_STANDARDSTANDBY, uint8_t _valueProximity = LIGHT_BACKGROUND_STANDARDHIGHVALUE);
        void setThresholds(uint16_t _touchThreshold, uint16_t _longTouchThreshold, uint16_t _positioningTouchThreshold);
        void changeMode(uint8_t _mode, bool _force = false);
        void resetTouchController();

        void setSensorStateChangedEventCallback(std::function<void(uint8_t, uint8_t, bool)>);
        void setTouchEventCallback(std::function<void(uint8_t, uint8_t, uint8_t)>);
        void setProximityEventCallback(std::function<void(uint8_t, uint8_t)>);
        void setGestureEventCallback(std::function<void(uint8_t)>);
        CY8CMBR3116* getTouchControllerObject();
      private:
        CY8CMBR3116 *touchController;
        LEDWorker   *ledWorkers[10];
        uint8_t     sendorIds[10];
        uint8_t     nextButtonIdx;
        uint8_t     mode;

        uint8_t     backlight_standbyValue;
        uint8_t     backlight_proximityValue;

        bool isSensorIdActive(uint8_t _sensorId);

        void sensorStateChangedEvent(uint8_t _sensorType, uint8_t _sensorId, bool _value);
        void touchEvent(uint8_t _sensorId, uint8_t _event, uint8_t _count);
        void proximityEvent(uint8_t _sensorId, uint8_t _event);
        void gestureEvent(uint8_t _event);

        void setMode_Normal();
        void setMode_Prog();
        void setMode_Setup();
        void setMode_Startup(uint8_t _startupLevel);

        uint8_t getBacklightStandbyValue();
        uint8_t getBacklightProximityValue();

        // we do forward the evens from the touch controller
        // for now there is no need to do any bug change, the only thing which will be done
        // is filtereing the events for the given button id's
        std::function<void(uint8_t, uint8_t, bool)> sensorStateChangedEventCallback;
        std::function<void(uint8_t, uint8_t, uint8_t)> touchEventCallback;
        std::function<void(uint8_t, uint8_t)> proximityEventCallback;
        std::function<void(uint8_t)> gestureEventCallback;
    };

#endif
