ChriD/konnekting-TouchButtonSwitch/TouchButtonSwitch/src/LedPatternsRGB.h

#ifndef LedPatternsRGB_h
#define LedPatternsRGB_h

#define STD_BRIGHTNESS 255

#define RED     STD_BRIGHTNESS,0,0
#define YELLOW  STD_BRIGHTNESS,STD_BRIGHTNESS,0
#define GREEN   0,STD_BRIGHTNESS,0
#define BLUE    0,0,STD_BRIGHTNESS
#define CYAN    255,67,20
#define MAGENTA STD_BRIGHTNESS,0,STD_BRIGHTNESS
#define WHITE   STD_BRIGHTNESS,STD_BRIGHTNESS,STD_BRIGHTNESS
#define OFF     0,0,0



const uint8_t ledPattern_Touch[] = {
    LedPattern::CMD_SET, OFF,
    LedPattern::CMD_SET, GREEN,
    LedPattern::CMD_WAIT, 50,
    LedPattern::CMD_SET, BLUE,
    LedPattern::CMD_FINISHED,
  };



const uint8_t ledPattern_Normal[] = {
    LedPattern::CMD_SET, OFF,
    LedPattern::CMD_SET, BLUE,
    LedPattern::CMD_FINISHED,
  };

const uint8_t ledPattern_Prog[] = {
     LedPattern::CMD_SET, OFF,
     LedPattern::CMD_REPEAT, LedPattern::repeatForever,
         LedPattern::CMD_SET, CYAN,
         LedPattern::CMD_WAIT, 25,
         LedPattern::CMD_SET, OFF,
         LedPattern::CMD_WAIT, 25,
     LedPattern::CMD_ENDREPEAT,
  };


const uint8_t ledPattern_Calibration[] = {
      LedPattern::CMD_SET, OFF,
      LedPattern::CMD_REPEAT, LedPattern::repeatForever,
         LedPattern::CMD_SET, WHITE,
         LedPattern::CMD_WAIT, 5,
         LedPattern::CMD_SET, OFF,
         LedPattern::CMD_WAIT, 5,
      LedPattern::CMD_ENDREPEAT,
  };


const uint8_t ledPattern_Setup[] = {
     LedPattern::CMD_SET, OFF,
     LedPattern::CMD_REPEAT, LedPattern::repeatForever,
         LedPattern::CMD_SET, YELLOW,
         LedPattern::CMD_WAIT, 50,
         LedPattern::CMD_SET, OFF,
         LedPattern::CMD_WAIT, 50,
     LedPattern::CMD_ENDREPEAT,
  };


const uint8_t ledPattern_Test[] = {
     LedPattern::CMD_SET, OFF,
     LedPattern::CMD_REPEAT, LedPattern::repeatForever,

                 LedPattern::CMD_SET, RED,
                 LedPattern::CMD_WAIT, 50,
                 LedPattern::CMD_SET, GREEN,
                 LedPattern::CMD_WAIT, 50,
                 LedPattern::CMD_SET, BLUE,
                 LedPattern::CMD_WAIT, 50,

     LedPattern::CMD_ENDREPEAT,
     /* LedPattern::CMD_FINISHED */ };


#endif
