ChriD/konnekting-TouchButtonSwitch/TouchButtonSwitch/src/TouchSwitch_4X_V1.h

/*
  TouchSwitch_4X_V1.h
  Created by Christian Dürnberger, 2019
  Released into the public domain.
*/


#ifndef TouchSwitch_4X_V1_h
#define TouchSwitch_4X_V1_h

  #include "Arduino.h"
  #include "TouchSwitch.h"
  #include "vendor/LedPattern_Mono.h"
  #include "LedPatterns.h"


  #define TS_4X_V1_BTN1_ID    1
  #define TS_4X_V1_BTN2_ID    2
  #define TS_4X_V1_BTN3_ID    3
  #define TS_4X_V1_BTN4_ID    4
  #define TS_4X_V1_PROX1_ID   10
  #define TS_4X_V1_PROX2_ID   11

  #define TS_4X_V1_BTN1_PIN   A1
  #define TS_4X_V1_BTN2_PIN   A0
  #define TS_4X_V1_BTN3_PIN   A5
  #define TS_4X_V1_BTN4_PIN   A3
  #define TS_4X_V1_PROX1_PIN  A2
  #define TS_4X_V1_PROX2_PIN  A4

  #define TS_4X_V1_LED_COUNT  4



  class TouchSwitch_4X_V1 : public TouchSwitch
  {
    public:
      TouchSwitch_4X_V1();
      ~TouchSwitch_4X_V1();

      virtual void initButtons();
      virtual void setMode(SWITCH_MODE, uint16_t _modeLevel = 0);
      virtual void task();

    protected:
      LedPattern_Mono *led1, *led2, *led3, *led4;
      uint64_t lastPatternRunTime;

      virtual void onButtonAction(uint16_t, uint16_t, uint16_t);

    private:


  };

#endif
