ChriD/konnekting-TouchButtonSwitch/stuff/attiny85_I2C_cypress_test.ino

#include <TinyWireM.h> 
/* CY8CMBR3116 Register Map Offset Address */
#define REGMAP_ORIGIN      0x00
#define SENSOR_PATTERN      0x00
#define FSS_EN          0x02
#define TOGGLE_EN       0x04
#define LED_ON_EN       0x06
#define SENSITIVITY0      0x08
#define SENSITIVITY1      0x09
#define SENSITIVITY2      0x0A
#define SENSITIVITY3      0x0B
#define BASE_THRESHOLD0     0x0C
#define BASE_THRESHOLD1     0x0D
#define FINGER_THRESHOLD2   0x0E
#define FINGER_THRESHOLD3   0x0F
#define FINGER_THRESHOLD4   0x10
#define FINGER_THRESHOLD5   0x11
#define FINGER_THRESHOLD6   0x12
#define FINGER_THRESHOLD7   0x13
#define FINGER_THRESHOLD8   0x14
#define FINGER_THRESHOLD9   0x15
#define FINGER_THRESHOLD10    0x16
#define FINGER_THRESHOLD11    0x17
#define FINGER_THRESHOLD12    0x18
#define FINGER_THRESHOLD13    0x19
#define FINGER_THRESHOLD14    0x1A
#define FINGER_THRESHOLD15    0x1B
#define SENSOR_DEBOUNCE     0x1C
#define BUTTON_HYS        0x1D
#define BUTTON_BUT        0x1E
#define BUTTON_LBR        0x1F
#define BUTTON_NNT        0x20
#define BUTTON_NT       0x21
#define PROX_EN         0x26
#define PROX_CFG        0x27
#define PROX_CFG2       0x28
#define PROX_TOUCH_TH0      0x2A
#define PROX_TOUCH_TH1      0x2C
#define PROX_HYS        0x30
#define PROX_BUT        0x31
#define PROX_LBR        0x32
#define PROX_NNT        0x33
#define PROX_NT         0x34
#define PROX_POSITIVE_TH0   0x35
#define PROX_POSITIVE_TH1   0x36
#define PROX_NEGATIVE_TH0   0x39
#define PROX_NEGATIVE_TH1   0x3A
#define LED_ON_TIME       0x3D
#define BUZZER_CFG        0x3E
#define BUZZER_ON_TIME      0x3F
#define GPO_CFG         0x40
#define PWM_DUTYCYCLE_CFG0    0x41
#define PWM_DUTYCYCLE_CFG1    0x42
#define PWM_DUTYCYCLE_CFG2    0x43
#define PWM_DUTYCYCLE_CFG3    0x44
#define PWM_DUTYCYCLE_CFG4    0x45
#define PWM_DUTYCYCLE_CFG5    0x46
#define PWM_DUTYCYCLE_CFG6    0x47
#define PWM_DUTYCYCLE_CFG7    0x48
#define SPO_CFG         0x4C
#define DEVICE_CFG0       0x4D
#define DEVICE_CFG1       0x4E
#define DEVICE_CFG2       0x4F
#define I2C_ADDR        0x51
#define REFRESH_CTRL      0x52
#define STATE_TIMEOUT     0x55
#define SLIDER_CFG        0x5D
#define SLIDER1_CFG       0x61
#define SLIDER1_RESOLUTION    0x62
#define SLIDER1_THRESHOLD   0x63
#define SLIDER2_CFG       0x67
#define SLIDER2_RESOLUTION    0x68
#define SLIDER2_THRESHOLD   0x69
#define SLIDER_DEBOUNCE     0x6F
#define SLIDER_BUT        0x70
#define SLIDER_LBR        0x71
#define SLIDER_NNT        0x72
#define SLIDER_NT       0x73
#define CONFIG_CRC        0x7E
#define GPO_OUTPUT_STATE    0x80
#define SENSOR_ID       0x82
#define CTRL_CMD        0x86
#define BUTTON_STATUS     0xAA
#define PROX_STAT                       0xAE

/* Command Codes */
#define CMD_NULL        0x00
#define SAVE_CHECK_CRC          0x02
#define CALC_CRC                0x03
#define LOAD_FACTORY            0x04
#define LOAD_PRIMARY            0x05
#define LOAD_SECONDARY          0x06
#define SLEEP                   0x07
#define CLEAR_LATCHED_STATUS    0x08
#define CMD_RESET_PROX0_FILTER  0x09
#define CMD_RESET_PROX1_FILTER  0x0A
#define ENTER_CONFIG_MODE       0x0B
#define EXIT_CONTROL_RUN        0xFE
#define SW_RESET                0xFF

/* Total number of configuration registers */
#define TOTAL_CONFIG_REG_COUNT  0x80

/* Length of Register Map */
#define REG_MAP_LEN 256

/* Slave Address (Default) */
#define SLAVE_ADDR  0x37
  
#define NO_OF_KIT_BUTTONS 4

#define BUZ_ON_1_33kHz                  0x85
#define BUZ_OFF_1_33kHz                 0x05
#define SPO_ENABLE              0x03
#define SPO_DISABLE             0x00

   
const int ledpinnumber = 13;      // the number of the LED pin
int readflag=0;

void setup()
{
  pinMode(PB3, OUTPUT);// White
  pinMode(PB4, OUTPUT);// Green
  digitalWrite(PB3, HIGH);
  delay(200);
  digitalWrite(PB3, LOW);
  
  TinyWireM.begin();        // join i2c bus (address optional for master)
  
  configureMBR3();
  digitalWrite(PB3, HIGH);
  delay(200);
  digitalWrite(PB3, LOW);
  delay(1000);
}


void loop()
{
   ReadandDisplaySensorStatus();
}



void configureMBR3()
{
  
//Paste/Initialize the configuration array copied from the IIC file of Ez-Click here under the configData array  
unsigned char configData[128] = {
//Buzzer and Host Int Enabled: Jumper J15 in Configuration A on CY3280-MBR3 Kit
 0x01, 0x00, 0x00, 0x00, 0x00, 0x00, 0x00, 0x00, 0x00, 0x00, 0x00, 0x00, 0x80, 0x7F, 0x7F, 0x7F, 0x7F, 0x7F, 0x7F, 0x7F, 0x7F, 0x7F, 0x7F, 0x7F, 0x7F, 0x7F, 0x7F, 0x7F, 0x03, 0x00, 0x00, 0x00, 0x00, 0x00, 0x00, 0x00, 0x00, 0x00, 0x00, 0x80, 0x05, 0x00, 0x00, 0x02, 0x00, 0x02, 0x00, 0x00, 0x00, 0x00, 0x00, 0x00, 0x00, 0x1E, 0x00, 0x00, 0x00, 0x1E, 0x00, 0x00, 0x00, 0x00, 0x01, 0x01, 0x00, 0xFF, 0xFF, 0xFF, 0xFF, 0xFF, 0xFF, 0xFF, 0xFF, 0x00, 0x00, 0x00, 0x00, 0x03, 0x01, 0x48, 0x00, 0x37, 0x01, 0x00, 0x00, 0x0A, 0x00, 0x00, 0x00, 0x00, 0x00, 0x00, 0x00, 0x00, 0x00, 0x00, 0x00, 0x00, 0x00, 0x00, 0x00, 0x00, 0x00, 0x00, 0x00, 0x00, 0x00, 0x00, 0x00, 0x00, 0x00, 0x00, 0x00, 0x00, 0x00, 0x00, 0x00, 0x00, 0x00, 0x00, 0x00, 0x00, 0x00, 0x00, 0x00, 0x00, 0x5A, 0x79
};

//2 Dummy Writes to Wake up the MBR3 device
TinyWireM.beginTransmission(SLAVE_ADDR); // transmit to device #0x37
TinyWireM.send(REGMAP_ORIGIN);
TinyWireM.send(00);
TinyWireM.endTransmission();

delay(10);
TinyWireM.beginTransmission(SLAVE_ADDR); // transmit to device #0x37
TinyWireM.send(REGMAP_ORIGIN);          // sends Offset byte 
TinyWireM.send(00);
TinyWireM.endTransmission();
/*if(TinyWireM.endTransmission()!=0){
  digitalWrite(PB4, HIGH);
  delay(100);
  digitalWrite(PB4, LOW);
}*/

//Arduino function can send only 32 bytes at a time hence the ConfigData is sent to MBR3 in chunks
TinyWireM.beginTransmission(SLAVE_ADDR); // transmit to device #0x37
TinyWireM.send(REGMAP_ORIGIN);          // sends Offset byte 
for(int i =0; i<31;i++){
  TinyWireM.send(configData[i]);// sends 31 bytes
}
if(TinyWireM.endTransmission()!=0){
  digitalWrite(PB4, HIGH);
  delay(100);
  digitalWrite(PB4, LOW);
  delay(100);
  
}


TinyWireM.beginTransmission(SLAVE_ADDR); // transmit to device #0x37
TinyWireM.send(31);          // sends Offset byte 
for(int i =0; i<31;i++){
  TinyWireM.send(configData[31+i]);        // sends next 31 bytes
}
if(TinyWireM.endTransmission()!=0){
  digitalWrite(PB4, HIGH);
  delay(100);
  digitalWrite(PB4, LOW);
  delay(100);
}

TinyWireM.beginTransmission(SLAVE_ADDR); // transmit to device #0x37
TinyWireM.send(62);          // sends Offset byte
for(int i=0; i<31; i++){ 
  TinyWireM.send(configData[62+i]);        // sends further 31 bytes
}
if(TinyWireM.endTransmission()!=0){
  digitalWrite(PB4, HIGH);
  delay(100);
  digitalWrite(PB4, LOW);
  delay(100);
}
TinyWireM.beginTransmission(SLAVE_ADDR); // transmit to device #0x37
TinyWireM.send(93);          // sends Offset byte 
for(int i=0; i<31; i++){
  TinyWireM.send(configData[93+i]);        // sends 31 bytes
}
if(TinyWireM.endTransmission()!=0){
  digitalWrite(PB4, HIGH);
  delay(100);
  digitalWrite(PB4, LOW);
  delay(100);
}

TinyWireM.beginTransmission(SLAVE_ADDR); // transmit to device #0x37
TinyWireM.send(124);          // sends Offset byte 
for(int i =0; i<4;i++){
  TinyWireM.send(configData[124+i]);        // sends remaining 4 bytes
}
if(TinyWireM.endTransmission()!=0){
  digitalWrite(PB4, HIGH);
  delay(100);
  digitalWrite(PB4, LOW);
  delay(100);
}
TinyWireM.beginTransmission(SLAVE_ADDR); // transmit to device #0x37
TinyWireM.send(CTRL_CMD);
TinyWireM.send(SAVE_CHECK_CRC);
TinyWireM.endTransmission();    // stop transmitting

delay(200);

TinyWireM.beginTransmission(SLAVE_ADDR); // transmit to device #0x37
TinyWireM.send(CTRL_CMD);
TinyWireM.send(SW_RESET);
TinyWireM.endTransmission();    // stop transmitting

//Provide a delay to calculate and Save CRC 
delay(200);

}



void ReadandDisplaySensorStatus() // Interrupt service routine
{
  char c;
  TinyWireM.beginTransmission(SLAVE_ADDR); // transmit to device #0x37
  TinyWireM.send(BUTTON_STATUS);         // sends one byte 
  TinyWireM.endTransmission();    // stop transmitting
  
  TinyWireM.requestFrom(SLAVE_ADDR, 1);    // request 6 bytes from slave device #2
  while(TinyWireM.available())    // slave may send less than requested
  { 
    c = TinyWireM.receive(); // receive a byte as character
    
  }
  TinyWireM.endTransmission();      
  DisplaySensorStatus(c); 
}



void DisplaySensorStatus(char c)
{
  if((c & 0x01)!= 0)toggleGreenLed();
  delay(100);
}

void toggleGreenLed(){
  static int st =0;
  if(!st){
    digitalWrite(PB3,HIGH);
    st=1;
  }
  else{
    digitalWrite(PB3,LOW);
    st=0;
  }
}
