ChriD/konnekting-TouchButtonSwitch/(commit log)

2018-07-06 Rev 2
    [4ButtonSwitch.Rev2.brd, 4ButtonSwitch.Rev2.sch]
2018-07-09 Rev 2.1
    [4ButtonSwitch.Rev2.1.brd, 4ButtonSwitch.Rev2.1.sch]
2018-08-30 update for cost efficient board manufacturing
    [4ButtonSwitch.Rev2.2.brd]
