ChriD/konnekting-TouchButtonSwitch/(notices)

Notices in the files:
parts and their libraries:
tag-connect: ©2009 ROFA.cz - modified and updated by Robert Darlington ‹rdarlington@gmail.com›
Wurth_Elektronik_Optoelectronics_rev15b: Copyright: Würth Elektronik
PatternAgents-ProtoPads: License : http://creativecommons.org/licenses/by-sa/4.0
(Creative Commons 4.0)
